EmbeddedSystemClass/2019-Animal-Collars/README.md

# 2019-Animal-Collars
GVSU Animal Tracking Collars - 2019
