EmbeddedSystemClass/2019-Animal-Collars/20190724_212704.jpg

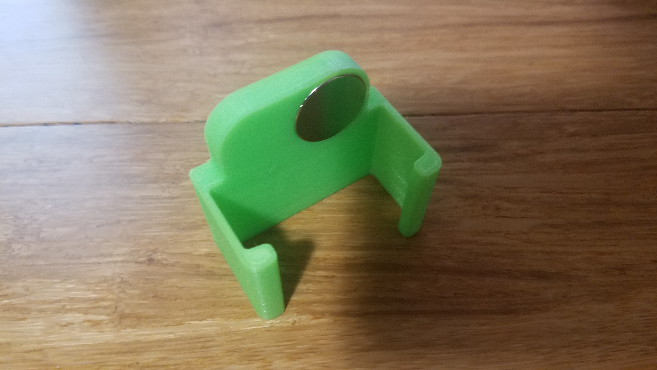
20190724_212704.jpg
