EmbeddedSystemClass/2019-Animal-Collars/Mechanical Source/2019 Animal Collar - 3D Data/2019 Animal Collar Enclosure Assembly/2019_Animal_Collar_Assm.SLDASM

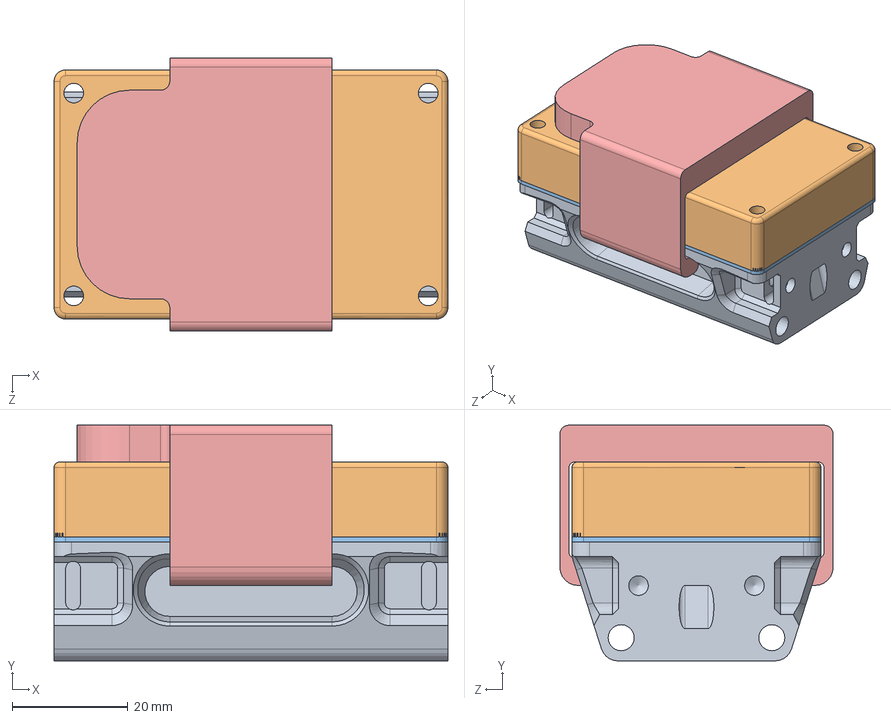
[picture p5: CAD file, 2019-07-27]
Mechanical Source/2019 Animal Collar - 3D Data/2019 Animal Collar Enclosure Assembly/2019_Animal_Collar_Assm.SLDASM
68.0 x 40.7 x 47.2 mm
Enclsoure_Bottom
Enclosure_Lid
EPDM_Gasket
pcbRevAB 6-5-19
Magnet Clip
