EmbeddedSystemClass/2019-Animal-Collars/COLLAR STRAP_CAD/COLLAR STRAP_V3/COLLAR_MEASUREMENT_PLAY.SLDASM

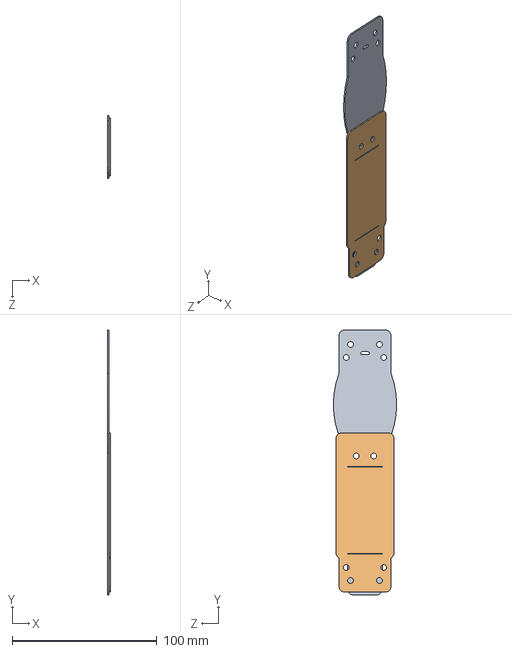
[picture p6: CAD file, 2019-09-28]
COLLAR STRAP_CAD/COLLAR STRAP_V3/COLLAR_MEASUREMENT_PLAY.SLDASM
2.00 x 183.0 x 43.7 mm
ANTENNA_STRAP 001_V3
SHORT_STRAP 001_V3
