EmbeddedSystemClass/2019-Animal-Collars/COLLAR STRAP_CAD/COLLAR STRAP_V3/SHORT_STRAP 002_V3.SLDPRT

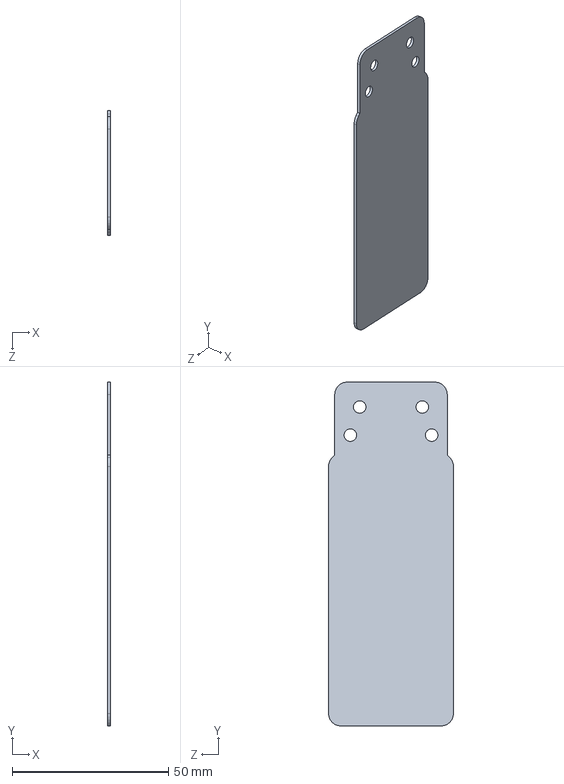
[picture p7: CAD file, 2019-09-28]
COLLAR STRAP_CAD/COLLAR STRAP_V3/SHORT_STRAP 002_V3.SLDPRT
1.00 x 110.0 x 40.0 mm
