EmbeddedSystemClass/2019-Animal-Collars/COLLAR STRAP_CAD/SMALL COLLAR/SMALL_COLLAR_V0.SLDPRT

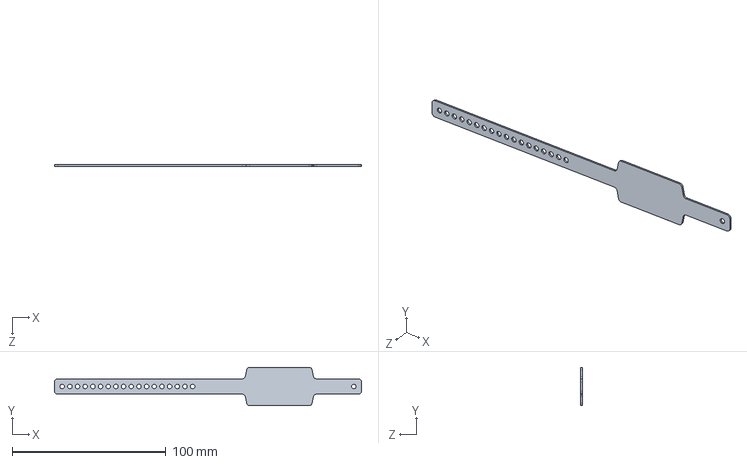
[picture p8: CAD file, 2019-09-28]
COLLAR STRAP_CAD/SMALL COLLAR/SMALL_COLLAR_V0.SLDPRT
200.0 x 25.0 x 1.00 mm
