EmbeddedSystemClass/2019-Animal-Collars/Mechanical Source/2019 Animal Collar - 3D Data/Magnet Clipsmall.STL

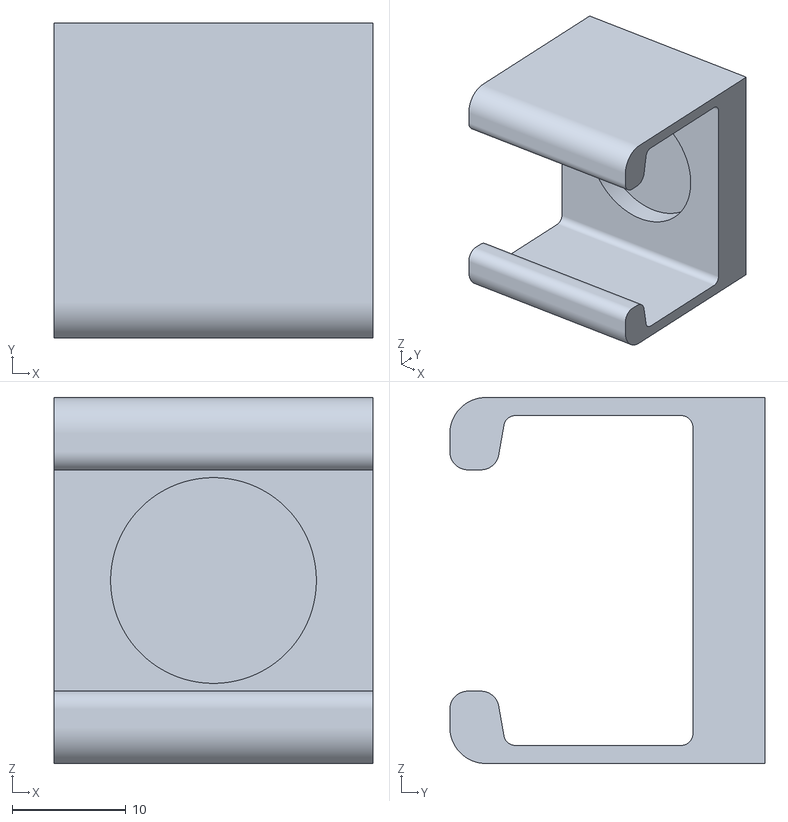
[picture p9: CAD file, 2019-08-06]
Mechanical Source/2019 Animal Collar - 3D Data/Magnet Clipsmall.STL
28.0 x 27.7 x 32.1
