EmbeddedSystemClass/2019-Animal-Collars/Mechanical Source/2019 Animal Collar - 3D Data/OBS/Magnet Clip.STL

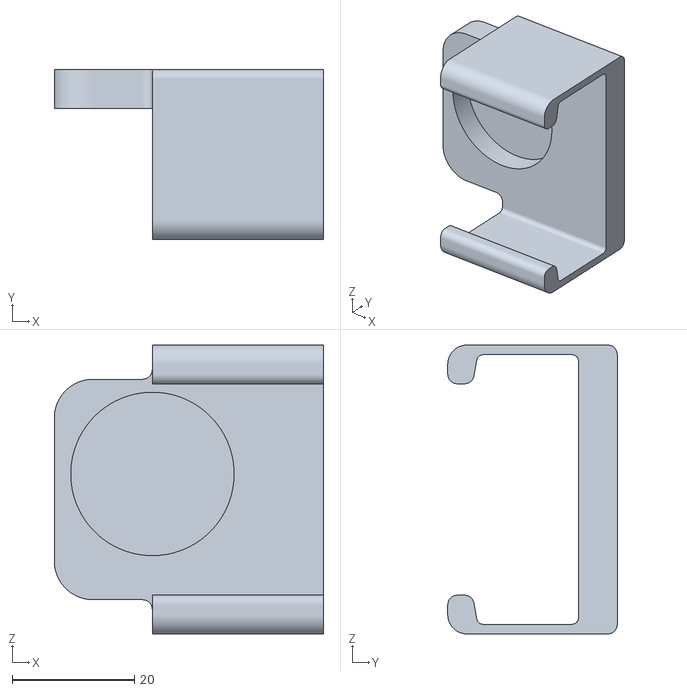
[picture p10: CAD file, 2019-07-27]
Mechanical Source/2019 Animal Collar - 3D Data/OBS/Magnet Clip.STL
44.0 x 27.7 x 47.2
