EmbeddedSystemClass/2019-Animal-Collars/COLLAR STRAP_CAD/COLLAR STRAP_V3/ANTENNA_STRAP 002_V3.SLDPRT

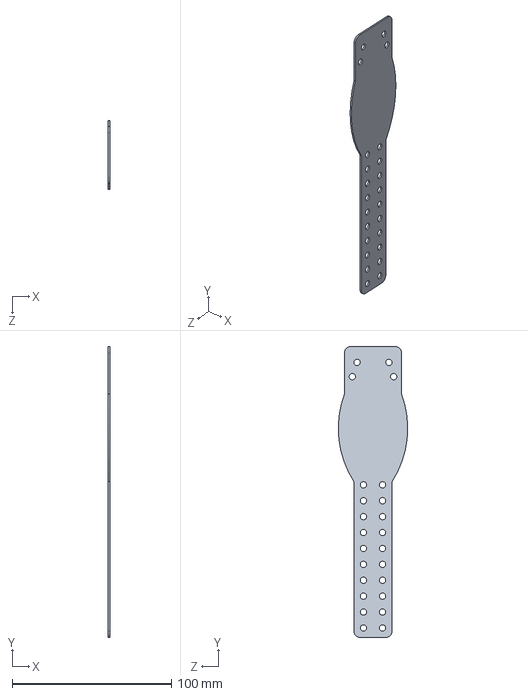
[picture p12: CAD file, 2019-09-28]
COLLAR STRAP_CAD/COLLAR STRAP_V3/ANTENNA_STRAP 002_V3.SLDPRT
1.00 x 183.0 x 43.7 mm
