EmbeddedSystemClass/2019-Animal-Collars/Mechanical Source/2019 Animal Collar - 3D Data/2019 Animal Collar Enclosure Assembly/pcbRevAB 6-5-19.SLDPRT

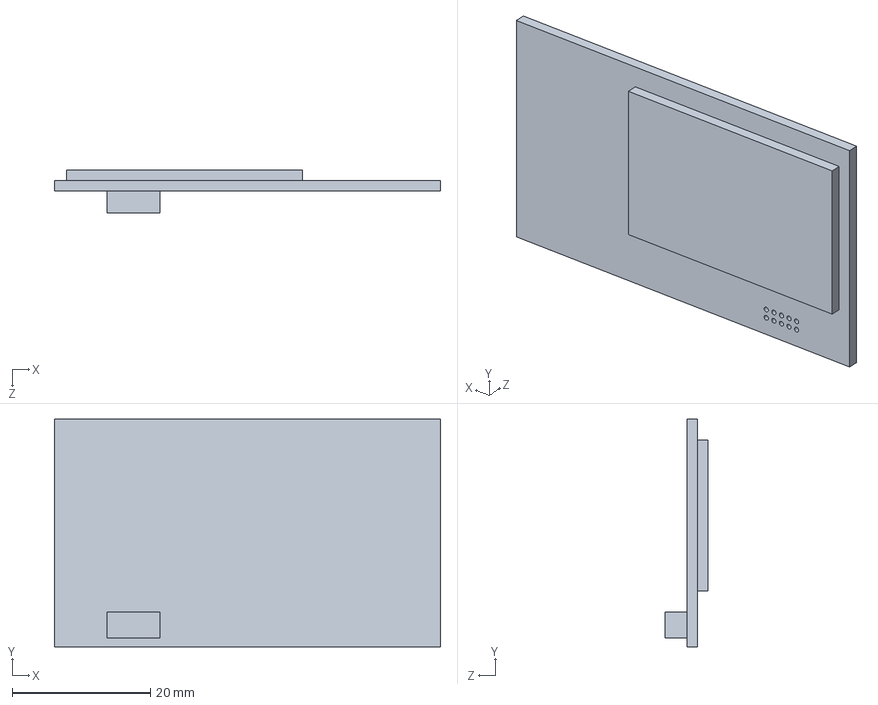
[picture p13: CAD file, 2019-07-27]
Mechanical Source/2019 Animal Collar - 3D Data/2019 Animal Collar Enclosure Assembly/pcbRevAB 6-5-19.SLDPRT
55.9 x 33.0 x 6.21 mm
