EmbeddedSystemClass/2019-Animal-Collars/Mechanical Source/2019 Animal Collar - 3D Data/Magnet Clip For Neodymium Magnet.STL

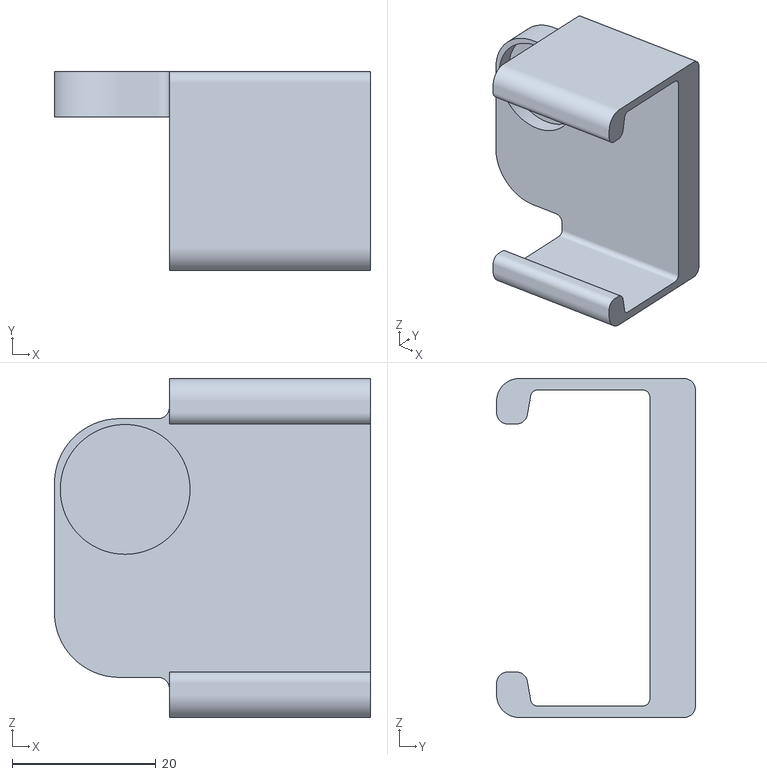
[picture p14: CAD file, 2019-07-27]
Mechanical Source/2019 Animal Collar - 3D Data/Magnet Clip For Neodymium Magnet.STL
44.0 x 27.7 x 47.2
