EmbeddedSystemClass/2019-Animal-Collars/Mechanical Source/DXF/Enclsoure_Bottom.DXF

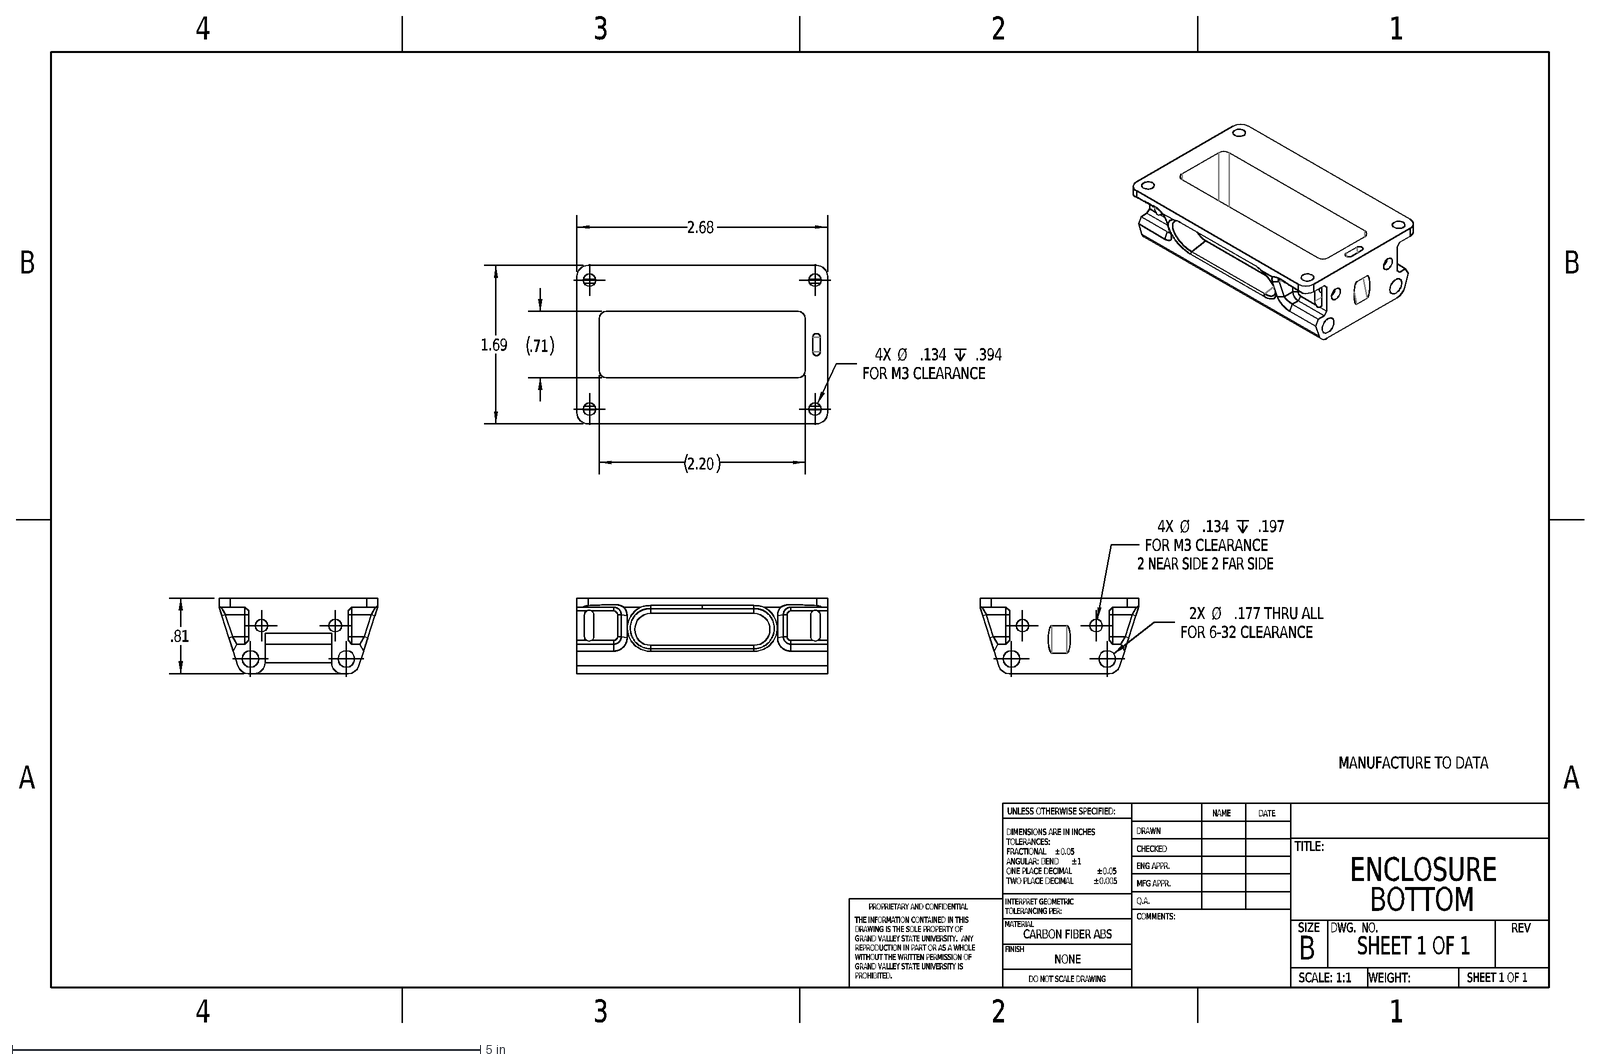
[picture p15: CAD file, 2019-07-27]
Mechanical Source/DXF/Enclsoure_Bottom.DXF
MANUFACTURE TO DATA
CARBON FIBER ABS
ENCLOSURE
BOTTOM
DO NOT SCALE DRAWING
SHEET 1 OF 1
UNLESS OTHERWISE SPECIFIED:
SCALE: 1:1
WEIGHT:
REV
DWG. NO.
B
SIZE
TITLE:
NAME
DATE
COMMENTS:
Q.A.
MFG APPR.
ENG APPR.
CHECKED
DRAWN
NONE
FINISH
MATERIAL
INTERPRET GEOMETRIC
TOLERANCING PER:
DIMENSIONS ARE IN INCHES
TOLERANCES:
FRACTIONAL
±
0.05
ANGULAR: BEND
1
ONE PLACE DECIMAL
TWO PLACE DECIMAL
0.005
PROPRIETARY AND CONFIDENTIAL
THE INFORMATION CONTAINED IN THIS
DRAWING IS THE SOLE PROPERTY OF
GRAND VALLEY STATE UNIVERSITY. ANY
REPRODUCTION IN PART OR AS A WHOLE
WITHOUT THE WRITTEN PERMISSION OF
GRAND VALLEY STATE UNIVERSITY IS
PROHIBITED.
A
4
3
2
2.68
1.69
4X
Ø
.134
.394
FOR M3 CLEARANCE
2.20
.71
.197
2 NEAR SIDE 2 FAR SIDE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
