EmbeddedSystemClass/2019-Animal-Collars/Mechanical Source/2019 Animal Collar - 3D Data/2019 Animal Collar Enclosure Assembly/Enclosure_Lid.SLDPRT

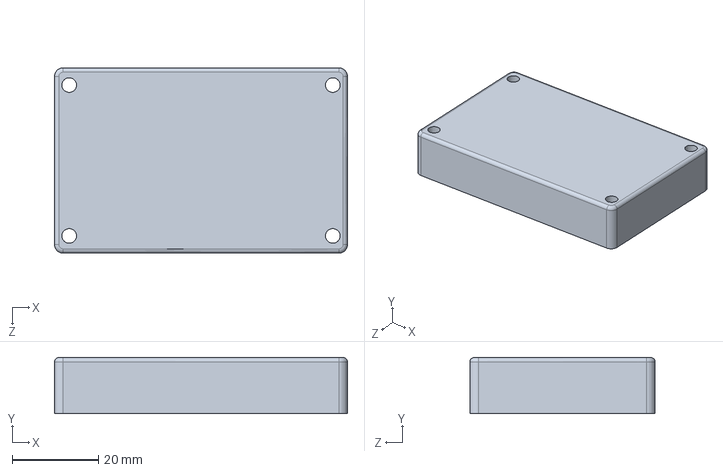
[picture p16: CAD file, 2019-07-27]
Mechanical Source/2019 Animal Collar - 3D Data/2019 Animal Collar Enclosure Assembly/Enclosure_Lid.SLDPRT
68.0 x 13.0 x 43.0 mm
