EmbeddedSystemClass/2019-Animal-Collars/Mechanical Source/2019 Animal Collar - 3D Data/2019 Animal Collar Enclosure Assembly/Enclsoure_Bottom.SLDPRT

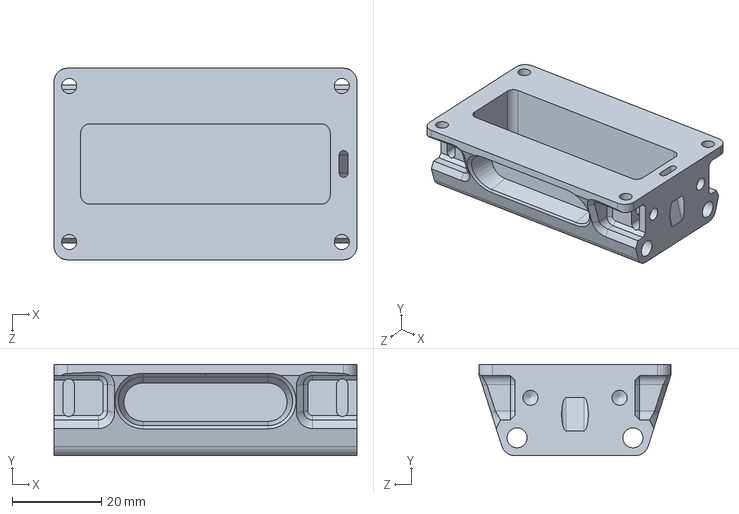
[picture p18: CAD file, 2019-07-27]
Mechanical Source/2019 Animal Collar - 3D Data/2019 Animal Collar Enclosure Assembly/Enclsoure_Bottom.SLDPRT
68.0 x 20.5 x 43.0 mm
