EmbeddedSystemClass/2019-Animal-Collars/Mechanical Source/2019 Animal Collar Enclosure Assembly/EPDM_Gasket.SLDPRT

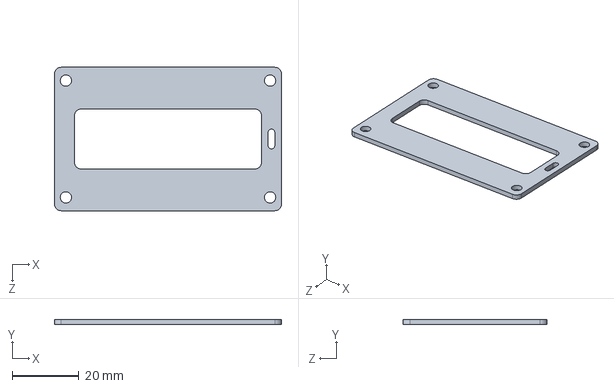
[picture p19: CAD file, 2019-07-27]
Mechanical Source/2019 Animal Collar Enclosure Assembly/EPDM_Gasket.SLDPRT
68.0 x 1.60 x 43.0 mm
