EmbeddedSystemClass/2019-Animal-Collars/Mechanical Source/DXF/2019_Animal_Collar_Assm.DXF

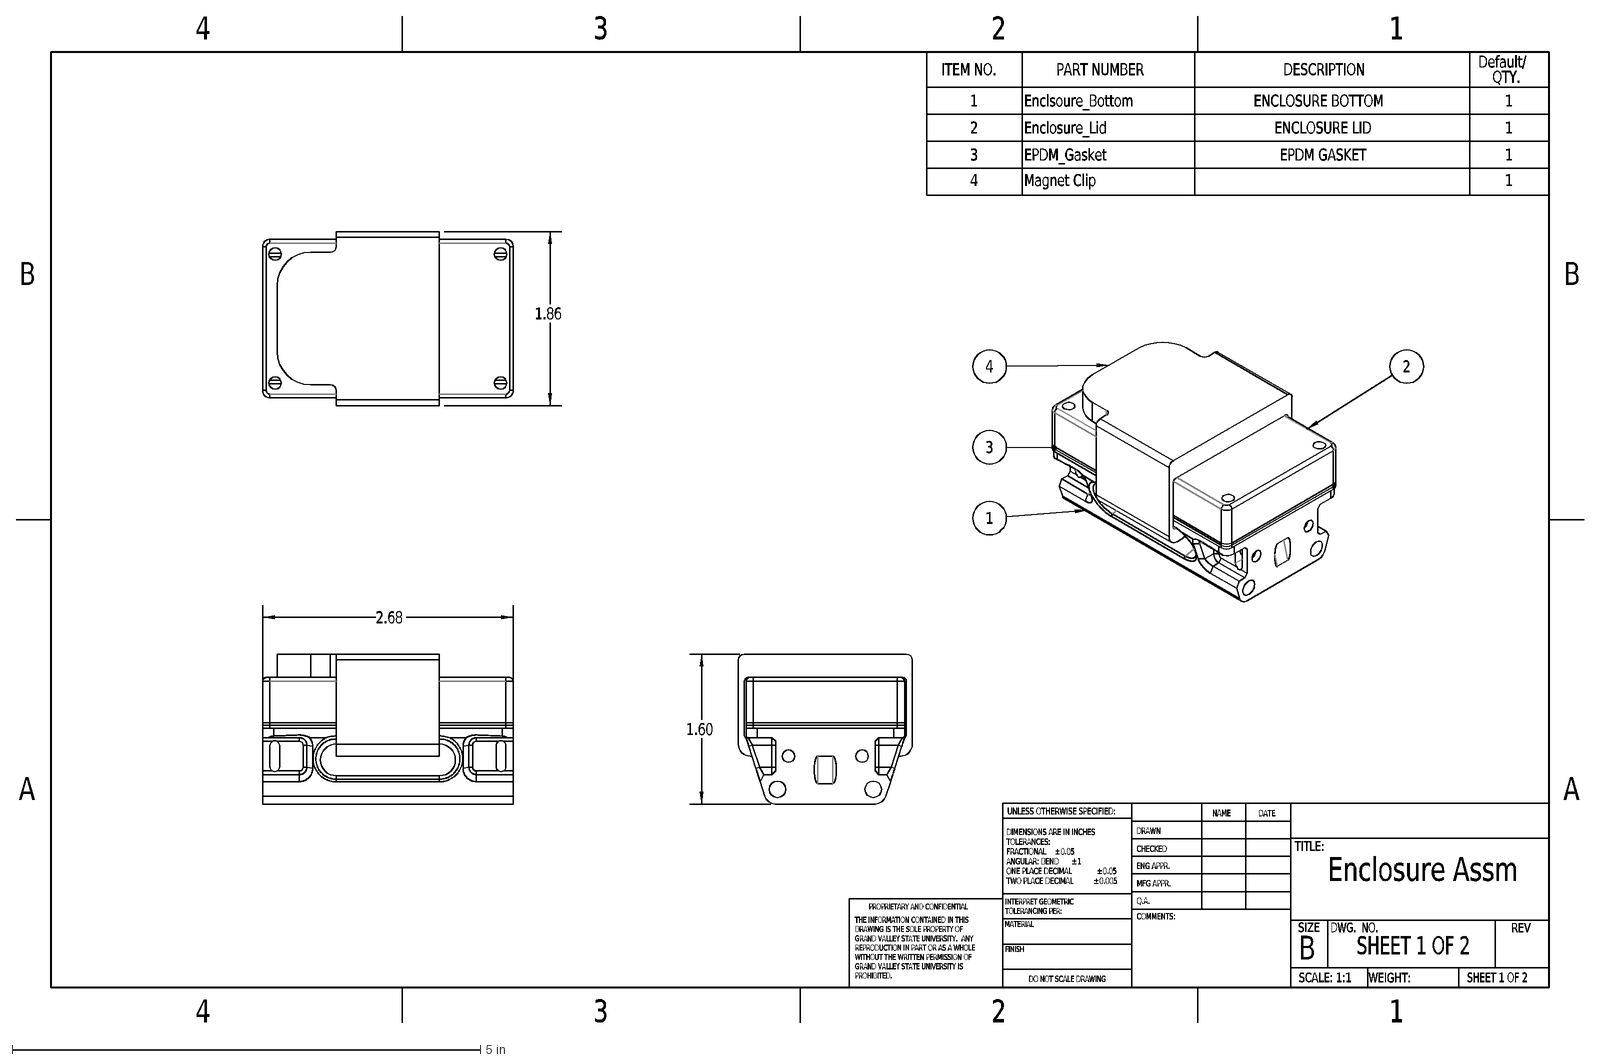
[picture p20: CAD file, 2019-07-27]
Mechanical Source/DXF/2019_Animal_Collar_Assm.DXF
A
B
4
3
2
1
Enclosure Assm
DO NOT SCALE DRAWING
SHEET 1 OF 2
UNLESS OTHERWISE SPECIFIED:
SCALE: 1:1
WEIGHT:
REV
DWG. NO.
SIZE
TITLE:
NAME
DATE
COMMENTS:
Q.A.
MFG APPR.
ENG APPR.
CHECKED
DRAWN
FINISH
MATERIAL
INTERPRET GEOMETRIC
TOLERANCING PER:
DIMENSIONS ARE IN INCHES
TOLERANCES:
FRACTIONAL
±
0.05
ANGULAR: BEND
ONE PLACE DECIMAL
TWO PLACE DECIMAL
0.005
PROPRIETARY AND CONFIDENTIAL
THE INFORMATION CONTAINED IN THIS
DRAWING IS THE SOLE PROPERTY OF
GRAND VALLEY STATE UNIVERSITY. ANY
REPRODUCTION IN PART OR AS A WHOLE
WITHOUT THE WRITTEN PERMISSION OF
GRAND VALLEY STATE UNIVERSITY IS
PROHIBITED.
ITEM NO.
PART NUMBER
DESCRIPTION
Default/
QTY.
Enclsoure_Bottom
ENCLOSURE BOTTOM
Enclosure_Lid
ENCLOSURE LID
EPDM_Gasket
EPDM GASKET
Magnet Clip
2.68
1.86
1.60
