EmbeddedSystemClass/2019-Animal-Collars/Mechanical Source/DXF/Enclosure_Lid.DXF

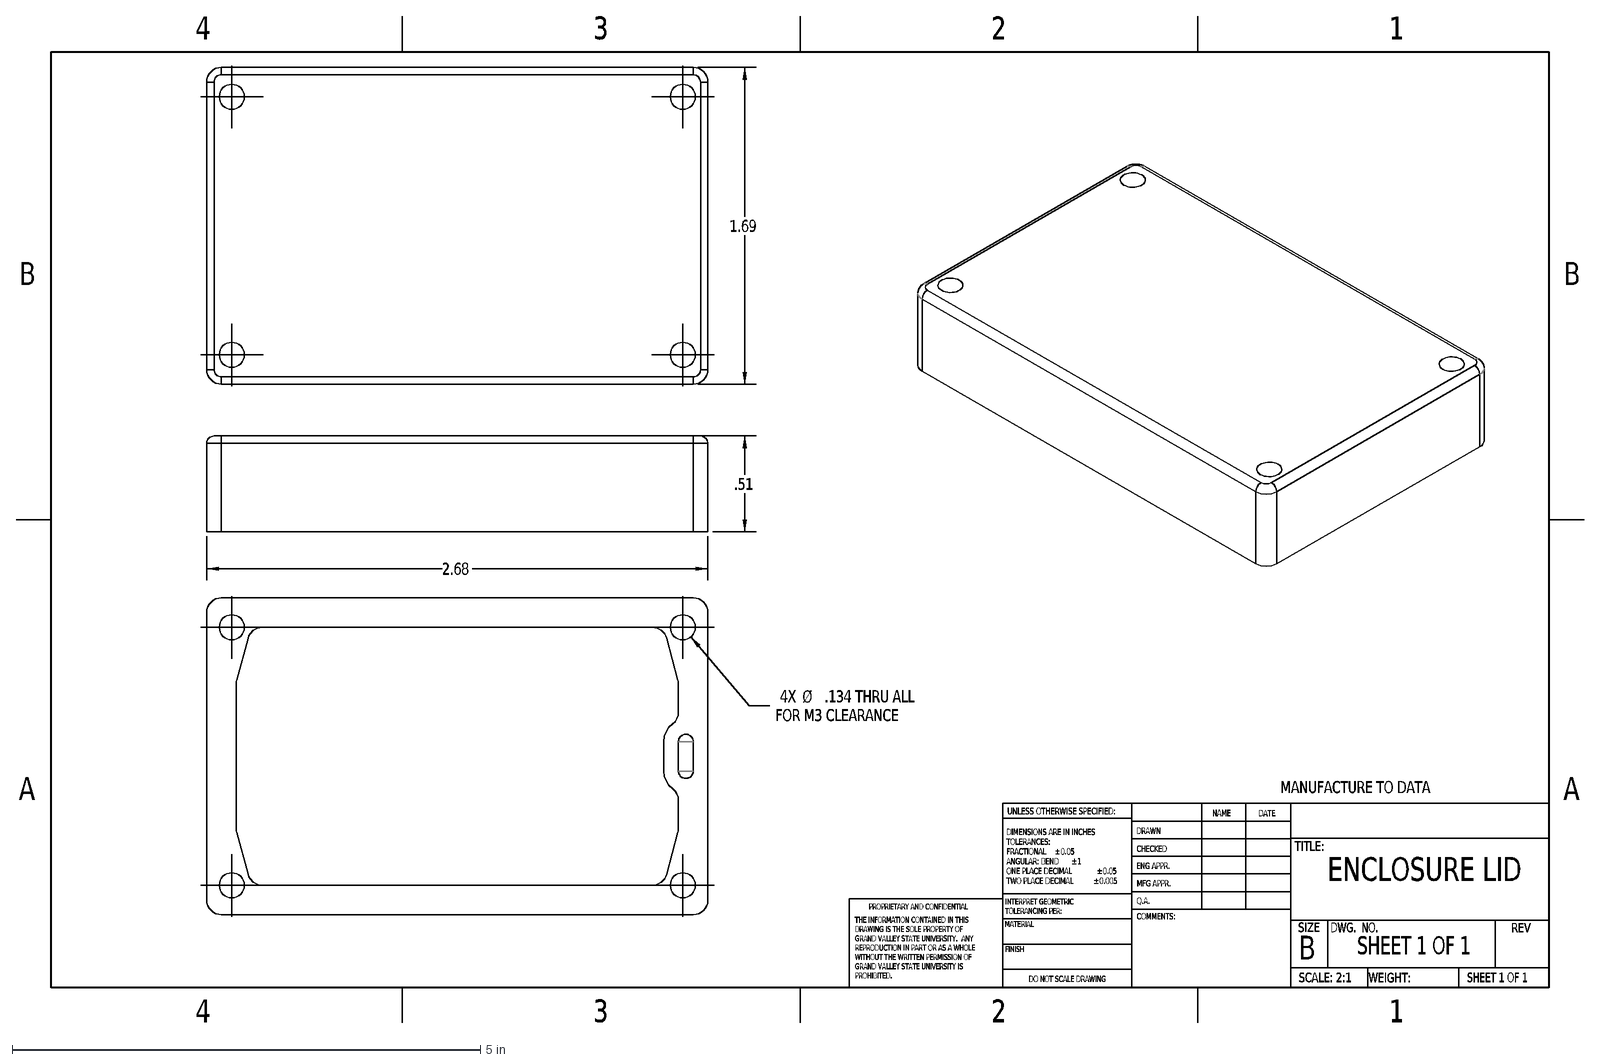
[picture p21: CAD file, 2019-07-27]
Mechanical Source/DXF/Enclosure_Lid.DXF
MANUFACTURE TO DATA
A
B
4
3
2
1
ENCLOSURE LID
DO NOT SCALE DRAWING
SHEET 1 OF 1
UNLESS OTHERWISE SPECIFIED:
SCALE: 2:1
WEIGHT:
REV
DWG. NO.
SIZE
TITLE:
NAME
DATE
COMMENTS:
Q.A.
MFG APPR.
ENG APPR.
CHECKED
DRAWN
FINISH
MATERIAL
INTERPRET GEOMETRIC
TOLERANCING PER:
DIMENSIONS ARE IN INCHES
TOLERANCES:
FRACTIONAL
±
0.05
ANGULAR: BEND
ONE PLACE DECIMAL
TWO PLACE DECIMAL
0.005
PROPRIETARY AND CONFIDENTIAL
THE INFORMATION CONTAINED IN THIS
DRAWING IS THE SOLE PROPERTY OF
GRAND VALLEY STATE UNIVERSITY. ANY
REPRODUCTION IN PART OR AS A WHOLE
WITHOUT THE WRITTEN PERMISSION OF
GRAND VALLEY STATE UNIVERSITY IS
PROHIBITED.
2.68
.51
1.69
4X
Ø
.134 THRU ALL
FOR M3 CLEARANCE
