EmbeddedSystemClass/2019-Animal-Collars/(list of files, cad)

Other CAD files:
Mechanical Source/2019 Animal Collar Enclosure Assembly/Magnet Clipsmall.SLDPRT
Mechanical Source/2019 Animal Collar Enclosure Assembly/Magnet Clip.SLDPRT
COLLAR STRAP_CAD/COLLAR STRAP_V3/SHORT_STRAP 001_V3.SLDPRT
COLLAR STRAP_CAD/COLLAR STRAP_V3/ANTENNA_STRAP 001_V3.SLDPRT
Mechanical Source/2019 Animal Collar - 3D Data/2019 Animal Collar Enclosure Assembly/Magnet Clip.SLDPRT
Mechanical Source/DXF/Magnet Clip.DXF
COLLAR STRAP_CAD/COLLAR STRAP_V2/ANTENNA_STRAP 001_V2.SLDDRW
COLLAR STRAP_CAD/COLLAR STRAP_V2/ANTENNA_STRAP 001_V2.SLDPRT
COLLAR STRAP_CAD/COLLAR STRAP_V2/ANTENNA_STRAP 001_V2_LaserCut.SLDDRW
COLLAR STRAP_CAD/COLLAR STRAP_V2/ANTENNA_STRAP 001_V2_ManualCut.SLDDRW
COLLAR STRAP_CAD/COLLAR STRAP_V2/ANTENNA_STRAP 002_V2.SLDDRW
COLLAR STRAP_CAD/COLLAR STRAP_V2/ANTENNA_STRAP 002_V2.SLDPRT
COLLAR STRAP_CAD/COLLAR STRAP_V2/ANTENNA_STRAP 002_V2_LaserCut.SLDDRW
COLLAR STRAP_CAD/COLLAR STRAP_V2/ANTENNA_STRAP 002_V2_ManualCut.SLDDRW
COLLAR STRAP_CAD/COLLAR STRAP_V2/Collar_Measurement_TESTING.SLDASM
COLLAR STRAP_CAD/COLLAR STRAP_V2/SHORT_STRAP 001_V2.SLDDRW
COLLAR STRAP_CAD/COLLAR STRAP_V2/SHORT_STRAP 001_V2.SLDPRT
COLLAR STRAP_CAD/COLLAR STRAP_V2/SHORT_STRAP 001_V2_LaserCut.SLDDRW
COLLAR STRAP_CAD/COLLAR STRAP_V2/SHORT_STRAP 001_V2_ManualCut.SLDDRW
COLLAR STRAP_CAD/COLLAR STRAP_V2/SHORT_STRAP 002_V2.SLDDRW
COLLAR STRAP_CAD/COLLAR STRAP_V2/SHORT_STRAP 002_V2.SLDPRT
COLLAR STRAP_CAD/COLLAR STRAP_V2/SHORT_STRAP 002_V2_LaserCut.SLDDRW
COLLAR STRAP_CAD/COLLAR STRAP_V2/SHORT_STRAP 002_V2_ManualCut.SLDDRW
COLLAR STRAP_CAD/COLLAR STRAP_V3/ANTENNA_STRAP 001_V3.SLDDRW
COLLAR STRAP_CAD/COLLAR STRAP_V3/ANTENNA_STRAP 001_V3_LaserCut.SLDDRW
COLLAR STRAP_CAD/COLLAR STRAP_V3/ANTENNA_STRAP 001_V3_ManualCut.SLDDRW
COLLAR STRAP_CAD/COLLAR STRAP_V3/ANTENNA_STRAP 002_V3.SLDDRW
COLLAR STRAP_CAD/COLLAR STRAP_V3/ANTENNA_STRAP 002_V3_LaserCut.SLDDRW
COLLAR STRAP_CAD/COLLAR STRAP_V3/ANTENNA_STRAP 002_V3_ManualCut.SLDDRW
COLLAR STRAP_CAD/COLLAR STRAP_V3/SHORT_STRAP 001_V3.SLDDRW
COLLAR STRAP_CAD/COLLAR STRAP_V3/SHORT_STRAP 001_V3_LaserCut.SLDDRW
COLLAR STRAP_CAD/COLLAR STRAP_V3/SHORT_STRAP 001_V3_ManualCut.SLDDRW
COLLAR STRAP_CAD/COLLAR STRAP_V3/SHORT_STRAP 002_V3.SLDDRW
COLLAR STRAP_CAD/COLLAR STRAP_V3/SHORT_STRAP 002_V3_LaserCut.SLDDRW
COLLAR STRAP_CAD/COLLAR STRAP_V3/SHORT_STRAP 002_V3_ManualCut.SLDDRW
COLLAR STRAP_CAD/SMALL COLLAR/SMALL_COLLAR_V0.SLDDRW
COLLAR STRAP_CAD/SMALL COLLAR/SMALL_COLLAR_V0_LaserCut.SLDDRW
COLLAR STRAP_CAD/SMALL COLLAR/SMALL_COLLAR_V0_ManualCut.SLDDRW
COLLAR STRAP_OBSOLETE/110MM STRAP 001.SLDPRT
COLLAR STRAP_OBSOLETE/110MM STRAP 001_LaserCut.SLDDRW
COLLAR STRAP_OBSOLETE/110MM STRAP 001_ManualCut.SLDDRW
COLLAR STRAP_OBSOLETE/110MM STRAP 001_OBSOLETE.SLDPRT
COLLAR STRAP_OBSOLETE/110MM STRAP 001_OBSOLETE_ManualCut.SLDDRW
COLLAR STRAP_OBSOLETE/110MM STRAP.DXF
COLLAR STRAP_OBSOLETE/110MM STRAP_OBSOLETE.SLDDRW
COLLAR STRAP_OBSOLETE/200MM STRAP 001.SLDPRT
COLLAR STRAP_OBSOLETE/200MM STRAP 001_LaserCut.SLDDRW
COLLAR STRAP_OBSOLETE/200MM STRAP 001_ManCut.SLDDRW
COLLAR STRAP_OBSOLETE/200MM STRAP 002.SLDPRT
COLLAR STRAP_OBSOLETE/200MM STRAP 002_ManualCut.SLDDRW
COLLAR STRAP_OBSOLETE/200MM STRAP.DXF
COLLAR STRAP_OBSOLETE/200MM STRAP.SLDDRW
COLLAR STRAP_OBSOLETE/Collar Belting_110_v0.SLDPRT
COLLAR STRAP_OBSOLETE/Collar Belting_200_v0.SLDPRT
Mechanical Source/2019 Animal Collar Enclosure Assembly/2019_Animal_Collar_Assm.SLDDRW
Mechanical Source/2019 Animal Collar Enclosure Assembly/EPDM_Gasket.SLDDRW
Mechanical Source/2019 Animal Collar Enclosure Assembly/Enclosure_Lid.SLDDRW
Mechanical Source/2019 Animal Collar Enclosure Assembly/Enclsoure_Bottom.SLDDRW
Mechanical Source/2019 Animal Collar Enclosure Assembly/Magnet Clip.SLDDRW
