EmbeddedSystemClass/2019-Animal-Collars/Electrical Source/Firmware/MDK-ARM/TEST/AnimalCollar.htm

# Static Call Graph for image TEST\AnimalCollar.axf

#<CALLGRAPH># ARM Linker, 6120001: Last Updated: Tue Aug 6 14:20:58 2019

### Maximum Stack Usage = 768 bytes + Unknown(Cycles, Untraceable Function Pointers)

### Call chain for Maximum Stack Depth:

main ⇒ GPS_subroutine ⇒ GPS_getNMEA ⇒ atoi ⇒ strtol ⇒ _strtoul

### Mutually Recursive functions

- ADC1_COMP_IRQHandler ⇒ ADC1_COMP_IRQHandler

### Function Pointers

- ADC1_COMP_IRQHandler from startup_stm32l071xx.o(.text) referenced from startup_stm32l071xx.o(RESET)
- DMA1_Channel1_IRQHandler from startup_stm32l071xx.o(.text) referenced from startup_stm32l071xx.o(RESET)
- DMA1_Channel2_3_IRQHandler from startup_stm32l071xx.o(.text) referenced from startup_stm32l071xx.o(RESET)
- DMA1_Channel4_5_6_7_IRQHandler from startup_stm32l071xx.o(.text) referenced from startup_stm32l071xx.o(RESET)
- EXTI0_1_IRQHandler from startup_stm32l071xx.o(.text) referenced from startup_stm32l071xx.o(RESET)
- EXTI2_3_IRQHandler from startup_stm32l071xx.o(.text) referenced from startup_stm32l071xx.o(RESET)
- EXTI4_15_IRQHandler from startup_stm32l071xx.o(.text) referenced from startup_stm32l071xx.o(RESET)
- FLASH_IRQHandler from startup_stm32l071xx.o(.text) referenced from startup_stm32l071xx.o(RESET)
- HardFault_Handler from stm32l0xx_it.o(.text.HardFault_Handler) referenced from startup_stm32l071xx.o(RESET)
- I2C1_IRQHandler from startup_stm32l071xx.o(.text) referenced from startup_stm32l071xx.o(RESET)
- I2C2_IRQHandler from startup_stm32l071xx.o(.text) referenced from startup_stm32l071xx.o(RESET)
- I2C3_IRQHandler from startup_stm32l071xx.o(.text) referenced from startup_stm32l071xx.o(RESET)
- LPTIM1_IRQHandler from startup_stm32l071xx.o(.text) referenced from startup_stm32l071xx.o(RESET)
- LPUART1_IRQHandler from startup_stm32l071xx.o(.text) referenced from startup_stm32l071xx.o(RESET)
- NMI_Handler from stm32l0xx_it.o(.text.NMI_Handler) referenced from startup_stm32l071xx.o(RESET)
- PVD_IRQHandler from startup_stm32l071xx.o(.text) referenced from startup_stm32l071xx.o(RESET)
- PendSV_Handler from stm32l0xx_it.o(.text.PendSV_Handler) referenced from startup_stm32l071xx.o(RESET)
- RCC_IRQHandler from startup_stm32l071xx.o(.text) referenced from startup_stm32l071xx.o(RESET)
- RTC_IRQHandler from stm32l0xx_it.o(.text.RTC_IRQHandler) referenced from startup_stm32l071xx.o(RESET)
- Reset_Handler from startup_stm32l071xx.o(.text) referenced from startup_stm32l071xx.o(RESET)
- SPI1_IRQHandler from stm32l0xx_it.o(.text.SPI1_IRQHandler) referenced from startup_stm32l071xx.o(RESET)
- SPI2_IRQHandler from startup_stm32l071xx.o(.text) referenced from startup_stm32l071xx.o(RESET)
- SVC_Handler from stm32l0xx_it.o(.text.SVC_Handler) referenced from startup_stm32l071xx.o(RESET)
- SysTick_Handler from stm32l0xx_it.o(.text.SysTick_Handler) referenced from startup_stm32l071xx.o(RESET)
- SystemInit from system_stm32l0xx.o(.text.SystemInit) referenced from startup_stm32l071xx.o(.text)
- TIM21_IRQHandler from startup_stm32l071xx.o(.text) referenced from startup_stm32l071xx.o(RESET)
- TIM22_IRQHandler from startup_stm32l071xx.o(.text) referenced from startup_stm32l071xx.o(RESET)
- TIM2_IRQHandler from stm32l0xx_it.o(.text.TIM2_IRQHandler) referenced from startup_stm32l071xx.o(RESET)
- TIM3_IRQHandler from startup_stm32l071xx.o(.text) referenced from startup_stm32l071xx.o(RESET)
- TIM6_IRQHandler from startup_stm32l071xx.o(.text) referenced from startup_stm32l071xx.o(RESET)
- TIM7_IRQHandler from startup_stm32l071xx.o(.text) referenced from startup_stm32l071xx.o(RESET)
- USART1_IRQHandler from stm32l0xx_it.o(.text.USART1_IRQHandler) referenced from startup_stm32l071xx.o(RESET)
- USART2_IRQHandler from startup_stm32l071xx.o(.text) referenced from startup_stm32l071xx.o(RESET)
- USART4_5_IRQHandler from stm32l0xx_it.o(.text.USART4_5_IRQHandler) referenced from startup_stm32l071xx.o(RESET)
- WWDG_IRQHandler from startup_stm32l071xx.o(.text) referenced from startup_stm32l071xx.o(RESET)
- __main from entry.o(.ARM.Collect$$$$00000000) referenced from startup_stm32l071xx.o(.text)
- _sputc from printfa.o(i._sputc) referenced from printfa.o(i.__0sprintf)
- main from main.o(.text.main) referenced from entry9a.o(.ARM.Collect$$$$0000000B)

### Global Symbols

__main (Thumb, 0 bytes, Stack size unknown bytes, entry.o(.ARM.Collect$$$$00000000))
[Address Reference Count : 1]

- startup_stm32l071xx.o(.text)

_main_stk (Thumb, 0 bytes, Stack size unknown bytes, entry2.o(.ARM.Collect$$$$00000001))

_main_scatterload (Thumb, 0 bytes, Stack size unknown bytes, entry5.o(.ARM.Collect$$$$00000004))

[Calls]

- >> __scatterload

__main_after_scatterload (Thumb, 0 bytes, Stack size unknown bytes, entry5.o(.ARM.Collect$$$$00000004))

[Called By]

- >> __scatterload

_main_clock (Thumb, 0 bytes, Stack size unknown bytes, entry7b.o(.ARM.Collect$$$$00000008))

_main_cpp_init (Thumb, 0 bytes, Stack size unknown bytes, entry8b.o(.ARM.Collect$$$$0000000A))

_main_init (Thumb, 0 bytes, Stack size unknown bytes, entry9a.o(.ARM.Collect$$$$0000000B))

__rt_final_cpp (Thumb, 0 bytes, Stack size unknown bytes, entry10a.o(.ARM.Collect$$$$0000000D))

__rt_final_exit (Thumb, 0 bytes, Stack size unknown bytes, entry11a.o(.ARM.Collect$$$$0000000F))

Reset_Handler (Thumb, 8 bytes, Stack size 0 bytes, startup_stm32l071xx.o(.text))
[Address Reference Count : 1]

- startup_stm32l071xx.o(RESET)

ADC1_COMP_IRQHandler (Thumb, 0 bytes, Stack size 0 bytes, startup_stm32l071xx.o(.text))

[Calls]

- >> ADC1_COMP_IRQHandler

[Called By]

- >> ADC1_COMP_IRQHandler

[Address Reference Count : 1]

- startup_stm32l071xx.o(RESET)

DMA1_Channel1_IRQHandler (Thumb, 0 bytes, Stack size 0 bytes, startup_stm32l071xx.o(.text))
[Address Reference Count : 1]

- startup_stm32l071xx.o(RESET)

DMA1_Channel2_3_IRQHandler (Thumb, 0 bytes, Stack size 0 bytes, startup_stm32l071xx.o(.text))
[Address Reference Count : 1]

- startup_stm32l071xx.o(RESET)

DMA1_Channel4_5_6_7_IRQHandler (Thumb, 0 bytes, Stack size 0 bytes, startup_stm32l071xx.o(.text))
[Address Reference Count : 1]

- startup_stm32l071xx.o(RESET)

EXTI0_1_IRQHandler (Thumb, 0 bytes, Stack size 0 bytes, startup_stm32l071xx.o(.text))
[Address Reference Count : 1]

- startup_stm32l071xx.o(RESET)

EXTI2_3_IRQHandler (Thumb, 0 bytes, Stack size 0 bytes, startup_stm32l071xx.o(.text))
[Address Reference Count : 1]

- startup_stm32l071xx.o(RESET)

EXTI4_15_IRQHandler (Thumb, 0 bytes, Stack size 0 bytes, startup_stm32l071xx.o(.text))
[Address Reference Count : 1]

- startup_stm32l071xx.o(RESET)

FLASH_IRQHandler (Thumb, 0 bytes, Stack size 0 bytes, startup_stm32l071xx.o(.text))
[Address Reference Count : 1]

- startup_stm32l071xx.o(RESET)

I2C1_IRQHandler (Thumb, 0 bytes, Stack size 0 bytes, startup_stm32l071xx.o(.text))
[Address Reference Count : 1]

- startup_stm32l071xx.o(RESET)

I2C2_IRQHandler (Thumb, 0 bytes, Stack size 0 bytes, startup_stm32l071xx.o(.text))
[Address Reference Count : 1]

- startup_stm32l071xx.o(RESET)

I2C3_IRQHandler (Thumb, 0 bytes, Stack size 0 bytes, startup_stm32l071xx.o(.text))
[Address Reference Count : 1]

- startup_stm32l071xx.o(RESET)

LPTIM1_IRQHandler (Thumb, 0 bytes, Stack size 0 bytes, startup_stm32l071xx.o(.text))
[Address Reference Count : 1]

- startup_stm32l071xx.o(RESET)

LPUART1_IRQHandler (Thumb, 0 bytes, Stack size 0 bytes, startup_stm32l071xx.o(.text))
[Address Reference Count : 1]

- startup_stm32l071xx.o(RESET)

PVD_IRQHandler (Thumb, 0 bytes, Stack size 0 bytes, startup_stm32l071xx.o(.text))
[Address Reference Count : 1]

- startup_stm32l071xx.o(RESET)

RCC_IRQHandler (Thumb, 0 bytes, Stack size 0 bytes, startup_stm32l071xx.o(.text))
[Address Reference Count : 1]

- startup_stm32l071xx.o(RESET)

SPI2_IRQHandler (Thumb, 0 bytes, Stack size 0 bytes, startup_stm32l071xx.o(.text))
[Address Reference Count : 1]

- startup_stm32l071xx.o(RESET)

TIM21_IRQHandler (Thumb, 0 bytes, Stack size 0 bytes, startup_stm32l071xx.o(.text))
[Address Reference Count : 1]

- startup_stm32l071xx.o(RESET)

TIM22_IRQHandler (Thumb, 0 bytes, Stack size 0 bytes, startup_stm32l071xx.o(.text))
[Address Reference Count : 1]

- startup_stm32l071xx.o(RESET)

TIM3_IRQHandler (Thumb, 0 bytes, Stack size 0 bytes, startup_stm32l071xx.o(.text))
[Address Reference Count : 1]

- startup_stm32l071xx.o(RESET)

TIM6_IRQHandler (Thumb, 0 bytes, Stack size 0 bytes, startup_stm32l071xx.o(.text))
[Address Reference Count : 1]

- startup_stm32l071xx.o(RESET)

TIM7_IRQHandler (Thumb, 0 bytes, Stack size 0 bytes, startup_stm32l071xx.o(.text))
[Address Reference Count : 1]

- startup_stm32l071xx.o(RESET)

USART2_IRQHandler (Thumb, 0 bytes, Stack size 0 bytes, startup_stm32l071xx.o(.text))
[Address Reference Count : 1]

- startup_stm32l071xx.o(RESET)

WWDG_IRQHandler (Thumb, 0 bytes, Stack size 0 bytes, startup_stm32l071xx.o(.text))
[Address Reference Count : 1]

- startup_stm32l071xx.o(RESET)

__aeabi_uidiv (Thumb, 0 bytes, Stack size 12 bytes, uidiv.o(.text))

[Stack]

- Max Depth = 12
- Call Chain = __aeabi_uidiv

[Called By]

- >> GPS_subroutine
- >> LL_USART_SetBaudRate
- >> LL_InitTick
- >> RCC_PLL_GetFreqDomain_SYS

__aeabi_uidivmod (Thumb, 44 bytes, Stack size 12 bytes, uidiv.o(.text))

[Stack]

- Max Depth = 12
- Call Chain = __aeabi_uidivmod

[Called By]

- >> LL_RTC_TIME_Init
- >> LL_RTC_DATE_Init
- >> _printf_core
- >> __aeabi_idivmod

__aeabi_idiv (Thumb, 0 bytes, Stack size 16 bytes, idiv.o(.text), UNUSED)

__aeabi_idivmod (Thumb, 40 bytes, Stack size 16 bytes, idiv.o(.text))

[Stack]

- Max Depth = 28
- Call Chain = __aeabi_idivmod ⇒ __aeabi_uidivmod

[Calls]

- >> __aeabi_uidivmod

[Called By]

- >> GPS_subroutine
- >> CC_SetRTC

__aeabi_memcpy (Thumb, 36 bytes, Stack size 0 bytes, memcpya.o(.text))

[Called By]

- >> XB_ConfigureDevice

__aeabi_memcpy4 (Thumb, 0 bytes, Stack size 0 bytes, memcpya.o(.text), UNUSED)

__aeabi_memcpy8 (Thumb, 0 bytes, Stack size 0 bytes, memcpya.o(.text), UNUSED)

__aeabi_memset (Thumb, 14 bytes, Stack size 0 bytes, memseta.o(.text))

[Called By]

- >> GPS_subroutine
- >> _memset$wrapper
- >> __aeabi_memclr

__aeabi_memset4 (Thumb, 0 bytes, Stack size 0 bytes, memseta.o(.text), UNUSED)

__aeabi_memset8 (Thumb, 0 bytes, Stack size 0 bytes, memseta.o(.text), UNUSED)

__aeabi_memclr (Thumb, 4 bytes, Stack size 0 bytes, memseta.o(.text))

[Calls]

- >> __aeabi_memset

[Called By]

- >> GPS_getNMEA
- >> XB_GetSN
- >> XB_GetConfig
- >> CC_ParseCommand
- >> CC_DownloadFixes
- >> XB_TransmitFixes
- >> XB_ParseCommand

__aeabi_memclr4 (Thumb, 0 bytes, Stack size 0 bytes, memseta.o(.text))

[Called By]

- >> GPS_subroutine
- >> MX_SPI1_Init

__aeabi_memclr8 (Thumb, 0 bytes, Stack size 0 bytes, memseta.o(.text), UNUSED)

_memset$wrapper (Thumb, 18 bytes, Stack size 8 bytes, memseta.o(.text), UNUSED)

[Calls]

- >> __aeabi_memset

strncpy (Thumb, 26 bytes, Stack size 8 bytes, strncpy.o(.text))

[Stack]

- Max Depth = 8
- Call Chain = strncpy

[Called By]

- >> GPS_getNMEA

strlen (Thumb, 14 bytes, Stack size 0 bytes, strlen.o(.text))

[Called By]

- >> GPS_getNMEA
- >> XB_ConfigureDevice
- >> CC_SetRTC
- >> CC_SendTimestamp
- >> CC_ReadProgram
- >> CC_ConfigureXbee
- >> XB_GetResponse

strcmp (Thumb, 28 bytes, Stack size 8 bytes, strcmp.o(.text))

[Stack]

- Max Depth = 8
- Call Chain = strcmp

[Called By]

- >> CC_ParseCommand
- >> CC_CheckForHandshake
- >> XB_ParseCommand

strtok (Thumb, 68 bytes, Stack size 16 bytes, strtok.o(.text))

[Stack]

- Max Depth = 16
- Call Chain = strtok

[Called By]

- >> GPS_getNMEA

atoi (Thumb, 26 bytes, Stack size 16 bytes, atoi.o(.text))

[Stack]

- Max Depth = 88
- Call Chain = atoi ⇒ strtol ⇒ _strtoul

[Calls]

- >> strtol
- >> __aeabi_errno_addr

[Called By]

- >> GPS_getNMEA

__aeabi_fcmple (Thumb, 28 bytes, Stack size 0 bytes, fcmple.o(.text))

[Called By]

- >> GPS_subroutine

__aeabi_fcmpgt (Thumb, 28 bytes, Stack size 0 bytes, fcmpgt.o(.text))

[Called By]

- >> GPS_subroutine

__aeabi_i2f (Thumb, 22 bytes, Stack size 8 bytes, fflti.o(.text))

[Stack]

- Max Depth = 20
- Call Chain = __aeabi_i2f ⇒ _float_epilogue

[Calls]

- >> _float_epilogue

[Called By]

- >> GPS_getNMEA

__aeabi_uldivmod (Thumb, 96 bytes, Stack size 48 bytes, uldiv.o(.text), UNUSED)

[Calls]

- >> __aeabi_llsr
- >> __aeabi_llsl

[Called By]

- >> _printf_core
- >> _fp_digits

strtol (Thumb, 108 bytes, Stack size 32 bytes, strtol.o(.text))

[Stack]

- Max Depth = 72
- Call Chain = strtol ⇒ _strtoul

[Calls]

- >> _strtoul
- >> __rt_ctype_table
- >> __aeabi_errno_addr

[Called By]

- >> atoi

__I$use$fp (Thumb, 0 bytes, Stack size 0 bytes, iusefp.o(.text), UNUSED)

_float_round (Thumb, 16 bytes, Stack size 0 bytes, fepilogue.o(.text), UNUSED)

_float_epilogue (Thumb, 114 bytes, Stack size 12 bytes, fepilogue.o(.text))

[Stack]

- Max Depth = 12
- Call Chain = _float_epilogue

[Called By]

- >> __aeabi_i2f

__aeabi_dadd (Thumb, 328 bytes, Stack size 48 bytes, dadd.o(.text), UNUSED)

[Calls]

- >> __aeabi_lasr
- >> __aeabi_llsl
- >> _double_round
- >> _double_epilogue

[Called By]

- >> __aeabi_drsub
- >> __aeabi_dsub
- >> _fp_digits

__aeabi_dsub (Thumb, 12 bytes, Stack size 8 bytes, dadd.o(.text), UNUSED)

[Calls]

- >> __aeabi_dadd

__aeabi_drsub (Thumb, 12 bytes, Stack size 8 bytes, dadd.o(.text), UNUSED)

[Calls]

- >> __aeabi_dadd

__aeabi_dmul (Thumb, 202 bytes, Stack size 72 bytes, dmul.o(.text), UNUSED)

[Calls]

- >> _double_epilogue

[Called By]

- >> _fp_digits

__aeabi_ddiv (Thumb, 234 bytes, Stack size 40 bytes, ddiv.o(.text), UNUSED)

[Calls]

- >> _double_round

[Called By]

- >> _fp_digits

__aeabi_d2ulz (Thumb, 54 bytes, Stack size 8 bytes, dfixul.o(.text), UNUSED)

[Calls]

- >> __aeabi_llsr
- >> __aeabi_llsl

[Called By]

- >> _fp_digits

__aeabi_cdrcmple (Thumb, 38 bytes, Stack size 0 bytes, cdrcmple.o(.text), UNUSED)

[Called By]

- >> _fp_digits

__scatterload (Thumb, 28 bytes, Stack size 0 bytes, init.o(.text))

[Calls]

- >> __main_after_scatterload

[Called By]

- >> _main_scatterload

__scatterload_rt2 (Thumb, 0 bytes, Stack size 0 bytes, init.o(.text), UNUSED)

__aeabi_llsl (Thumb, 32 bytes, Stack size 8 bytes, llshl.o(.text), UNUSED)

[Called By]

- >> _double_epilogue
- >> __aeabi_uldivmod
- >> __aeabi_dadd
- >> __aeabi_d2ulz

_ll_shift_l (Thumb, 0 bytes, Stack size 8 bytes, llshl.o(.text), UNUSED)

__aeabi_llsr (Thumb, 34 bytes, Stack size 8 bytes, llushr.o(.text), UNUSED)

[Called By]

- >> _double_epilogue
- >> __aeabi_uldivmod
- >> __aeabi_d2ulz

_ll_ushift_r (Thumb, 0 bytes, Stack size 8 bytes, llushr.o(.text), UNUSED)

__aeabi_lasr (Thumb, 38 bytes, Stack size 8 bytes, llsshr.o(.text), UNUSED)

[Called By]

- >> __aeabi_dadd

_ll_sshift_r (Thumb, 0 bytes, Stack size 8 bytes, llsshr.o(.text), UNUSED)

__rt_ctype_table (Thumb, 4 bytes, Stack size 0 bytes, ctype_o.o(.text))

[Called By]

- >> strtol

_strtoul (Thumb, 166 bytes, Stack size 40 bytes, _strtoul.o(.text))

[Stack]

- Max Depth = 40
- Call Chain = _strtoul

[Calls]

- >> _chval
- >> __aeabi_errno_addr

[Called By]

- >> strtol

_double_round (Thumb, 26 bytes, Stack size 8 bytes, depilogue.o(.text), UNUSED)

[Called By]

- >> _double_epilogue
- >> __aeabi_ddiv
- >> __aeabi_dadd

_double_epilogue (Thumb, 164 bytes, Stack size 48 bytes, depilogue.o(.text), UNUSED)

[Calls]

- >> __ARM_clz
- >> __aeabi_llsr
- >> __aeabi_llsl
- >> _double_round

[Called By]

- >> __aeabi_dmul
- >> __aeabi_dadd

_chval (Thumb, 30 bytes, Stack size 0 bytes, _chval.o(.text))

[Called By]

- >> _strtoul

CC_CheckForHandshake (Thumb, 184 bytes, Stack size 32 bytes, comport.o(.text.CC_CheckForHandshake))

[Stack]

- Max Depth = 104
- Call Chain = CC_CheckForHandshake ⇒ CC_SendData ⇒ CC_SendByte ⇒ LL_USART_TransmitData8

[Calls]

- >> CC_SendData
- >> strcmp

[Called By]

- >> main

CC_ComPortPresent (Thumb, 36 bytes, Stack size 4 bytes, comport.o(.text.CC_ComPortPresent))

[Stack]

- Max Depth = 4
- Call Chain = CC_ComPortPresent

[Called By]

- >> main

CC_ConfigureXbee (Thumb, 188 bytes, Stack size 40 bytes, comport.o(.text.CC_ConfigureXbee))

[Stack]

- Max Depth = 400
- Call Chain = CC_ConfigureXbee ⇒ XB_ConfigureDevice ⇒ CC_SendData ⇒ CC_SendByte ⇒ LL_USART_TransmitData8

[Calls]

- >> XB_ConfigureDevice
- >> TIM2_initDelay_inline
- >> strlen

[Called By]

- >> CC_ExecuteCommand

CC_DownloadFixes (Thumb, 332 bytes, Stack size 160 bytes, comport.o(.text.CC_DownloadFixes))

[Stack]

- Max Depth = 248
- Call Chain = CC_DownloadFixes ⇒ FLASH_readFixes ⇒ FLASH_ReadData

[Calls]

- >> FLASH_readFixes
- >> CC_SendData
- >> CC_SendByte
- >> __aeabi_memclr

[Called By]

- >> CC_ExecuteCommand

CC_ExecuteCommand (Thumb, 128 bytes, Stack size 24 bytes, comport.o(.text.CC_ExecuteCommand))

[Stack]

- Max Depth = 424
- Call Chain = CC_ExecuteCommand ⇒ CC_ConfigureXbee ⇒ XB_ConfigureDevice ⇒ CC_SendData ⇒ CC_SendByte ⇒ LL_USART_TransmitData8

[Calls]

- >> XB_GetSN
- >> XB_GetConfig
- >> FLASH_initDataStorage
- >> CC_SetRTC
- >> CC_SetProgram
- >> CC_SendTimestamp
- >> CC_ReadProgram
- >> CC_DownloadFixes
- >> CC_ConfigureXbee

[Called By]

- >> main

CC_ParseCommand (Thumb, 404 bytes, Stack size 72 bytes, comport.o(.text.CC_ParseCommand))

[Stack]

- Max Depth = 80
- Call Chain = CC_ParseCommand ⇒ strcmp

[Calls]

- >> strcmp
- >> __aeabi_memclr

[Called By]

- >> main

CC_ReadProgram (Thumb, 52 bytes, Stack size 40 bytes, comport.o(.text.CC_ReadProgram))

[Stack]

- Max Depth = 112
- Call Chain = CC_ReadProgram ⇒ CC_SendData ⇒ CC_SendByte ⇒ LL_USART_TransmitData8

[Calls]

- >> FLASH_ReadData
- >> CC_SendData
- >> strlen

[Called By]

- >> CC_ExecuteCommand

CC_SendByte (Thumb, 60 bytes, Stack size 24 bytes, comport.o(.text.CC_SendByte))

[Stack]

- Max Depth = 40
- Call Chain = CC_SendByte ⇒ LL_USART_TransmitData8

[Calls]

- >> LL_USART_TransmitData8

[Called By]

- >> CC_SendData
- >> CC_DownloadFixes
- >> XB_TransmitFixes

CC_SendData (Thumb, 64 bytes, Stack size 32 bytes, comport.o(.text.CC_SendData))

[Stack]

- Max Depth = 72
- Call Chain = CC_SendData ⇒ CC_SendByte ⇒ LL_USART_TransmitData8

[Calls]

- >> CC_SendByte

[Called By]

- >> XB_GetSN
- >> XB_GetConfig
- >> XB_ConfigureDevice
- >> CC_SetRTC
- >> CC_SendTimestamp
- >> CC_ReadProgram
- >> CC_DownloadFixes
- >> CC_CheckForHandshake
- >> XB_TransmitFixes

CC_SendTimestamp (Thumb, 160 bytes, Stack size 104 bytes, comport.o(.text.CC_SendTimestamp))

[Stack]

- Max Depth = 176
- Call Chain = CC_SendTimestamp ⇒ CC_SendData ⇒ CC_SendByte ⇒ LL_USART_TransmitData8

[Calls]

- >> CC_SendData
- >> LL_RTC_TIME_GetSecond
- >> LL_RTC_TIME_GetMinute
- >> LL_RTC_TIME_GetHour
- >> LL_RTC_DATE_GetYear
- >> LL_RTC_DATE_GetWeekDay
- >> LL_RTC_DATE_GetMonth
- >> LL_RTC_DATE_GetDay
- >> sprintf
- >> strlen

[Called By]

- >> CC_ExecuteCommand

CC_SetProgram (Thumb, 344 bytes, Stack size 88 bytes, comport.o(.text.CC_SetProgram))

[Stack]

- Max Depth = 164
- Call Chain = CC_SetProgram ⇒ EEPROM_WriteData ⇒ EEPROM_WriteByte

[Calls]

- >> TIM2_initDelay_inline
- >> FLASH_Unlock
- >> FLASH_Lock
- >> EEPROM_WriteData

[Called By]

- >> CC_ExecuteCommand

CC_SetRTC (Thumb, 484 bytes, Stack size 128 bytes, comport.o(.text.CC_SetRTC))

[Stack]

- Max Depth = 264
- Call Chain = CC_SetRTC ⇒ LL_RTC_TIME_Init ⇒ LL_RTC_TIME_Config

[Calls]

- >> TIM2_initDelay_inline
- >> LL_RTC_TIME_Init
- >> LL_RTC_DATE_Init
- >> CC_SendData
- >> LL_RTC_TIME_GetSecond
- >> LL_RTC_TIME_GetMinute
- >> LL_RTC_TIME_GetHour
- >> LL_RTC_DATE_GetYear
- >> LL_RTC_DATE_GetWeekDay
- >> LL_RTC_DATE_GetMonth
- >> LL_RTC_DATE_GetDay
- >> sprintf
- >> strlen
- >> __aeabi_idivmod

[Called By]

- >> CC_ExecuteCommand

EEPROM_WriteByte (Thumb, 34 bytes, Stack size 28 bytes, flash.o(.text.EEPROM_WriteByte))

[Stack]

- Max Depth = 28
- Call Chain = EEPROM_WriteByte

[Called By]

- >> scheduler
- >> EEPROM_WriteData

EEPROM_WriteData (Thumb, 96 bytes, Stack size 48 bytes, flash.o(.text.EEPROM_WriteData))

[Stack]

- Max Depth = 76
- Call Chain = EEPROM_WriteData ⇒ EEPROM_WriteByte

[Calls]

- >> EEPROM_WriteByte

[Called By]

- >> FLASH_saveFix
- >> FLASH_initDataStorage
- >> CC_SetProgram

Error_Handler (Thumb, 2 bytes, Stack size 0 bytes, main.o(.text.Error_Handler))

[Called By]

- >> SystemClock_Config

FLASH_Lock (Thumb, 40 bytes, Stack size 0 bytes, flash.o(.text.FLASH_Lock))

[Called By]

- >> scheduler
- >> FLASH_saveFix
- >> FLASH_initDataStorage
- >> CC_SetProgram

FLASH_ReadData (Thumb, 78 bytes, Stack size 48 bytes, flash.o(.text.FLASH_ReadData))

[Stack]

- Max Depth = 48
- Call Chain = FLASH_ReadData

[Called By]

- >> scheduler
- >> FLASH_saveFix
- >> FLASH_readFixes
- >> CC_ReadProgram

FLASH_Unlock (Thumb, 60 bytes, Stack size 4 bytes, flash.o(.text.FLASH_Unlock))

[Stack]

- Max Depth = 4
- Call Chain = FLASH_Unlock

[Called By]

- >> scheduler
- >> FLASH_saveFix
- >> FLASH_initDataStorage
- >> CC_SetProgram

FLASH_erasePage (Thumb, 104 bytes, Stack size 12 bytes, flash.o(.text.FLASH_erasePage))

[Stack]

- Max Depth = 12
- Call Chain = FLASH_erasePage

[Called By]

- >> FLASH_saveFix
- >> FLASH_initDataStorage

FLASH_initDataStorage (Thumb, 84 bytes, Stack size 48 bytes, flash.o(.text.FLASH_initDataStorage))

[Stack]

- Max Depth = 124
- Call Chain = FLASH_initDataStorage ⇒ EEPROM_WriteData ⇒ EEPROM_WriteByte

[Calls]

- >> FLASH_unlockPrgm
- >> FLASH_erasePage
- >> FLASH_Unlock
- >> FLASH_Lock
- >> EEPROM_WriteData

[Called By]

- >> CC_ExecuteCommand

FLASH_readFixes (Thumb, 140 bytes, Stack size 40 bytes, flash.o(.text.FLASH_readFixes))

[Stack]

- Max Depth = 88
- Call Chain = FLASH_readFixes ⇒ FLASH_ReadData

[Calls]

- >> FLASH_ReadData

[Called By]

- >> CC_DownloadFixes
- >> XB_TransmitFixes

FLASH_saveFix (Thumb, 436 bytes, Stack size 168 bytes, flash.o(.text.FLASH_saveFix))

[Stack]

- Max Depth = 244
- Call Chain = FLASH_saveFix ⇒ EEPROM_WriteData ⇒ EEPROM_WriteByte

[Calls]

- >> FLASH_writeWord
- >> FLASH_unlockPrgm
- >> FLASH_erasePage
- >> FLASH_Unlock
- >> FLASH_ReadData
- >> FLASH_Lock
- >> EEPROM_WriteData

[Called By]

- >> GPS_subroutine

FLASH_unlockPrgm (Thumb, 72 bytes, Stack size 4 bytes, flash.o(.text.FLASH_unlockPrgm))

[Stack]

- Max Depth = 4
- Call Chain = FLASH_unlockPrgm

[Called By]

- >> FLASH_saveFix
- >> FLASH_initDataStorage

FLASH_writeWord (Thumb, 100 bytes, Stack size 20 bytes, flash.o(.text.FLASH_writeWord))

[Stack]

- Max Depth = 20
- Call Chain = FLASH_writeWord

[Called By]

- >> FLASH_saveFix

GPS_GPSCSHigh (Thumb, 20 bytes, Stack size 0 bytes, gps.o(.text.GPS_GPSCSHigh))

[Called By]

- >> GPS_subroutine
- >> main

GPS_GPSCSLow (Thumb, 20 bytes, Stack size 0 bytes, gps.o(.text.GPS_GPSCSLow))

[Called By]

- >> GPS_subroutine

GPS_GPSDisable (Thumb, 16 bytes, Stack size 0 bytes, gps.o(.text.GPS_GPSDisable))

[Called By]

- >> GPS_subroutine
- >> main
- >> LPM_stop

GPS_GPSEnable (Thumb, 16 bytes, Stack size 0 bytes, gps.o(.text.GPS_GPSEnable))

[Called By]

- >> GPS_subroutine

GPS_UBX_enablePUBX_Position (Thumb, 104 bytes, Stack size 32 bytes, gps.o(.text.GPS_UBX_enablePUBX_Position))

[Stack]

- Max Depth = 52
- Call Chain = GPS_UBX_enablePUBX_Position ⇒ LL_SPI_TransmitData8

[Calls]

- >> LL_SPI_TransmitData8

[Called By]

- >> GPS_subroutine

GPS_getNMEA (Thumb, 924 bytes, Stack size 304 bytes, gps.o(.text.GPS_getNMEA))

[Stack]

- Max Depth = 392
- Call Chain = GPS_getNMEA ⇒ atoi ⇒ strtol ⇒ _strtoul

[Calls]

- >> __aeabi_i2f
- >> LL_USART_TransmitData8
- >> LL_SPI_TransmitData8
- >> LL_SPI_ReceiveData8
- >> atoi
- >> strtok
- >> strlen
- >> strncpy
- >> __aeabi_memclr

[Called By]

- >> GPS_subroutine

GPS_subroutine (Thumb, 812 bytes, Stack size 296 bytes, gps.o(.text.GPS_subroutine))

[Stack]

- Max Depth = 688
- Call Chain = GPS_subroutine ⇒ GPS_getNMEA ⇒ atoi ⇒ strtol ⇒ _strtoul

[Calls]

- >> __aeabi_fcmple
- >> __aeabi_fcmpgt
- >> TIM2_delay
- >> RTC_setTimeDate
- >> GPS_getNMEA
- >> GPS_UBX_enablePUBX_Position
- >> GPS_GPSEnable
- >> GPS_GPSDisable
- >> GPS_GPSCSLow
- >> GPS_GPSCSHigh
- >> FLASH_saveFix
- >> TIM2_initDelay_inline
- >> __aeabi_memclr4
- >> __aeabi_memset
- >> __aeabi_idivmod
- >> __aeabi_uidiv

[Called By]

- >> main

HardFault_Handler (Thumb, 10 bytes, Stack size 8 bytes, stm32l0xx_it.o(.text.HardFault_Handler))

[Stack]

- Max Depth = 8
- Call Chain = HardFault_Handler

[Calls]

- >> NVIC_SystemReset

[Address Reference Count : 1]

- startup_stm32l071xx.o(RESET)

LL_GPIO_Init (Thumb, 222 bytes, Stack size 40 bytes, stm32l0xx_ll_gpio.o(.text.LL_GPIO_Init))

[Stack]

- Max Depth = 80
- Call Chain = LL_GPIO_Init ⇒ LL_GPIO_SetPinSpeed

[Calls]

- >> LL_GPIO_SetPinSpeed
- >> LL_GPIO_SetPinPull
- >> LL_GPIO_SetPinOutputType
- >> LL_GPIO_SetPinMode
- >> LL_GPIO_SetAFPin_8_15
- >> LL_GPIO_SetAFPin_0_7

[Called By]

- >> LPM_stop
- >> LPM_gpioInit
- >> MX_USART4_UART_Init
- >> MX_USART1_UART_Init
- >> MX_SPI1_Init
- >> MX_GPIO_Init

LL_Init1msTick (Thumb, 26 bytes, Stack size 16 bytes, stm32l0xx_ll_utils.o(.text.LL_Init1msTick))

[Stack]

- Max Depth = 52
- Call Chain = LL_Init1msTick ⇒ LL_InitTick ⇒ __aeabi_uidiv

[Calls]

- >> LL_InitTick

[Called By]

- >> SystemClock_Config

LL_RCC_GetSystemClocksFreq (Thumb, 58 bytes, Stack size 16 bytes, stm32l0xx_ll_rcc.o(.text.LL_RCC_GetSystemClocksFreq))

[Stack]

- Max Depth = 68
- Call Chain = LL_RCC_GetSystemClocksFreq ⇒ RCC_GetSystemClockFreq ⇒ RCC_PLL_GetFreqDomain_SYS ⇒ __aeabi_uidiv

[Calls]

- >> RCC_GetSystemClockFreq
- >> RCC_GetPCLK2ClockFreq
- >> RCC_GetPCLK1ClockFreq
- >> RCC_GetHCLKClockFreq

[Called By]

- >> LL_USART_Init

LL_RCC_GetUSARTClockFreq (Thumb, 292 bytes, Stack size 32 bytes, stm32l0xx_ll_rcc.o(.text.LL_RCC_GetUSARTClockFreq))

[Stack]

- Max Depth = 84
- Call Chain = LL_RCC_GetUSARTClockFreq ⇒ RCC_GetSystemClockFreq ⇒ RCC_PLL_GetFreqDomain_SYS ⇒ __aeabi_uidiv

[Calls]

- >> LL_RCC_LSE_IsReady
- >> LL_RCC_IsActiveFlag_HSIDIV
- >> LL_RCC_HSI_IsReady
- >> LL_RCC_GetUSARTClockSource
- >> RCC_GetSystemClockFreq
- >> RCC_GetPCLK2ClockFreq
- >> RCC_GetPCLK1ClockFreq
- >> RCC_GetHCLKClockFreq

[Called By]

- >> LL_USART_Init

LL_RTC_DATE_Init (Thumb, 272 bytes, Stack size 72 bytes, stm32l0xx_ll_rtc.o(.text.LL_RTC_DATE_Init))

[Stack]

- Max Depth = 136
- Call Chain = LL_RTC_DATE_Init ⇒ LL_RTC_DATE_Config

[Calls]

- >> LL_RTC_WaitForSynchro
- >> LL_RTC_EnterInitMode
- >> LL_RTC_IsShadowRegBypassEnabled
- >> LL_RTC_EnableWriteProtection
- >> LL_RTC_DisableWriteProtection
- >> LL_RTC_DisableInitMode
- >> LL_RTC_DATE_Config
- >> __aeabi_uidivmod

[Called By]

- >> RTC_setTimeDate
- >> CC_SetRTC
- >> MX_RTC_Init

LL_RTC_EnterInitMode (Thumb, 138 bytes, Stack size 32 bytes, stm32l0xx_ll_rtc.o(.text.LL_RTC_EnterInitMode))

[Stack]

- Max Depth = 40
- Call Chain = LL_RTC_EnterInitMode ⇒ LL_RTC_IsActiveFlag_INIT

[Calls]

- >> LL_SYSTICK_IsActiveCounterFlag
- >> LL_RTC_IsActiveFlag_INIT
- >> LL_RTC_EnableInitMode

[Called By]

- >> LL_RTC_TIME_Init
- >> LL_RTC_DATE_Init
- >> LL_RTC_Init

LL_RTC_Init (Thumb, 98 bytes, Stack size 32 bytes, stm32l0xx_ll_rtc.o(.text.LL_RTC_Init))

[Stack]

- Max Depth = 72
- Call Chain = LL_RTC_Init ⇒ LL_RTC_EnterInitMode ⇒ LL_RTC_IsActiveFlag_INIT

[Calls]

- >> LL_RTC_EnterInitMode
- >> LL_RTC_SetSynchPrescaler
- >> LL_RTC_SetHourFormat
- >> LL_RTC_SetAsynchPrescaler
- >> LL_RTC_EnableWriteProtection
- >> LL_RTC_DisableWriteProtection
- >> LL_RTC_DisableInitMode

[Called By]

- >> MX_RTC_Init

LL_RTC_TIME_Init (Thumb, 284 bytes, Stack size 72 bytes, stm32l0xx_ll_rtc.o(.text.LL_RTC_TIME_Init))

[Stack]

- Max Depth = 136
- Call Chain = LL_RTC_TIME_Init ⇒ LL_RTC_TIME_Config

[Calls]

- >> LL_RTC_WaitForSynchro
- >> LL_RTC_EnterInitMode
- >> LL_RTC_TIME_Config
- >> LL_RTC_IsShadowRegBypassEnabled
- >> LL_RTC_GetHourFormat
- >> LL_RTC_EnableWriteProtection
- >> LL_RTC_DisableWriteProtection
- >> LL_RTC_DisableInitMode
- >> __aeabi_uidivmod

[Called By]

- >> RTC_setTimeDate
- >> CC_SetRTC
- >> MX_RTC_Init

LL_RTC_WaitForSynchro (Thumb, 240 bytes, Stack size 48 bytes, stm32l0xx_ll_rtc.o(.text.LL_RTC_WaitForSynchro))

[Stack]

- Max Depth = 56
- Call Chain = LL_RTC_WaitForSynchro ⇒ LL_RTC_IsActiveFlag_RS

[Calls]

- >> LL_SYSTICK_IsActiveCounterFlag
- >> LL_RTC_IsActiveFlag_RS
- >> LL_RTC_ClearFlag_RS

[Called By]

- >> LL_RTC_TIME_Init
- >> LL_RTC_DATE_Init

LL_SPI_Init (Thumb, 160 bytes, Stack size 32 bytes, stm32l0xx_ll_spi.o(.text.LL_SPI_Init))

[Stack]

- Max Depth = 48
- Call Chain = LL_SPI_Init ⇒ LL_SPI_SetCRCPolynomial

[Calls]

- >> LL_SPI_SetCRCPolynomial
- >> LL_SPI_IsEnabled

[Called By]

- >> MX_SPI1_Init

LL_SetSystemCoreClock (Thumb, 24 bytes, Stack size 8 bytes, stm32l0xx_ll_utils.o(.text.LL_SetSystemCoreClock))

[Stack]

- Max Depth = 8
- Call Chain = LL_SetSystemCoreClock

[Called By]

- >> SystemClock_Config

LL_TIM_Init (Thumb, 192 bytes, Stack size 32 bytes, stm32l0xx_ll_tim.o(.text.LL_TIM_Init))

[Stack]

- Max Depth = 48
- Call Chain = LL_TIM_Init ⇒ LL_TIM_SetPrescaler

[Calls]

- >> LL_TIM_SetPrescaler
- >> LL_TIM_SetAutoReload
- >> LL_TIM_GenerateEvent_UPDATE

[Called By]

- >> MX_TIM2_Init

LL_USART_Init (Thumb, 256 bytes, Stack size 56 bytes, stm32l0xx_ll_usart.o(.text.LL_USART_Init))

[Stack]

- Max Depth = 140
- Call Chain = LL_USART_Init ⇒ LL_RCC_GetUSARTClockFreq ⇒ RCC_GetSystemClockFreq ⇒ RCC_PLL_GetFreqDomain_SYS ⇒ __aeabi_uidiv

[Calls]

- >> LL_RCC_GetUSARTClockFreq
- >> LL_USART_SetStopBitsLength
- >> LL_USART_SetHWFlowCtrl
- >> LL_USART_SetBaudRate
- >> LL_USART_IsEnabled
- >> LL_RCC_GetSystemClocksFreq

[Called By]

- >> MX_USART4_UART_Init
- >> MX_USART1_UART_Init

LPM_gpioInit (Thumb, 192 bytes, Stack size 80 bytes, lowpower.o(.text.LPM_gpioInit))

[Stack]

- Max Depth = 160
- Call Chain = LPM_gpioInit ⇒ LL_GPIO_Init ⇒ LL_GPIO_SetPinSpeed

[Calls]

- >> LL_GPIO_Init

[Called By]

- >> main

LPM_stop (Thumb, 320 bytes, Stack size 80 bytes, lowpower.o(.text.LPM_stop))

[Stack]

- Max Depth = 160
- Call Chain = LPM_stop ⇒ LL_GPIO_Init ⇒ LL_GPIO_SetPinSpeed

[Calls]

- >> GPS_GPSDisable
- >> LL_USART_Enable
- >> LL_APB2_GRP1_DisableClock
- >> LL_APB1_GRP1_DisableClock
- >> LL_GPIO_Init
- >> XB_DisableXbee

[Called By]

- >> main

NMI_Handler (Thumb, 2 bytes, Stack size 0 bytes, stm32l0xx_it.o(.text.NMI_Handler))
[Address Reference Count : 1]

- startup_stm32l071xx.o(RESET)

PendSV_Handler (Thumb, 2 bytes, Stack size 0 bytes, stm32l0xx_it.o(.text.PendSV_Handler))
[Address Reference Count : 1]

- startup_stm32l071xx.o(RESET)

RCC_GetHCLKClockFreq (Thumb, 40 bytes, Stack size 24 bytes, stm32l0xx_ll_rcc.o(.text.RCC_GetHCLKClockFreq))

[Stack]

- Max Depth = 24
- Call Chain = RCC_GetHCLKClockFreq

[Calls]

- >> LL_RCC_GetAHBPrescaler

[Called By]

- >> LL_RCC_GetUSARTClockFreq
- >> LL_RCC_GetSystemClocksFreq

RCC_GetPCLK1ClockFreq (Thumb, 40 bytes, Stack size 24 bytes, stm32l0xx_ll_rcc.o(.text.RCC_GetPCLK1ClockFreq))

[Stack]

- Max Depth = 24
- Call Chain = RCC_GetPCLK1ClockFreq

[Calls]

- >> LL_RCC_GetAPB1Prescaler

[Called By]

- >> LL_RCC_GetUSARTClockFreq
- >> LL_RCC_GetSystemClocksFreq

RCC_GetPCLK2ClockFreq (Thumb, 40 bytes, Stack size 24 bytes, stm32l0xx_ll_rcc.o(.text.RCC_GetPCLK2ClockFreq))

[Stack]

- Max Depth = 24
- Call Chain = RCC_GetPCLK2ClockFreq

[Calls]

- >> LL_RCC_GetAPB2Prescaler

[Called By]

- >> LL_RCC_GetUSARTClockFreq
- >> LL_RCC_GetSystemClocksFreq

RCC_GetSystemClockFreq (Thumb, 136 bytes, Stack size 16 bytes, stm32l0xx_ll_rcc.o(.text.RCC_GetSystemClockFreq))

[Stack]

- Max Depth = 52
- Call Chain = RCC_GetSystemClockFreq ⇒ RCC_PLL_GetFreqDomain_SYS ⇒ __aeabi_uidiv

[Calls]

- >> LL_RCC_MSI_GetRange
- >> LL_RCC_IsActiveFlag_HSIDIV
- >> LL_RCC_GetSysClkSource
- >> RCC_PLL_GetFreqDomain_SYS

[Called By]

- >> LL_RCC_GetUSARTClockFreq
- >> LL_RCC_GetSystemClocksFreq

RCC_PLL_GetFreqDomain_SYS (Thumb, 104 bytes, Stack size 24 bytes, stm32l0xx_ll_rcc.o(.text.RCC_PLL_GetFreqDomain_SYS))

[Stack]

- Max Depth = 36
- Call Chain = RCC_PLL_GetFreqDomain_SYS ⇒ __aeabi_uidiv

[Calls]

- >> LL_RCC_PLL_GetMultiplicator
- >> LL_RCC_PLL_GetMainSource
- >> LL_RCC_PLL_GetDivider
- >> LL_RCC_IsActiveFlag_HSIDIV
- >> __aeabi_uidiv

[Called By]

- >> RCC_GetSystemClockFreq

RTC_IRQHandler (Thumb, 64 bytes, Stack size 0 bytes, stm32l0xx_it.o(.text.RTC_IRQHandler))
[Address Reference Count : 1]

- startup_stm32l071xx.o(RESET)

RTC_getTimeDate (Thumb, 108 bytes, Stack size 32 bytes, timers.o(.text.RTC_getTimeDate))

[Stack]

- Max Depth = 44
- Call Chain = RTC_getTimeDate ⇒ LL_RTC_TIME_GetSecond

[Calls]

- >> LL_RTC_TIME_GetSecond
- >> LL_RTC_TIME_GetMinute
- >> LL_RTC_TIME_GetHour
- >> LL_RTC_TIME_GetFormat
- >> LL_RTC_DATE_GetYear
- >> LL_RTC_DATE_GetWeekDay
- >> LL_RTC_DATE_GetMonth
- >> LL_RTC_DATE_GetDay

[Called By]

- >> scheduler

RTC_initAlarm (Thumb, 104 bytes, Stack size 16 bytes, timers.o(.text.RTC_initAlarm))

[Stack]

- Max Depth = 32
- Call Chain = RTC_initAlarm ⇒ LL_RTC_ALMA_SetSecond

[Calls]

- >> LL_RTC_EnableWriteProtection
- >> LL_RTC_DisableWriteProtection
- >> LL_RTC_ALMA_SetSecond
- >> LL_RTC_ALMA_SetMask
- >> LL_RTC_ALMA_Enable
- >> LL_RTC_ALMA_Disable

[Called By]

- >> main

RTC_setTimeDate (Thumb, 80 bytes, Stack size 64 bytes, timers.o(.text.RTC_setTimeDate))

[Stack]

- Max Depth = 200
- Call Chain = RTC_setTimeDate ⇒ LL_RTC_TIME_Init ⇒ LL_RTC_TIME_Config

[Calls]

- >> LL_RTC_TIME_Init
- >> LL_RTC_DATE_Init

[Called By]

- >> GPS_subroutine

SPI1_IRQHandler (Thumb, 2 bytes, Stack size 0 bytes, stm32l0xx_it.o(.text.SPI1_IRQHandler))
[Address Reference Count : 1]

- startup_stm32l071xx.o(RESET)

SVC_Handler (Thumb, 2 bytes, Stack size 0 bytes, stm32l0xx_it.o(.text.SVC_Handler))
[Address Reference Count : 1]

- startup_stm32l071xx.o(RESET)

SysTick_Handler (Thumb, 2 bytes, Stack size 0 bytes, stm32l0xx_it.o(.text.SysTick_Handler))
[Address Reference Count : 1]

- startup_stm32l071xx.o(RESET)

SystemClock_Config (Thumb, 190 bytes, Stack size 24 bytes, main.o(.text.SystemClock_Config))

[Stack]

- Max Depth = 76
- Call Chain = SystemClock_Config ⇒ LL_Init1msTick ⇒ LL_InitTick ⇒ __aeabi_uidiv

[Calls]

- >> LL_SetSystemCoreClock
- >> LL_Init1msTick
- >> Error_Handler
- >> LL_SYSTICK_SetClkSource
- >> LL_RCC_SetUSARTClockSource
- >> LL_RCC_SetSysClkSource
- >> LL_RCC_SetRTCClockSource
- >> LL_RCC_SetAPB2Prescaler
- >> LL_RCC_SetAPB1Prescaler
- >> LL_RCC_SetAHBPrescaler
- >> LL_RCC_ReleaseBackupDomainReset
- >> LL_RCC_MSI_SetRange
- >> LL_RCC_MSI_SetCalibTrimming
- >> LL_RCC_MSI_IsReady
- >> LL_RCC_MSI_Enable
- >> LL_RCC_LSE_SetDriveCapability
- >> LL_RCC_LSE_IsReady
- >> LL_RCC_LSE_Enable
- >> LL_RCC_GetSysClkSource
- >> LL_RCC_ForceBackupDomainReset
- >> LL_RCC_EnableRTC
- >> LL_PWR_SetRegulVoltageScaling
- >> LL_PWR_EnableBkUpAccess
- >> LL_FLASH_SetLatency
- >> LL_FLASH_GetLatency

[Called By]

- >> main

SystemInit (Thumb, 100 bytes, Stack size 8 bytes, system_stm32l0xx.o(.text.SystemInit))

[Stack]

- Max Depth = 8
- Call Chain = SystemInit

[Address Reference Count : 1]

- startup_stm32l071xx.o(.text)

TIM2_IRQHandler (Thumb, 2 bytes, Stack size 0 bytes, stm32l0xx_it.o(.text.TIM2_IRQHandler))
[Address Reference Count : 1]

- startup_stm32l071xx.o(RESET)

TIM2_delay (Thumb, 72 bytes, Stack size 8 bytes, timers.o(.text.TIM2_delay))

[Stack]

- Max Depth = 8
- Call Chain = TIM2_delay

[Called By]

- >> GPS_subroutine
- >> main
- >> XB_EnableXbee

TIM2_init (Thumb, 36 bytes, Stack size 0 bytes, timers.o(.text.TIM2_init))

[Called By]

- >> main

TIM2_initDelay_inline (Thumb, 52 bytes, Stack size 8 bytes, timers.o(.text.TIM2_initDelay_inline))

[Stack]

- Max Depth = 8
- Call Chain = TIM2_initDelay_inline

[Called By]

- >> GPS_subroutine
- >> CC_SetRTC
- >> CC_SetProgram
- >> CC_ConfigureXbee
- >> main
- >> XB_XbeeSubroutine
- >> XB_GetResponse

USART1_IRQHandler (Thumb, 76 bytes, Stack size 0 bytes, stm32l0xx_it.o(.text.USART1_IRQHandler))
[Address Reference Count : 1]

- startup_stm32l071xx.o(RESET)

USART4_5_IRQHandler (Thumb, 56 bytes, Stack size 0 bytes, stm32l0xx_it.o(.text.USART4_5_IRQHandler))
[Address Reference Count : 1]

- startup_stm32l071xx.o(RESET)

VHF_DisableVHF (Thumb, 16 bytes, Stack size 0 bytes, xbee.o(.text.VHF_DisableVHF))

[Called By]

- >> main

VHF_EnableVHF (Thumb, 16 bytes, Stack size 0 bytes, xbee.o(.text.VHF_EnableVHF))

[Called By]

- >> main

XB_CheckForDongle (Thumb, 184 bytes, Stack size 40 bytes, xbee.o(.text.XB_CheckForDongle))

[Stack]

- Max Depth = 80
- Call Chain = XB_CheckForDongle ⇒ XB_SendByte ⇒ LL_USART_TransmitData8

[Calls]

- >> XB_SendByte

[Called By]

- >> XB_XbeeSubroutine

XB_ConfigureDevice (Thumb, 648 bytes, Stack size 288 bytes, xbee.o(.text.XB_ConfigureDevice))

[Stack]

- Max Depth = 360
- Call Chain = XB_ConfigureDevice ⇒ CC_SendData ⇒ CC_SendByte ⇒ LL_USART_TransmitData8

[Calls]

- >> CC_SendData
- >> XB_SendData
- >> XB_SendByte
- >> XB_GetResponse
- >> XB_EnableXbee
- >> XB_DisableXbee
- >> strlen
- >> __aeabi_memcpy

[Called By]

- >> CC_ConfigureXbee

XB_DisableXbee (Thumb, 16 bytes, Stack size 0 bytes, xbee.o(.text.XB_DisableXbee))

[Called By]

- >> XB_GetSN
- >> XB_GetConfig
- >> XB_ConfigureDevice
- >> main
- >> LPM_stop
- >> XB_XbeeSubroutine

XB_EnableXbee (Thumb, 32 bytes, Stack size 16 bytes, xbee.o(.text.XB_EnableXbee))

[Stack]

- Max Depth = 24
- Call Chain = XB_EnableXbee ⇒ TIM2_delay

[Calls]

- >> TIM2_delay

[Called By]

- >> XB_GetSN
- >> XB_GetConfig
- >> XB_ConfigureDevice
- >> XB_XbeeSubroutine

XB_ExecuteCommand (Thumb, 40 bytes, Stack size 24 bytes, xbee.o(.text.XB_ExecuteCommand))

[Stack]

- Max Depth = 272
- Call Chain = XB_ExecuteCommand ⇒ XB_TransmitFixes ⇒ FLASH_readFixes ⇒ FLASH_ReadData

[Calls]

- >> XB_TransmitFixes

[Called By]

- >> XB_XbeeSubroutine

XB_GetConfig (Thumb, 176 bytes, Stack size 128 bytes, xbee.o(.text.XB_GetConfig))

[Stack]

- Max Depth = 200
- Call Chain = XB_GetConfig ⇒ CC_SendData ⇒ CC_SendByte ⇒ LL_USART_TransmitData8

[Calls]

- >> CC_SendData
- >> XB_SendData
- >> XB_SendByte
- >> XB_GetResponse
- >> XB_EnableXbee
- >> XB_DisableXbee
- >> __aeabi_memclr

[Called By]

- >> CC_ExecuteCommand

XB_GetResponse (Thumb, 268 bytes, Stack size 40 bytes, xbee.o(.text.XB_GetResponse))

[Stack]

- Max Depth = 48
- Call Chain = XB_GetResponse ⇒ TIM2_initDelay_inline

[Calls]

- >> TIM2_initDelay_inline
- >> strlen

[Called By]

- >> XB_GetSN
- >> XB_GetConfig
- >> XB_ConfigureDevice

XB_GetSN (Thumb, 176 bytes, Stack size 128 bytes, xbee.o(.text.XB_GetSN))

[Stack]

- Max Depth = 200
- Call Chain = XB_GetSN ⇒ CC_SendData ⇒ CC_SendByte ⇒ LL_USART_TransmitData8

[Calls]

- >> CC_SendData
- >> XB_SendData
- >> XB_SendByte
- >> XB_GetResponse
- >> XB_EnableXbee
- >> XB_DisableXbee
- >> __aeabi_memclr

[Called By]

- >> CC_ExecuteCommand

XB_ParseCommand (Thumb, 212 bytes, Stack size 72 bytes, xbee.o(.text.XB_ParseCommand))

[Stack]

- Max Depth = 80
- Call Chain = XB_ParseCommand ⇒ strcmp

[Calls]

- >> strcmp
- >> __aeabi_memclr

[Called By]

- >> XB_XbeeSubroutine

XB_SendByte (Thumb, 60 bytes, Stack size 24 bytes, xbee.o(.text.XB_SendByte))

[Stack]

- Max Depth = 40
- Call Chain = XB_SendByte ⇒ LL_USART_TransmitData8

[Calls]

- >> LL_USART_TransmitData8

[Called By]

- >> XB_GetSN
- >> XB_GetConfig
- >> XB_ConfigureDevice
- >> XB_TransmitFixes
- >> XB_SendData
- >> XB_CheckForDongle

XB_SendData (Thumb, 64 bytes, Stack size 32 bytes, xbee.o(.text.XB_SendData))

[Stack]

- Max Depth = 72
- Call Chain = XB_SendData ⇒ XB_SendByte ⇒ LL_USART_TransmitData8

[Calls]

- >> XB_SendByte

[Called By]

- >> XB_GetSN
- >> XB_GetConfig
- >> XB_ConfigureDevice
- >> XB_TransmitFixes

XB_TransmitFixes (Thumb, 340 bytes, Stack size 160 bytes, xbee.o(.text.XB_TransmitFixes))

[Stack]

- Max Depth = 248
- Call Chain = XB_TransmitFixes ⇒ FLASH_readFixes ⇒ FLASH_ReadData

[Calls]

- >> FLASH_readFixes
- >> CC_SendData
- >> CC_SendByte
- >> XB_SendData
- >> XB_SendByte
- >> __aeabi_memclr

[Called By]

- >> XB_ExecuteCommand

XB_XbeeSubroutine (Thumb, 188 bytes, Stack size 24 bytes, xbee.o(.text.XB_XbeeSubroutine))

[Stack]

- Max Depth = 296
- Call Chain = XB_XbeeSubroutine ⇒ XB_ExecuteCommand ⇒ XB_TransmitFixes ⇒ FLASH_readFixes ⇒ FLASH_ReadData

[Calls]

- >> TIM2_initDelay_inline
- >> XB_ParseCommand
- >> XB_ExecuteCommand
- >> XB_EnableXbee
- >> XB_DisableXbee
- >> XB_CheckForDongle

[Called By]

- >> main

main (Thumb, 396 bytes, Stack size 80 bytes, main.o(.text.main))

[Stack]

- Max Depth = 768
- Call Chain = main ⇒ GPS_subroutine ⇒ GPS_getNMEA ⇒ atoi ⇒ strtol ⇒ _strtoul

[Calls]

- >> TIM2_init
- >> RTC_initAlarm
- >> scheduler
- >> TIM2_delay
- >> GPS_subroutine
- >> GPS_GPSDisable
- >> GPS_GPSCSHigh
- >> setLED
- >> TIM2_initDelay_inline
- >> CC_ParseCommand
- >> CC_ExecuteCommand
- >> CC_ComPortPresent
- >> CC_CheckForHandshake
- >> SystemClock_Config
- >> LPM_stop
- >> LPM_gpioInit
- >> MX_USART4_UART_Init
- >> MX_USART1_UART_Init
- >> MX_TIM2_Init
- >> MX_SPI1_Init
- >> MX_RTC_Init
- >> MX_GPIO_Init
- >> LL_USART_Enable
- >> LL_USART_Disable
- >> LL_APB2_GRP1_EnableClock
- >> LL_APB1_GRP1_EnableClock
- >> XB_XbeeSubroutine
- >> XB_DisableXbee
- >> VHF_EnableVHF
- >> VHF_DisableVHF

[Address Reference Count : 1]

- entry9a.o(.ARM.Collect$$$$0000000B)

scheduler (Thumb, 420 bytes, Stack size 176 bytes, scheduler.o(.text.scheduler))

[Stack]

- Max Depth = 224
- Call Chain = scheduler ⇒ FLASH_ReadData

[Calls]

- >> RTC_getTimeDate
- >> EEPROM_WriteByte
- >> FLASH_Unlock
- >> FLASH_ReadData
- >> FLASH_Lock

[Called By]

- >> main

setLED (Thumb, 84 bytes, Stack size 12 bytes, comport.o(.text.setLED))

[Stack]

- Max Depth = 12
- Call Chain = setLED

[Called By]

- >> main

__0sprintf (Thumb, 36 bytes, Stack size 24 bytes, printfa.o(i.__0sprintf), UNUSED)

[Calls]

- >> _sputc
- >> _printf_core

__1sprintf (Thumb, 0 bytes, Stack size 24 bytes, printfa.o(i.__0sprintf), UNUSED)

__2sprintf (Thumb, 0 bytes, Stack size 24 bytes, printfa.o(i.__0sprintf), UNUSED)

__c89sprintf (Thumb, 0 bytes, Stack size 24 bytes, printfa.o(i.__0sprintf), UNUSED)

sprintf (Thumb, 0 bytes, Stack size 24 bytes, printfa.o(i.__0sprintf))

[Stack]

- Max Depth = 24
- Call Chain = sprintf

[Called By]

- >> CC_SetRTC
- >> CC_SendTimestamp

__ARM_clz (Thumb, 46 bytes, Stack size 0 bytes, depilogue.o(i.__ARM_clz), UNUSED)

[Called By]

- >> _double_epilogue

__aeabi_errno_addr (Thumb, 4 bytes, Stack size 0 bytes, errno.o(i.__aeabi_errno_addr))

[Called By]

- >> _strtoul
- >> strtol
- >> atoi

__rt_errno_addr (Thumb, 0 bytes, Stack size 0 bytes, errno.o(i.__aeabi_errno_addr), UNUSED)

__scatterload_copy (Thumb, 14 bytes, Stack size unknown bytes, handlers.o(i.__scatterload_copy), UNUSED)

__scatterload_null (Thumb, 2 bytes, Stack size unknown bytes, handlers.o(i.__scatterload_null), UNUSED)

__scatterload_zeroinit (Thumb, 14 bytes, Stack size unknown bytes, handlers.o(i.__scatterload_zeroinit), UNUSED)

### Local Symbols

LL_RTC_DATE_GetDay (Thumb, 26 bytes, Stack size 12 bytes, comport.o(.text.LL_RTC_DATE_GetDay))

[Stack]

- Max Depth = 12
- Call Chain = LL_RTC_DATE_GetDay

[Called By]

- >> CC_SetRTC
- >> CC_SendTimestamp

LL_RTC_DATE_GetMonth (Thumb, 30 bytes, Stack size 12 bytes, comport.o(.text.LL_RTC_DATE_GetMonth))

[Stack]

- Max Depth = 12
- Call Chain = LL_RTC_DATE_GetMonth

[Called By]

- >> CC_SetRTC
- >> CC_SendTimestamp

LL_RTC_DATE_GetWeekDay (Thumb, 20 bytes, Stack size 8 bytes, comport.o(.text.LL_RTC_DATE_GetWeekDay))

[Stack]

- Max Depth = 8
- Call Chain = LL_RTC_DATE_GetWeekDay

[Called By]

- >> CC_SetRTC
- >> CC_SendTimestamp

LL_RTC_DATE_GetYear (Thumb, 28 bytes, Stack size 12 bytes, comport.o(.text.LL_RTC_DATE_GetYear))

[Stack]

- Max Depth = 12
- Call Chain = LL_RTC_DATE_GetYear

[Called By]

- >> CC_SetRTC
- >> CC_SendTimestamp

LL_RTC_TIME_GetHour (Thumb, 30 bytes, Stack size 12 bytes, comport.o(.text.LL_RTC_TIME_GetHour))

[Stack]

- Max Depth = 12
- Call Chain = LL_RTC_TIME_GetHour

[Called By]

- >> CC_SetRTC
- >> CC_SendTimestamp

LL_RTC_TIME_GetMinute (Thumb, 30 bytes, Stack size 12 bytes, comport.o(.text.LL_RTC_TIME_GetMinute))

[Stack]

- Max Depth = 12
- Call Chain = LL_RTC_TIME_GetMinute

[Called By]

- >> CC_SetRTC
- >> CC_SendTimestamp

LL_RTC_TIME_GetSecond (Thumb, 26 bytes, Stack size 12 bytes, comport.o(.text.LL_RTC_TIME_GetSecond))

[Stack]

- Max Depth = 12
- Call Chain = LL_RTC_TIME_GetSecond

[Called By]

- >> CC_SetRTC
- >> CC_SendTimestamp

LL_USART_TransmitData8 (Thumb, 26 bytes, Stack size 16 bytes, comport.o(.text.LL_USART_TransmitData8))

[Stack]

- Max Depth = 16
- Call Chain = LL_USART_TransmitData8

[Called By]

- >> CC_SendByte

LL_SPI_ReceiveData8 (Thumb, 18 bytes, Stack size 8 bytes, gps.o(.text.LL_SPI_ReceiveData8))

[Stack]

- Max Depth = 8
- Call Chain = LL_SPI_ReceiveData8

[Called By]

- >> GPS_getNMEA

LL_SPI_TransmitData8 (Thumb, 32 bytes, Stack size 20 bytes, gps.o(.text.LL_SPI_TransmitData8))

[Stack]

- Max Depth = 20
- Call Chain = LL_SPI_TransmitData8

[Called By]

- >> GPS_getNMEA
- >> GPS_UBX_enablePUBX_Position

LL_USART_TransmitData8 (Thumb, 26 bytes, Stack size 16 bytes, gps.o(.text.LL_USART_TransmitData8))

[Stack]

- Max Depth = 16
- Call Chain = LL_USART_TransmitData8

[Called By]

- >> GPS_getNMEA

LL_RTC_ALMA_Disable (Thumb, 24 bytes, Stack size 8 bytes, timers.o(.text.LL_RTC_ALMA_Disable))

[Stack]

- Max Depth = 8
- Call Chain = LL_RTC_ALMA_Disable

[Called By]

- >> RTC_initAlarm

LL_RTC_ALMA_Enable (Thumb, 24 bytes, Stack size 8 bytes, timers.o(.text.LL_RTC_ALMA_Enable))

[Stack]

- Max Depth = 8
- Call Chain = LL_RTC_ALMA_Enable

[Called By]

- >> RTC_initAlarm

LL_RTC_ALMA_SetMask (Thumb, 40 bytes, Stack size 16 bytes, timers.o(.text.LL_RTC_ALMA_SetMask))

[Stack]

- Max Depth = 16
- Call Chain = LL_RTC_ALMA_SetMask

[Called By]

- >> RTC_initAlarm

LL_RTC_ALMA_SetSecond (Thumb, 36 bytes, Stack size 16 bytes, timers.o(.text.LL_RTC_ALMA_SetSecond))

[Stack]

- Max Depth = 16
- Call Chain = LL_RTC_ALMA_SetSecond

[Called By]

- >> RTC_initAlarm

LL_RTC_DATE_GetDay (Thumb, 26 bytes, Stack size 12 bytes, timers.o(.text.LL_RTC_DATE_GetDay))

[Stack]

- Max Depth = 12
- Call Chain = LL_RTC_DATE_GetDay

[Called By]

- >> RTC_getTimeDate

LL_RTC_DATE_GetMonth (Thumb, 30 bytes, Stack size 12 bytes, timers.o(.text.LL_RTC_DATE_GetMonth))

[Stack]

- Max Depth = 12
- Call Chain = LL_RTC_DATE_GetMonth

[Called By]

- >> RTC_getTimeDate

LL_RTC_DATE_GetWeekDay (Thumb, 20 bytes, Stack size 8 bytes, timers.o(.text.LL_RTC_DATE_GetWeekDay))

[Stack]

- Max Depth = 8
- Call Chain = LL_RTC_DATE_GetWeekDay

[Called By]

- >> RTC_getTimeDate

LL_RTC_DATE_GetYear (Thumb, 28 bytes, Stack size 12 bytes, timers.o(.text.LL_RTC_DATE_GetYear))

[Stack]

- Max Depth = 12
- Call Chain = LL_RTC_DATE_GetYear

[Called By]

- >> RTC_getTimeDate

LL_RTC_DisableWriteProtection (Thumb, 24 bytes, Stack size 8 bytes, timers.o(.text.LL_RTC_DisableWriteProtection))

[Stack]

- Max Depth = 8
- Call Chain = LL_RTC_DisableWriteProtection

[Called By]

- >> RTC_initAlarm

LL_RTC_EnableWriteProtection (Thumb, 18 bytes, Stack size 8 bytes, timers.o(.text.LL_RTC_EnableWriteProtection))

[Stack]

- Max Depth = 8
- Call Chain = LL_RTC_EnableWriteProtection

[Called By]

- >> RTC_initAlarm

LL_RTC_TIME_GetFormat (Thumb, 22 bytes, Stack size 8 bytes, timers.o(.text.LL_RTC_TIME_GetFormat))

[Stack]

- Max Depth = 8
- Call Chain = LL_RTC_TIME_GetFormat

[Called By]

- >> RTC_getTimeDate

LL_RTC_TIME_GetHour (Thumb, 30 bytes, Stack size 12 bytes, timers.o(.text.LL_RTC_TIME_GetHour))

[Stack]

- Max Depth = 12
- Call Chain = LL_RTC_TIME_GetHour

[Called By]

- >> RTC_getTimeDate

LL_RTC_TIME_GetMinute (Thumb, 30 bytes, Stack size 12 bytes, timers.o(.text.LL_RTC_TIME_GetMinute))

[Stack]

- Max Depth = 12
- Call Chain = LL_RTC_TIME_GetMinute

[Called By]

- >> RTC_getTimeDate

LL_RTC_TIME_GetSecond (Thumb, 26 bytes, Stack size 12 bytes, timers.o(.text.LL_RTC_TIME_GetSecond))

[Stack]

- Max Depth = 12
- Call Chain = LL_RTC_TIME_GetSecond

[Called By]

- >> RTC_getTimeDate

LL_USART_TransmitData8 (Thumb, 26 bytes, Stack size 16 bytes, xbee.o(.text.LL_USART_TransmitData8))

[Stack]

- Max Depth = 16
- Call Chain = LL_USART_TransmitData8

[Called By]

- >> XB_SendByte

LL_APB1_GRP1_EnableClock (Thumb, 40 bytes, Stack size 16 bytes, main.o(.text.LL_APB1_GRP1_EnableClock))

[Stack]

- Max Depth = 16
- Call Chain = LL_APB1_GRP1_EnableClock

[Called By]

- >> main
- >> MX_USART4_UART_Init
- >> MX_TIM2_Init

LL_APB2_GRP1_EnableClock (Thumb, 40 bytes, Stack size 16 bytes, main.o(.text.LL_APB2_GRP1_EnableClock))

[Stack]

- Max Depth = 16
- Call Chain = LL_APB2_GRP1_EnableClock

[Called By]

- >> main
- >> MX_USART1_UART_Init
- >> MX_SPI1_Init

LL_FLASH_GetLatency (Thumb, 16 bytes, Stack size 0 bytes, main.o(.text.LL_FLASH_GetLatency))

[Called By]

- >> SystemClock_Config

LL_FLASH_SetLatency (Thumb, 32 bytes, Stack size 8 bytes, main.o(.text.LL_FLASH_SetLatency))

[Stack]

- Max Depth = 8
- Call Chain = LL_FLASH_SetLatency

[Called By]

- >> SystemClock_Config

LL_GPIO_ResetOutputPin (Thumb, 24 bytes, Stack size 16 bytes, main.o(.text.LL_GPIO_ResetOutputPin))

[Stack]

- Max Depth = 16
- Call Chain = LL_GPIO_ResetOutputPin

[Called By]

- >> MX_GPIO_Init

LL_IOP_GRP1_EnableClock (Thumb, 40 bytes, Stack size 16 bytes, main.o(.text.LL_IOP_GRP1_EnableClock))

[Stack]

- Max Depth = 16
- Call Chain = LL_IOP_GRP1_EnableClock

[Called By]

- >> MX_USART4_UART_Init
- >> MX_USART1_UART_Init
- >> MX_SPI1_Init
- >> MX_GPIO_Init

LL_PWR_EnableBkUpAccess (Thumb, 20 bytes, Stack size 0 bytes, main.o(.text.LL_PWR_EnableBkUpAccess))

[Called By]

- >> SystemClock_Config

LL_PWR_SetRegulVoltageScaling (Thumb, 32 bytes, Stack size 8 bytes, main.o(.text.LL_PWR_SetRegulVoltageScaling))

[Stack]

- Max Depth = 8
- Call Chain = LL_PWR_SetRegulVoltageScaling

[Called By]

- >> SystemClock_Config

LL_RCC_EnableRTC (Thumb, 20 bytes, Stack size 0 bytes, main.o(.text.LL_RCC_EnableRTC))

[Called By]

- >> SystemClock_Config
- >> MX_RTC_Init

LL_RCC_ForceBackupDomainReset (Thumb, 20 bytes, Stack size 0 bytes, main.o(.text.LL_RCC_ForceBackupDomainReset))

[Called By]

- >> SystemClock_Config

LL_RCC_GetSysClkSource (Thumb, 16 bytes, Stack size 0 bytes, main.o(.text.LL_RCC_GetSysClkSource))

[Called By]

- >> SystemClock_Config

LL_RCC_LSE_Enable (Thumb, 20 bytes, Stack size 0 bytes, main.o(.text.LL_RCC_LSE_Enable))

[Called By]

- >> SystemClock_Config

LL_RCC_LSE_IsReady (Thumb, 20 bytes, Stack size 0 bytes, main.o(.text.LL_RCC_LSE_IsReady))

[Called By]

- >> SystemClock_Config

LL_RCC_LSE_SetDriveCapability (Thumb, 32 bytes, Stack size 8 bytes, main.o(.text.LL_RCC_LSE_SetDriveCapability))

[Stack]

- Max Depth = 8
- Call Chain = LL_RCC_LSE_SetDriveCapability

[Called By]

- >> SystemClock_Config

LL_RCC_MSI_Enable (Thumb, 20 bytes, Stack size 0 bytes, main.o(.text.LL_RCC_MSI_Enable))

[Called By]

- >> SystemClock_Config

LL_RCC_MSI_IsReady (Thumb, 20 bytes, Stack size 0 bytes, main.o(.text.LL_RCC_MSI_IsReady))

[Called By]

- >> SystemClock_Config

LL_RCC_MSI_SetCalibTrimming (Thumb, 36 bytes, Stack size 8 bytes, main.o(.text.LL_RCC_MSI_SetCalibTrimming))

[Stack]

- Max Depth = 8
- Call Chain = LL_RCC_MSI_SetCalibTrimming

[Called By]

- >> SystemClock_Config

LL_RCC_MSI_SetRange (Thumb, 32 bytes, Stack size 8 bytes, main.o(.text.LL_RCC_MSI_SetRange))

[Stack]

- Max Depth = 8
- Call Chain = LL_RCC_MSI_SetRange

[Called By]

- >> SystemClock_Config

LL_RCC_ReleaseBackupDomainReset (Thumb, 20 bytes, Stack size 0 bytes, main.o(.text.LL_RCC_ReleaseBackupDomainReset))

[Called By]

- >> SystemClock_Config

LL_RCC_SetAHBPrescaler (Thumb, 32 bytes, Stack size 8 bytes, main.o(.text.LL_RCC_SetAHBPrescaler))

[Stack]

- Max Depth = 8
- Call Chain = LL_RCC_SetAHBPrescaler

[Called By]

- >> SystemClock_Config

LL_RCC_SetAPB1Prescaler (Thumb, 32 bytes, Stack size 8 bytes, main.o(.text.LL_RCC_SetAPB1Prescaler))

[Stack]

- Max Depth = 8
- Call Chain = LL_RCC_SetAPB1Prescaler

[Called By]

- >> SystemClock_Config

LL_RCC_SetAPB2Prescaler (Thumb, 32 bytes, Stack size 8 bytes, main.o(.text.LL_RCC_SetAPB2Prescaler))

[Stack]

- Max Depth = 8
- Call Chain = LL_RCC_SetAPB2Prescaler

[Called By]

- >> SystemClock_Config

LL_RCC_SetRTCClockSource (Thumb, 32 bytes, Stack size 8 bytes, main.o(.text.LL_RCC_SetRTCClockSource))

[Stack]

- Max Depth = 8
- Call Chain = LL_RCC_SetRTCClockSource

[Called By]

- >> SystemClock_Config

LL_RCC_SetSysClkSource (Thumb, 32 bytes, Stack size 8 bytes, main.o(.text.LL_RCC_SetSysClkSource))

[Stack]

- Max Depth = 8
- Call Chain = LL_RCC_SetSysClkSource

[Called By]

- >> SystemClock_Config

LL_RCC_SetUSARTClockSource (Thumb, 36 bytes, Stack size 16 bytes, main.o(.text.LL_RCC_SetUSARTClockSource))

[Stack]

- Max Depth = 16
- Call Chain = LL_RCC_SetUSARTClockSource

[Called By]

- >> SystemClock_Config

LL_SPI_SetStandard (Thumb, 34 bytes, Stack size 16 bytes, main.o(.text.LL_SPI_SetStandard))

[Stack]

- Max Depth = 16
- Call Chain = LL_SPI_SetStandard

[Called By]

- >> MX_SPI1_Init

LL_SYSTICK_SetClkSource (Thumb, 48 bytes, Stack size 8 bytes, main.o(.text.LL_SYSTICK_SetClkSource))

[Stack]

- Max Depth = 8
- Call Chain = LL_SYSTICK_SetClkSource

[Called By]

- >> SystemClock_Config

LL_TIM_DisableARRPreload (Thumb, 22 bytes, Stack size 8 bytes, main.o(.text.LL_TIM_DisableARRPreload))

[Stack]

- Max Depth = 8
- Call Chain = LL_TIM_DisableARRPreload

[Called By]

- >> MX_TIM2_Init

LL_TIM_DisableMasterSlaveMode (Thumb, 22 bytes, Stack size 8 bytes, main.o(.text.LL_TIM_DisableMasterSlaveMode))

[Stack]

- Max Depth = 8
- Call Chain = LL_TIM_DisableMasterSlaveMode

[Called By]

- >> MX_TIM2_Init

LL_TIM_SetClockSource (Thumb, 40 bytes, Stack size 16 bytes, main.o(.text.LL_TIM_SetClockSource))

[Stack]

- Max Depth = 16
- Call Chain = LL_TIM_SetClockSource

[Called By]

- >> MX_TIM2_Init

LL_TIM_SetTriggerOutput (Thumb, 34 bytes, Stack size 16 bytes, main.o(.text.LL_TIM_SetTriggerOutput))

[Stack]

- Max Depth = 16
- Call Chain = LL_TIM_SetTriggerOutput

[Called By]

- >> MX_TIM2_Init

LL_USART_ConfigAsyncMode (Thumb, 34 bytes, Stack size 8 bytes, main.o(.text.LL_USART_ConfigAsyncMode))

[Stack]

- Max Depth = 8
- Call Chain = LL_USART_ConfigAsyncMode

[Called By]

- >> MX_USART4_UART_Init
- >> MX_USART1_UART_Init

LL_USART_Disable (Thumb, 22 bytes, Stack size 8 bytes, main.o(.text.LL_USART_Disable))

[Stack]

- Max Depth = 8
- Call Chain = LL_USART_Disable

[Called By]

- >> main

LL_USART_DisableOverrunDetect (Thumb, 24 bytes, Stack size 8 bytes, main.o(.text.LL_USART_DisableOverrunDetect))

[Stack]

- Max Depth = 8
- Call Chain = LL_USART_DisableOverrunDetect

[Called By]

- >> MX_USART1_UART_Init

LL_USART_Enable (Thumb, 22 bytes, Stack size 8 bytes, main.o(.text.LL_USART_Enable))

[Stack]

- Max Depth = 8
- Call Chain = LL_USART_Enable

[Called By]

- >> main
- >> MX_USART4_UART_Init
- >> MX_USART1_UART_Init

LL_USART_SetTXRXSwap (Thumb, 36 bytes, Stack size 16 bytes, main.o(.text.LL_USART_SetTXRXSwap))

[Stack]

- Max Depth = 16
- Call Chain = LL_USART_SetTXRXSwap

[Called By]

- >> MX_USART4_UART_Init

MX_GPIO_Init (Thumb, 324 bytes, Stack size 104 bytes, main.o(.text.MX_GPIO_Init))

[Stack]

- Max Depth = 184
- Call Chain = MX_GPIO_Init ⇒ LL_GPIO_Init ⇒ LL_GPIO_SetPinSpeed

[Calls]

- >> LL_GPIO_Init
- >> LL_IOP_GRP1_EnableClock
- >> LL_GPIO_ResetOutputPin

[Called By]

- >> main

MX_RTC_Init (Thumb, 136 bytes, Stack size 72 bytes, main.o(.text.MX_RTC_Init))

[Stack]

- Max Depth = 208
- Call Chain = MX_RTC_Init ⇒ LL_RTC_TIME_Init ⇒ LL_RTC_TIME_Config

[Calls]

- >> LL_RTC_TIME_Init
- >> LL_RTC_DATE_Init
- >> LL_RTC_Init
- >> NVIC_SetPriority
- >> NVIC_EnableIRQ
- >> LL_RCC_EnableRTC

[Called By]

- >> main

MX_SPI1_Init (Thumb, 272 bytes, Stack size 136 bytes, main.o(.text.MX_SPI1_Init))

[Stack]

- Max Depth = 216
- Call Chain = MX_SPI1_Init ⇒ LL_GPIO_Init ⇒ LL_GPIO_SetPinSpeed

[Calls]

- >> LL_SPI_Init
- >> LL_GPIO_Init
- >> NVIC_SetPriority
- >> NVIC_EnableIRQ
- >> LL_SPI_SetStandard
- >> LL_IOP_GRP1_EnableClock
- >> LL_APB2_GRP1_EnableClock
- >> __aeabi_memclr4

[Called By]

- >> main

MX_TIM2_Init (Thumb, 108 bytes, Stack size 48 bytes, main.o(.text.MX_TIM2_Init))

[Stack]

- Max Depth = 96
- Call Chain = MX_TIM2_Init ⇒ LL_TIM_Init ⇒ LL_TIM_SetPrescaler

[Calls]

- >> LL_TIM_Init
- >> NVIC_SetPriority
- >> NVIC_EnableIRQ
- >> LL_TIM_SetTriggerOutput
- >> LL_TIM_SetClockSource
- >> LL_TIM_DisableMasterSlaveMode
- >> LL_TIM_DisableARRPreload
- >> LL_APB1_GRP1_EnableClock

[Called By]

- >> main

MX_USART1_UART_Init (Thumb, 224 bytes, Stack size 120 bytes, main.o(.text.MX_USART1_UART_Init))

[Stack]

- Max Depth = 260
- Call Chain = MX_USART1_UART_Init ⇒ LL_USART_Init ⇒ LL_RCC_GetUSARTClockFreq ⇒ RCC_GetSystemClockFreq ⇒ RCC_PLL_GetFreqDomain_SYS ⇒ __aeabi_uidiv

[Calls]

- >> LL_USART_Init
- >> LL_GPIO_Init
- >> NVIC_SetPriority
- >> NVIC_EnableIRQ
- >> LL_USART_Enable
- >> LL_USART_DisableOverrunDetect
- >> LL_USART_ConfigAsyncMode
- >> LL_IOP_GRP1_EnableClock
- >> LL_APB2_GRP1_EnableClock

[Called By]

- >> main

MX_USART4_UART_Init (Thumb, 224 bytes, Stack size 120 bytes, main.o(.text.MX_USART4_UART_Init))

[Stack]

- Max Depth = 260
- Call Chain = MX_USART4_UART_Init ⇒ LL_USART_Init ⇒ LL_RCC_GetUSARTClockFreq ⇒ RCC_GetSystemClockFreq ⇒ RCC_PLL_GetFreqDomain_SYS ⇒ __aeabi_uidiv

[Calls]

- >> LL_USART_Init
- >> LL_GPIO_Init
- >> NVIC_SetPriority
- >> NVIC_EnableIRQ
- >> LL_USART_SetTXRXSwap
- >> LL_USART_Enable
- >> LL_USART_ConfigAsyncMode
- >> LL_IOP_GRP1_EnableClock
- >> LL_APB1_GRP1_EnableClock

[Called By]

- >> main

NVIC_EnableIRQ (Thumb, 32 bytes, Stack size 8 bytes, main.o(.text.NVIC_EnableIRQ))

[Stack]

- Max Depth = 8
- Call Chain = NVIC_EnableIRQ

[Called By]

- >> MX_USART4_UART_Init
- >> MX_USART1_UART_Init
- >> MX_TIM2_Init
- >> MX_SPI1_Init
- >> MX_RTC_Init

NVIC_SetPriority (Thumb, 140 bytes, Stack size 32 bytes, main.o(.text.NVIC_SetPriority))

[Stack]

- Max Depth = 32
- Call Chain = NVIC_SetPriority

[Called By]

- >> MX_USART4_UART_Init
- >> MX_USART1_UART_Init
- >> MX_TIM2_Init
- >> MX_SPI1_Init
- >> MX_RTC_Init

NVIC_SystemReset (Thumb, 28 bytes, Stack size 0 bytes, stm32l0xx_it.o(.text.NVIC_SystemReset))

[Called By]

- >> HardFault_Handler

LL_APB1_GRP1_DisableClock (Thumb, 28 bytes, Stack size 8 bytes, lowpower.o(.text.LL_APB1_GRP1_DisableClock))

[Stack]

- Max Depth = 8
- Call Chain = LL_APB1_GRP1_DisableClock

[Called By]

- >> LPM_stop

LL_APB2_GRP1_DisableClock (Thumb, 28 bytes, Stack size 8 bytes, lowpower.o(.text.LL_APB2_GRP1_DisableClock))

[Stack]

- Max Depth = 8
- Call Chain = LL_APB2_GRP1_DisableClock

[Called By]

- >> LPM_stop

LL_USART_Enable (Thumb, 22 bytes, Stack size 8 bytes, lowpower.o(.text.LL_USART_Enable))

[Stack]

- Max Depth = 8
- Call Chain = LL_USART_Enable

[Called By]

- >> LPM_stop

LL_GPIO_SetAFPin_0_7 (Thumb, 58 bytes, Stack size 40 bytes, stm32l0xx_ll_gpio.o(.text.LL_GPIO_SetAFPin_0_7))

[Stack]

- Max Depth = 40
- Call Chain = LL_GPIO_SetAFPin_0_7

[Called By]

- >> LL_GPIO_Init

LL_GPIO_SetAFPin_8_15 (Thumb, 60 bytes, Stack size 40 bytes, stm32l0xx_ll_gpio.o(.text.LL_GPIO_SetAFPin_8_15))

[Stack]

- Max Depth = 40
- Call Chain = LL_GPIO_SetAFPin_8_15

[Called By]

- >> LL_GPIO_Init

LL_GPIO_SetPinMode (Thumb, 50 bytes, Stack size 40 bytes, stm32l0xx_ll_gpio.o(.text.LL_GPIO_SetPinMode))

[Stack]

- Max Depth = 40
- Call Chain = LL_GPIO_SetPinMode

[Called By]

- >> LL_GPIO_Init

LL_GPIO_SetPinOutputType (Thumb, 44 bytes, Stack size 40 bytes, stm32l0xx_ll_gpio.o(.text.LL_GPIO_SetPinOutputType))

[Stack]

- Max Depth = 40
- Call Chain = LL_GPIO_SetPinOutputType

[Called By]

- >> LL_GPIO_Init

LL_GPIO_SetPinPull (Thumb, 50 bytes, Stack size 40 bytes, stm32l0xx_ll_gpio.o(.text.LL_GPIO_SetPinPull))

[Stack]

- Max Depth = 40
- Call Chain = LL_GPIO_SetPinPull

[Called By]

- >> LL_GPIO_Init

LL_GPIO_SetPinSpeed (Thumb, 50 bytes, Stack size 40 bytes, stm32l0xx_ll_gpio.o(.text.LL_GPIO_SetPinSpeed))

[Stack]

- Max Depth = 40
- Call Chain = LL_GPIO_SetPinSpeed

[Called By]

- >> LL_GPIO_Init

LL_RTC_ClearFlag_RS (Thumb, 30 bytes, Stack size 8 bytes, stm32l0xx_ll_rtc.o(.text.LL_RTC_ClearFlag_RS))

[Stack]

- Max Depth = 8
- Call Chain = LL_RTC_ClearFlag_RS

[Called By]

- >> LL_RTC_WaitForSynchro

LL_RTC_DATE_Config (Thumb, 88 bytes, Stack size 64 bytes, stm32l0xx_ll_rtc.o(.text.LL_RTC_DATE_Config))

[Stack]

- Max Depth = 64
- Call Chain = LL_RTC_DATE_Config

[Called By]

- >> LL_RTC_DATE_Init

LL_RTC_DisableInitMode (Thumb, 20 bytes, Stack size 8 bytes, stm32l0xx_ll_rtc.o(.text.LL_RTC_DisableInitMode))

[Stack]

- Max Depth = 8
- Call Chain = LL_RTC_DisableInitMode

[Called By]

- >> LL_RTC_TIME_Init
- >> LL_RTC_DATE_Init
- >> LL_RTC_Init

LL_RTC_DisableWriteProtection (Thumb, 24 bytes, Stack size 8 bytes, stm32l0xx_ll_rtc.o(.text.LL_RTC_DisableWriteProtection))

[Stack]

- Max Depth = 8
- Call Chain = LL_RTC_DisableWriteProtection

[Called By]

- >> LL_RTC_TIME_Init
- >> LL_RTC_DATE_Init
- >> LL_RTC_Init

LL_RTC_EnableInitMode (Thumb, 20 bytes, Stack size 8 bytes, stm32l0xx_ll_rtc.o(.text.LL_RTC_EnableInitMode))

[Stack]

- Max Depth = 8
- Call Chain = LL_RTC_EnableInitMode

[Called By]

- >> LL_RTC_EnterInitMode

LL_RTC_EnableWriteProtection (Thumb, 18 bytes, Stack size 8 bytes, stm32l0xx_ll_rtc.o(.text.LL_RTC_EnableWriteProtection))

[Stack]

- Max Depth = 8
- Call Chain = LL_RTC_EnableWriteProtection

[Called By]

- >> LL_RTC_TIME_Init
- >> LL_RTC_DATE_Init
- >> LL_RTC_Init

LL_RTC_GetHourFormat (Thumb, 20 bytes, Stack size 8 bytes, stm32l0xx_ll_rtc.o(.text.LL_RTC_GetHourFormat))

[Stack]

- Max Depth = 8
- Call Chain = LL_RTC_GetHourFormat

[Called By]

- >> LL_RTC_TIME_Init

LL_RTC_IsActiveFlag_INIT (Thumb, 22 bytes, Stack size 8 bytes, stm32l0xx_ll_rtc.o(.text.LL_RTC_IsActiveFlag_INIT))

[Stack]

- Max Depth = 8
- Call Chain = LL_RTC_IsActiveFlag_INIT

[Called By]

- >> LL_RTC_EnterInitMode

LL_RTC_IsActiveFlag_RS (Thumb, 22 bytes, Stack size 8 bytes, stm32l0xx_ll_rtc.o(.text.LL_RTC_IsActiveFlag_RS))

[Stack]

- Max Depth = 8
- Call Chain = LL_RTC_IsActiveFlag_RS

[Called By]

- >> LL_RTC_WaitForSynchro

LL_RTC_IsShadowRegBypassEnabled (Thumb, 22 bytes, Stack size 8 bytes, stm32l0xx_ll_rtc.o(.text.LL_RTC_IsShadowRegBypassEnabled))

[Stack]

- Max Depth = 8
- Call Chain = LL_RTC_IsShadowRegBypassEnabled

[Called By]

- >> LL_RTC_TIME_Init
- >> LL_RTC_DATE_Init

LL_RTC_SetAsynchPrescaler (Thumb, 38 bytes, Stack size 16 bytes, stm32l0xx_ll_rtc.o(.text.LL_RTC_SetAsynchPrescaler))

[Stack]

- Max Depth = 16
- Call Chain = LL_RTC_SetAsynchPrescaler

[Called By]

- >> LL_RTC_Init

LL_RTC_SetHourFormat (Thumb, 34 bytes, Stack size 16 bytes, stm32l0xx_ll_rtc.o(.text.LL_RTC_SetHourFormat))

[Stack]

- Max Depth = 16
- Call Chain = LL_RTC_SetHourFormat

[Called By]

- >> LL_RTC_Init

LL_RTC_SetSynchPrescaler (Thumb, 40 bytes, Stack size 16 bytes, stm32l0xx_ll_rtc.o(.text.LL_RTC_SetSynchPrescaler))

[Stack]

- Max Depth = 16
- Call Chain = LL_RTC_SetSynchPrescaler

[Called By]

- >> LL_RTC_Init

LL_RTC_TIME_Config (Thumb, 84 bytes, Stack size 64 bytes, stm32l0xx_ll_rtc.o(.text.LL_RTC_TIME_Config))

[Stack]

- Max Depth = 64
- Call Chain = LL_RTC_TIME_Config

[Called By]

- >> LL_RTC_TIME_Init

LL_SYSTICK_IsActiveCounterFlag (Thumb, 20 bytes, Stack size 0 bytes, stm32l0xx_ll_rtc.o(.text.LL_SYSTICK_IsActiveCounterFlag))

[Called By]

- >> LL_RTC_WaitForSynchro
- >> LL_RTC_EnterInitMode

LL_SPI_IsEnabled (Thumb, 22 bytes, Stack size 8 bytes, stm32l0xx_ll_spi.o(.text.LL_SPI_IsEnabled))

[Stack]

- Max Depth = 8
- Call Chain = LL_SPI_IsEnabled

[Called By]

- >> LL_SPI_Init

LL_SPI_SetCRCPolynomial (Thumb, 26 bytes, Stack size 16 bytes, stm32l0xx_ll_spi.o(.text.LL_SPI_SetCRCPolynomial))

[Stack]

- Max Depth = 16
- Call Chain = LL_SPI_SetCRCPolynomial

[Called By]

- >> LL_SPI_Init

LL_TIM_GenerateEvent_UPDATE (Thumb, 22 bytes, Stack size 8 bytes, stm32l0xx_ll_tim.o(.text.LL_TIM_GenerateEvent_UPDATE))

[Stack]

- Max Depth = 8
- Call Chain = LL_TIM_GenerateEvent_UPDATE

[Called By]

- >> LL_TIM_Init

LL_TIM_SetAutoReload (Thumb, 24 bytes, Stack size 16 bytes, stm32l0xx_ll_tim.o(.text.LL_TIM_SetAutoReload))

[Stack]

- Max Depth = 16
- Call Chain = LL_TIM_SetAutoReload

[Called By]

- >> LL_TIM_Init

LL_TIM_SetPrescaler (Thumb, 24 bytes, Stack size 16 bytes, stm32l0xx_ll_tim.o(.text.LL_TIM_SetPrescaler))

[Stack]

- Max Depth = 16
- Call Chain = LL_TIM_SetPrescaler

[Called By]

- >> LL_TIM_Init

LL_USART_IsEnabled (Thumb, 20 bytes, Stack size 8 bytes, stm32l0xx_ll_usart.o(.text.LL_USART_IsEnabled))

[Stack]

- Max Depth = 8
- Call Chain = LL_USART_IsEnabled

[Called By]

- >> LL_USART_Init

LL_USART_SetBaudRate (Thumb, 116 bytes, Stack size 64 bytes, stm32l0xx_ll_usart.o(.text.LL_USART_SetBaudRate))

[Stack]

- Max Depth = 76
- Call Chain = LL_USART_SetBaudRate ⇒ __aeabi_uidiv

[Calls]

- >> __aeabi_uidiv

[Called By]

- >> LL_USART_Init

LL_USART_SetHWFlowCtrl (Thumb, 36 bytes, Stack size 16 bytes, stm32l0xx_ll_usart.o(.text.LL_USART_SetHWFlowCtrl))

[Stack]

- Max Depth = 16
- Call Chain = LL_USART_SetHWFlowCtrl

[Called By]

- >> LL_USART_Init

LL_USART_SetStopBitsLength (Thumb, 36 bytes, Stack size 16 bytes, stm32l0xx_ll_usart.o(.text.LL_USART_SetStopBitsLength))

[Stack]

- Max Depth = 16
- Call Chain = LL_USART_SetStopBitsLength

[Called By]

- >> LL_USART_Init

LL_RCC_GetAHBPrescaler (Thumb, 16 bytes, Stack size 0 bytes, stm32l0xx_ll_rcc.o(.text.LL_RCC_GetAHBPrescaler))

[Called By]

- >> RCC_GetHCLKClockFreq

LL_RCC_GetAPB1Prescaler (Thumb, 16 bytes, Stack size 0 bytes, stm32l0xx_ll_rcc.o(.text.LL_RCC_GetAPB1Prescaler))

[Called By]

- >> RCC_GetPCLK1ClockFreq

LL_RCC_GetAPB2Prescaler (Thumb, 16 bytes, Stack size 0 bytes, stm32l0xx_ll_rcc.o(.text.LL_RCC_GetAPB2Prescaler))

[Called By]

- >> RCC_GetPCLK2ClockFreq

LL_RCC_GetSysClkSource (Thumb, 16 bytes, Stack size 0 bytes, stm32l0xx_ll_rcc.o(.text.LL_RCC_GetSysClkSource))

[Called By]

- >> RCC_GetSystemClockFreq

LL_RCC_GetUSARTClockSource (Thumb, 28 bytes, Stack size 8 bytes, stm32l0xx_ll_rcc.o(.text.LL_RCC_GetUSARTClockSource))

[Stack]

- Max Depth = 8
- Call Chain = LL_RCC_GetUSARTClockSource

[Called By]

- >> LL_RCC_GetUSARTClockFreq

LL_RCC_HSI_IsReady (Thumb, 16 bytes, Stack size 0 bytes, stm32l0xx_ll_rcc.o(.text.LL_RCC_HSI_IsReady))

[Called By]

- >> LL_RCC_GetUSARTClockFreq

LL_RCC_IsActiveFlag_HSIDIV (Thumb, 16 bytes, Stack size 0 bytes, stm32l0xx_ll_rcc.o(.text.LL_RCC_IsActiveFlag_HSIDIV))

[Called By]

- >> LL_RCC_GetUSARTClockFreq
- >> RCC_PLL_GetFreqDomain_SYS
- >> RCC_GetSystemClockFreq

LL_RCC_LSE_IsReady (Thumb, 20 bytes, Stack size 0 bytes, stm32l0xx_ll_rcc.o(.text.LL_RCC_LSE_IsReady))

[Called By]

- >> LL_RCC_GetUSARTClockFreq

LL_RCC_MSI_GetRange (Thumb, 16 bytes, Stack size 0 bytes, stm32l0xx_ll_rcc.o(.text.LL_RCC_MSI_GetRange))

[Called By]

- >> RCC_GetSystemClockFreq

LL_RCC_PLL_GetDivider (Thumb, 16 bytes, Stack size 0 bytes, stm32l0xx_ll_rcc.o(.text.LL_RCC_PLL_GetDivider))

[Called By]

- >> RCC_PLL_GetFreqDomain_SYS

LL_RCC_PLL_GetMainSource (Thumb, 16 bytes, Stack size 0 bytes, stm32l0xx_ll_rcc.o(.text.LL_RCC_PLL_GetMainSource))

[Called By]

- >> RCC_PLL_GetFreqDomain_SYS

LL_RCC_PLL_GetMultiplicator (Thumb, 16 bytes, Stack size 0 bytes, stm32l0xx_ll_rcc.o(.text.LL_RCC_PLL_GetMultiplicator))

[Called By]

- >> RCC_PLL_GetFreqDomain_SYS

LL_InitTick (Thumb, 60 bytes, Stack size 24 bytes, stm32l0xx_ll_utils.o(.text.LL_InitTick))

[Stack]

- Max Depth = 36
- Call Chain = LL_InitTick ⇒ __aeabi_uidiv

[Calls]

- >> __aeabi_uidiv

[Called By]

- >> LL_Init1msTick

_fp_digits (Thumb, 344 bytes, Stack size 64 bytes, printfa.o(i._fp_digits), UNUSED)

[Calls]

- >> __aeabi_uldivmod
- >> __aeabi_dmul
- >> __aeabi_ddiv
- >> __aeabi_dadd
- >> __aeabi_d2ulz
- >> __aeabi_cdrcmple

[Called By]

- >> _printf_core

_printf_core (Thumb, 1754 bytes, Stack size 128 bytes, printfa.o(i._printf_core), UNUSED)

[Calls]

- >> __aeabi_uldivmod
- >> _printf_pre_padding
- >> _printf_post_padding
- >> _fp_digits
- >> __aeabi_uidivmod

[Called By]

- >> __0sprintf

_printf_post_padding (Thumb, 32 bytes, Stack size 24 bytes, printfa.o(i._printf_post_padding), UNUSED)

[Called By]

- >> _printf_core

_printf_pre_padding (Thumb, 44 bytes, Stack size 40 bytes, printfa.o(i._printf_pre_padding), UNUSED)

[Called By]

- >> _printf_core

_sputc (Thumb, 10 bytes, Stack size 0 bytes, printfa.o(i._sputc))

[Called By]

- >> __0sprintf

[Address Reference Count : 1]

- printfa.o(i.__0sprintf)

### Undefined Global Symbols
