EmbeddedSystemClass/2019-Animal-Collars/Electrical Source/Firmware/MDK-ARM/TEST/TEST.htm

# Static Call Graph for image TEST\TEST.axf

#<CALLGRAPH># ARM Linker, 6120001: Last Updated: Mon Jul 29 14:12:27 2019

### Maximum Stack Usage = 600 bytes + Unknown(Cycles, Untraceable Function Pointers)

### Call chain for Maximum Stack Depth:

main ⇒ GPS_subroutine ⇒ GPS_getNMEA ⇒ atoi ⇒ strtol ⇒ _strtoul

### Mutually Recursive functions

- ADC1_COMP_IRQHandler ⇒ ADC1_COMP_IRQHandler

### Function Pointers

- ADC1_COMP_IRQHandler from startup_stm32l071xx.o(.text) referenced from startup_stm32l071xx.o(RESET)
- CC_SendByte from comport.o(.text.CC_SendByte) referenced from comport.o(.text.CC_DownloadFixes)
- CC_SendData from comport.o(.text.CC_SendData) referenced from comport.o(.text.CC_DownloadFixes)
- CC_SendData from comport.o(.text.CC_SendData) referenced from xbee.o(.text.XB_ConfigureDevice)
- CC_SendData from comport.o(.text.CC_SendData) referenced from xbee.o(.text.XB_GetSN)
- DMA1_Channel1_IRQHandler from startup_stm32l071xx.o(.text) referenced from startup_stm32l071xx.o(RESET)
- DMA1_Channel2_3_IRQHandler from startup_stm32l071xx.o(.text) referenced from startup_stm32l071xx.o(RESET)
- DMA1_Channel4_5_6_7_IRQHandler from startup_stm32l071xx.o(.text) referenced from startup_stm32l071xx.o(RESET)
- EXTI0_1_IRQHandler from startup_stm32l071xx.o(.text) referenced from startup_stm32l071xx.o(RESET)
- EXTI2_3_IRQHandler from startup_stm32l071xx.o(.text) referenced from startup_stm32l071xx.o(RESET)
- EXTI4_15_IRQHandler from startup_stm32l071xx.o(.text) referenced from startup_stm32l071xx.o(RESET)
- FLASH_IRQHandler from startup_stm32l071xx.o(.text) referenced from startup_stm32l071xx.o(RESET)
- FLASH_writeWord from flash.o(.text.FLASH_writeWord) referenced from flash.o(.text.FLASH_saveFix)
- HardFault_Handler from stm32l0xx_it.o(.text.HardFault_Handler) referenced from startup_stm32l071xx.o(RESET)
- I2C1_IRQHandler from startup_stm32l071xx.o(.text) referenced from startup_stm32l071xx.o(RESET)
- I2C2_IRQHandler from startup_stm32l071xx.o(.text) referenced from startup_stm32l071xx.o(RESET)
- I2C3_IRQHandler from startup_stm32l071xx.o(.text) referenced from startup_stm32l071xx.o(RESET)
- LL_GPIO_Init from stm32l0xx_ll_gpio.o(.text.LL_GPIO_Init) referenced from lowpower.o(.text.LPM_gpioInit)
- LL_GPIO_Init from stm32l0xx_ll_gpio.o(.text.LL_GPIO_Init) referenced from main.o(.text.main)
- LL_IOP_GRP1_EnableClock from main.o(.text.LL_IOP_GRP1_EnableClock) referenced 2 times from main.o(.text.main)
- LPTIM1_IRQHandler from startup_stm32l071xx.o(.text) referenced from startup_stm32l071xx.o(RESET)
- LPUART1_IRQHandler from startup_stm32l071xx.o(.text) referenced from startup_stm32l071xx.o(RESET)
- NMI_Handler from stm32l0xx_it.o(.text.NMI_Handler) referenced from startup_stm32l071xx.o(RESET)
- PVD_IRQHandler from startup_stm32l071xx.o(.text) referenced from startup_stm32l071xx.o(RESET)
- PendSV_Handler from stm32l0xx_it.o(.text.PendSV_Handler) referenced from startup_stm32l071xx.o(RESET)
- RCC_IRQHandler from startup_stm32l071xx.o(.text) referenced from startup_stm32l071xx.o(RESET)
- RTC_IRQHandler from stm32l0xx_it.o(.text.RTC_IRQHandler) referenced from startup_stm32l071xx.o(RESET)
- Reset_Handler from startup_stm32l071xx.o(.text) referenced from startup_stm32l071xx.o(RESET)
- SPI1_IRQHandler from stm32l0xx_it.o(.text.SPI1_IRQHandler) referenced from startup_stm32l071xx.o(RESET)
- SPI2_IRQHandler from startup_stm32l071xx.o(.text) referenced from startup_stm32l071xx.o(RESET)
- SVC_Handler from stm32l0xx_it.o(.text.SVC_Handler) referenced from startup_stm32l071xx.o(RESET)
- SysTick_Handler from stm32l0xx_it.o(.text.SysTick_Handler) referenced from startup_stm32l071xx.o(RESET)
- SystemInit from system_stm32l0xx.o(.text.SystemInit) referenced from startup_stm32l071xx.o(.text)
- TIM21_IRQHandler from startup_stm32l071xx.o(.text) referenced from startup_stm32l071xx.o(RESET)
- TIM22_IRQHandler from startup_stm32l071xx.o(.text) referenced from startup_stm32l071xx.o(RESET)
- TIM2_IRQHandler from stm32l0xx_it.o(.text.TIM2_IRQHandler) referenced from startup_stm32l071xx.o(RESET)
- TIM3_IRQHandler from startup_stm32l071xx.o(.text) referenced from startup_stm32l071xx.o(RESET)
- TIM6_IRQHandler from startup_stm32l071xx.o(.text) referenced from startup_stm32l071xx.o(RESET)
- TIM7_IRQHandler from startup_stm32l071xx.o(.text) referenced from startup_stm32l071xx.o(RESET)
- USART1_IRQHandler from stm32l0xx_it.o(.text.USART1_IRQHandler) referenced from startup_stm32l071xx.o(RESET)
- USART2_IRQHandler from startup_stm32l071xx.o(.text) referenced from startup_stm32l071xx.o(RESET)
- USART4_5_IRQHandler from stm32l0xx_it.o(.text.USART4_5_IRQHandler) referenced from startup_stm32l071xx.o(RESET)
- WWDG_IRQHandler from startup_stm32l071xx.o(.text) referenced from startup_stm32l071xx.o(RESET)
- XB_GetResponse from xbee.o(.text.XB_GetResponse) referenced from xbee.o(.text.XB_ConfigureDevice)
- XB_GetResponse from xbee.o(.text.XB_GetResponse) referenced from xbee.o(.text.XB_GetSN)
- XB_SendByte from xbee.o(.text.XB_SendByte) referenced from xbee.o(.text.XB_ConfigureDevice)
- XB_SendByte from xbee.o(.text.XB_SendByte) referenced from xbee.o(.text.XB_TransmitFixes)
- XB_SendData from xbee.o(.text.XB_SendData) referenced from xbee.o(.text.XB_ConfigureDevice)
- XB_SendData from xbee.o(.text.XB_SendData) referenced from xbee.o(.text.XB_GetSN)
- XB_SendData from xbee.o(.text.XB_SendData) referenced from xbee.o(.text.XB_TransmitFixes)
- __main from entry.o(.ARM.Collect$$$$00000000) referenced from startup_stm32l071xx.o(.text)
- _sputc from printf5.o(i._sputc) referenced from printf5.o(i.__0sprintf$5)
- main from main.o(.text.main) referenced from entry9a.o(.ARM.Collect$$$$0000000B)

### Global Symbols

__main (Thumb, 0 bytes, Stack size unknown bytes, entry.o(.ARM.Collect$$$$00000000))
[Address Reference Count : 1]

- startup_stm32l071xx.o(.text)

_main_stk (Thumb, 0 bytes, Stack size unknown bytes, entry2.o(.ARM.Collect$$$$00000001))

_main_scatterload (Thumb, 0 bytes, Stack size unknown bytes, entry5.o(.ARM.Collect$$$$00000004))

[Calls]

- >> __scatterload

__main_after_scatterload (Thumb, 0 bytes, Stack size unknown bytes, entry5.o(.ARM.Collect$$$$00000004))

[Called By]

- >> __scatterload

_main_clock (Thumb, 0 bytes, Stack size unknown bytes, entry7b.o(.ARM.Collect$$$$00000008))

_main_cpp_init (Thumb, 0 bytes, Stack size unknown bytes, entry8b.o(.ARM.Collect$$$$0000000A))

_main_init (Thumb, 0 bytes, Stack size unknown bytes, entry9a.o(.ARM.Collect$$$$0000000B))

__rt_final_cpp (Thumb, 0 bytes, Stack size unknown bytes, entry10a.o(.ARM.Collect$$$$0000000D))

__rt_final_exit (Thumb, 0 bytes, Stack size unknown bytes, entry11a.o(.ARM.Collect$$$$0000000F))

Reset_Handler (Thumb, 8 bytes, Stack size 0 bytes, startup_stm32l071xx.o(.text))
[Address Reference Count : 1]

- startup_stm32l071xx.o(RESET)

ADC1_COMP_IRQHandler (Thumb, 0 bytes, Stack size 0 bytes, startup_stm32l071xx.o(.text))

[Calls]

- >> ADC1_COMP_IRQHandler

[Called By]

- >> ADC1_COMP_IRQHandler

[Address Reference Count : 1]

- startup_stm32l071xx.o(RESET)

DMA1_Channel1_IRQHandler (Thumb, 0 bytes, Stack size 0 bytes, startup_stm32l071xx.o(.text))
[Address Reference Count : 1]

- startup_stm32l071xx.o(RESET)

DMA1_Channel2_3_IRQHandler (Thumb, 0 bytes, Stack size 0 bytes, startup_stm32l071xx.o(.text))
[Address Reference Count : 1]

- startup_stm32l071xx.o(RESET)

DMA1_Channel4_5_6_7_IRQHandler (Thumb, 0 bytes, Stack size 0 bytes, startup_stm32l071xx.o(.text))
[Address Reference Count : 1]

- startup_stm32l071xx.o(RESET)

EXTI0_1_IRQHandler (Thumb, 0 bytes, Stack size 0 bytes, startup_stm32l071xx.o(.text))
[Address Reference Count : 1]

- startup_stm32l071xx.o(RESET)

EXTI2_3_IRQHandler (Thumb, 0 bytes, Stack size 0 bytes, startup_stm32l071xx.o(.text))
[Address Reference Count : 1]

- startup_stm32l071xx.o(RESET)

EXTI4_15_IRQHandler (Thumb, 0 bytes, Stack size 0 bytes, startup_stm32l071xx.o(.text))
[Address Reference Count : 1]

- startup_stm32l071xx.o(RESET)

FLASH_IRQHandler (Thumb, 0 bytes, Stack size 0 bytes, startup_stm32l071xx.o(.text))
[Address Reference Count : 1]

- startup_stm32l071xx.o(RESET)

I2C1_IRQHandler (Thumb, 0 bytes, Stack size 0 bytes, startup_stm32l071xx.o(.text))
[Address Reference Count : 1]

- startup_stm32l071xx.o(RESET)

I2C2_IRQHandler (Thumb, 0 bytes, Stack size 0 bytes, startup_stm32l071xx.o(.text))
[Address Reference Count : 1]

- startup_stm32l071xx.o(RESET)

I2C3_IRQHandler (Thumb, 0 bytes, Stack size 0 bytes, startup_stm32l071xx.o(.text))
[Address Reference Count : 1]

- startup_stm32l071xx.o(RESET)

LPTIM1_IRQHandler (Thumb, 0 bytes, Stack size 0 bytes, startup_stm32l071xx.o(.text))
[Address Reference Count : 1]

- startup_stm32l071xx.o(RESET)

LPUART1_IRQHandler (Thumb, 0 bytes, Stack size 0 bytes, startup_stm32l071xx.o(.text))
[Address Reference Count : 1]

- startup_stm32l071xx.o(RESET)

PVD_IRQHandler (Thumb, 0 bytes, Stack size 0 bytes, startup_stm32l071xx.o(.text))
[Address Reference Count : 1]

- startup_stm32l071xx.o(RESET)

RCC_IRQHandler (Thumb, 0 bytes, Stack size 0 bytes, startup_stm32l071xx.o(.text))
[Address Reference Count : 1]

- startup_stm32l071xx.o(RESET)

SPI2_IRQHandler (Thumb, 0 bytes, Stack size 0 bytes, startup_stm32l071xx.o(.text))
[Address Reference Count : 1]

- startup_stm32l071xx.o(RESET)

TIM21_IRQHandler (Thumb, 0 bytes, Stack size 0 bytes, startup_stm32l071xx.o(.text))
[Address Reference Count : 1]

- startup_stm32l071xx.o(RESET)

TIM22_IRQHandler (Thumb, 0 bytes, Stack size 0 bytes, startup_stm32l071xx.o(.text))
[Address Reference Count : 1]

- startup_stm32l071xx.o(RESET)

TIM3_IRQHandler (Thumb, 0 bytes, Stack size 0 bytes, startup_stm32l071xx.o(.text))
[Address Reference Count : 1]

- startup_stm32l071xx.o(RESET)

TIM6_IRQHandler (Thumb, 0 bytes, Stack size 0 bytes, startup_stm32l071xx.o(.text))
[Address Reference Count : 1]

- startup_stm32l071xx.o(RESET)

TIM7_IRQHandler (Thumb, 0 bytes, Stack size 0 bytes, startup_stm32l071xx.o(.text))
[Address Reference Count : 1]

- startup_stm32l071xx.o(RESET)

USART2_IRQHandler (Thumb, 0 bytes, Stack size 0 bytes, startup_stm32l071xx.o(.text))
[Address Reference Count : 1]

- startup_stm32l071xx.o(RESET)

WWDG_IRQHandler (Thumb, 0 bytes, Stack size 0 bytes, startup_stm32l071xx.o(.text))
[Address Reference Count : 1]

- startup_stm32l071xx.o(RESET)

__aeabi_uidiv (Thumb, 0 bytes, Stack size 12 bytes, uidiv.o(.text))

[Stack]

- Max Depth = 12
- Call Chain = __aeabi_uidiv

[Called By]

- >> GPS_subroutine
- >> LL_RTC_TIME_Init
- >> LL_RTC_DATE_Init
- >> LL_USART_Init
- >> LL_Init1msTick
- >> RCC_PLL_GetFreqDomain_SYS

__aeabi_uidivmod (Thumb, 44 bytes, Stack size 12 bytes, uidiv.o(.text))

[Stack]

- Max Depth = 12
- Call Chain = __aeabi_uidivmod

[Called By]

- >> __aeabi_idivmod

__aeabi_idiv (Thumb, 0 bytes, Stack size 16 bytes, idiv.o(.text), UNUSED)

__aeabi_idivmod (Thumb, 40 bytes, Stack size 16 bytes, idiv.o(.text))

[Stack]

- Max Depth = 28
- Call Chain = __aeabi_idivmod ⇒ __aeabi_uidivmod

[Calls]

- >> __aeabi_uidivmod

[Called By]

- >> GPS_subroutine
- >> CC_SetRTC

__aeabi_memcpy (Thumb, 36 bytes, Stack size 0 bytes, memcpya.o(.text))

[Called By]

- >> GPS_getNMEA
- >> XB_ConfigureDevice

__aeabi_memcpy4 (Thumb, 0 bytes, Stack size 0 bytes, memcpya.o(.text), UNUSED)

__aeabi_memcpy8 (Thumb, 0 bytes, Stack size 0 bytes, memcpya.o(.text), UNUSED)

__aeabi_memset (Thumb, 14 bytes, Stack size 0 bytes, memseta.o(.text))

[Called By]

- >> _memset$wrapper
- >> __aeabi_memclr

__aeabi_memset4 (Thumb, 0 bytes, Stack size 0 bytes, memseta.o(.text), UNUSED)

__aeabi_memset8 (Thumb, 0 bytes, Stack size 0 bytes, memseta.o(.text), UNUSED)

__aeabi_memclr (Thumb, 4 bytes, Stack size 0 bytes, memseta.o(.text))

[Calls]

- >> __aeabi_memset

[Called By]

- >> XB_ConfigureDevice

__aeabi_memclr4 (Thumb, 0 bytes, Stack size 0 bytes, memseta.o(.text))

[Called By]

- >> XB_TransmitFixes
- >> XB_ParseCommand
- >> GPS_getNMEA
- >> XB_GetSN
- >> XB_GetConfig
- >> CC_SetProgram
- >> CC_ParseCommand
- >> CC_DownloadFixes
- >> CC_ConfigureXbee

__aeabi_memclr8 (Thumb, 0 bytes, Stack size 0 bytes, memseta.o(.text), UNUSED)

_memset$wrapper (Thumb, 18 bytes, Stack size 8 bytes, memseta.o(.text), UNUSED)

[Calls]

- >> __aeabi_memset

strncpy (Thumb, 26 bytes, Stack size 8 bytes, strncpy.o(.text))

[Stack]

- Max Depth = 8
- Call Chain = strncpy

[Called By]

- >> GPS_getNMEA

strlen (Thumb, 14 bytes, Stack size 0 bytes, strlen.o(.text))

[Called By]

- >> XB_GetResponse
- >> GPS_getNMEA
- >> XB_ConfigureDevice
- >> CC_SetRTC
- >> CC_SendTimestamp
- >> CC_ReadProgram
- >> CC_ConfigureXbee

memcmp (Thumb, 26 bytes, Stack size 12 bytes, memcmp.o(.text))

[Stack]

- Max Depth = 12
- Call Chain = memcmp

[Called By]

- >> XB_ParseCommand
- >> CC_ParseCommand
- >> CC_CheckForHandshake

strtok (Thumb, 68 bytes, Stack size 16 bytes, strtok.o(.text))

[Stack]

- Max Depth = 16
- Call Chain = strtok

[Called By]

- >> GPS_getNMEA

atoi (Thumb, 26 bytes, Stack size 16 bytes, atoi.o(.text))

[Stack]

- Max Depth = 88
- Call Chain = atoi ⇒ strtol ⇒ _strtoul

[Calls]

- >> strtol
- >> __aeabi_errno_addr

[Called By]

- >> GPS_getNMEA

__aeabi_fcmple (Thumb, 28 bytes, Stack size 0 bytes, fcmple.o(.text))

[Called By]

- >> GPS_subroutine

__aeabi_i2f (Thumb, 22 bytes, Stack size 8 bytes, fflti.o(.text))

[Stack]

- Max Depth = 20
- Call Chain = __aeabi_i2f ⇒ _float_epilogue

[Calls]

- >> _float_epilogue

[Called By]

- >> GPS_getNMEA

__aeabi_uldivmod (Thumb, 96 bytes, Stack size 48 bytes, uldiv.o(.text), UNUSED)

[Calls]

- >> __aeabi_llsr
- >> __aeabi_llsl

[Called By]

- >> _printf_core

strtol (Thumb, 108 bytes, Stack size 32 bytes, strtol.o(.text))

[Stack]

- Max Depth = 72
- Call Chain = strtol ⇒ _strtoul

[Calls]

- >> _strtoul
- >> __rt_ctype_table
- >> __aeabi_errno_addr

[Called By]

- >> atoi

__I$use$fp (Thumb, 0 bytes, Stack size 0 bytes, iusefp.o(.text), UNUSED)

_float_round (Thumb, 16 bytes, Stack size 0 bytes, fepilogue.o(.text), UNUSED)

_float_epilogue (Thumb, 114 bytes, Stack size 12 bytes, fepilogue.o(.text))

[Stack]

- Max Depth = 12
- Call Chain = _float_epilogue

[Called By]

- >> __aeabi_i2f

__scatterload (Thumb, 28 bytes, Stack size 0 bytes, init.o(.text))

[Calls]

- >> __main_after_scatterload

[Called By]

- >> _main_scatterload

__scatterload_rt2 (Thumb, 0 bytes, Stack size 0 bytes, init.o(.text), UNUSED)

__aeabi_llsl (Thumb, 32 bytes, Stack size 8 bytes, llshl.o(.text), UNUSED)

[Called By]

- >> __aeabi_uldivmod

_ll_shift_l (Thumb, 0 bytes, Stack size 8 bytes, llshl.o(.text), UNUSED)

__aeabi_llsr (Thumb, 34 bytes, Stack size 8 bytes, llushr.o(.text), UNUSED)

[Called By]

- >> __aeabi_uldivmod

_ll_ushift_r (Thumb, 0 bytes, Stack size 8 bytes, llushr.o(.text), UNUSED)

__rt_ctype_table (Thumb, 4 bytes, Stack size 0 bytes, ctype_o.o(.text))

[Called By]

- >> strtol

_strtoul (Thumb, 166 bytes, Stack size 40 bytes, _strtoul.o(.text))

[Stack]

- Max Depth = 40
- Call Chain = _strtoul

[Calls]

- >> _chval
- >> __aeabi_errno_addr

[Called By]

- >> strtol

_chval (Thumb, 30 bytes, Stack size 0 bytes, _chval.o(.text))

[Called By]

- >> _strtoul

CC_CheckForHandshake (Thumb, 120 bytes, Stack size 32 bytes, comport.o(.text.CC_CheckForHandshake))

[Stack]

- Max Depth = 48
- Call Chain = CC_CheckForHandshake ⇒ CC_SendData

[Calls]

- >> CC_SendData
- >> memcmp

[Called By]

- >> main

CC_ComPortPresent (Thumb, 4 bytes, Stack size 0 bytes, comport.o(.text.CC_ComPortPresent))

[Called By]

- >> main

CC_ConfigureXbee (Thumb, 108 bytes, Stack size 72 bytes, comport.o(.text.CC_ConfigureXbee))

[Stack]

- Max Depth = 168
- Call Chain = CC_ConfigureXbee ⇒ XB_ConfigureDevice ⇒ XB_EnableXbee

[Calls]

- >> XB_ConfigureDevice
- >> TIM2_initDelay_inline
- >> strlen
- >> __aeabi_memclr4

[Called By]

- >> CC_ExecuteCommand

CC_DownloadFixes (Thumb, 208 bytes, Stack size 96 bytes, comport.o(.text.CC_DownloadFixes))

[Stack]

- Max Depth = 128
- Call Chain = CC_DownloadFixes ⇒ FLASH_readFixes ⇒ FLASH_ReadData

[Calls]

- >> FLASH_readFixes
- >> CC_SendByte
- >> __aeabi_memclr4

[Called By]

- >> CC_ExecuteCommand

CC_ExecuteCommand (Thumb, 92 bytes, Stack size 8 bytes, comport.o(.text.CC_ExecuteCommand))

[Stack]

- Max Depth = 176
- Call Chain = CC_ExecuteCommand ⇒ CC_ConfigureXbee ⇒ XB_ConfigureDevice ⇒ XB_EnableXbee

[Calls]

- >> XB_GetSN
- >> XB_GetConfig
- >> FLASH_initDataStorage
- >> CC_SetRTC
- >> CC_SetProgram
- >> CC_SendTimestamp
- >> CC_ReadProgram
- >> CC_DownloadFixes
- >> CC_ConfigureXbee

[Called By]

- >> main

CC_ParseCommand (Thumb, 328 bytes, Stack size 72 bytes, comport.o(.text.CC_ParseCommand))

[Stack]

- Max Depth = 84
- Call Chain = CC_ParseCommand ⇒ memcmp

[Calls]

- >> memcmp
- >> __aeabi_memclr4

[Called By]

- >> main

CC_ReadProgram (Thumb, 40 bytes, Stack size 64 bytes, comport.o(.text.CC_ReadProgram))

[Stack]

- Max Depth = 80
- Call Chain = CC_ReadProgram ⇒ CC_SendData

[Calls]

- >> FLASH_ReadData
- >> CC_SendData
- >> strlen

[Called By]

- >> CC_ExecuteCommand

CC_SendByte (Thumb, 20 bytes, Stack size 0 bytes, comport.o(.text.CC_SendByte))

[Called By]

- >> CC_SendData
- >> CC_DownloadFixes

[Address Reference Count : 1]

- comport.o(.text.CC_DownloadFixes)

CC_SendData (Thumb, 26 bytes, Stack size 16 bytes, comport.o(.text.CC_SendData))

[Stack]

- Max Depth = 16
- Call Chain = CC_SendData

[Calls]

- >> CC_SendByte

[Called By]

- >> CC_SetRTC
- >> CC_SendTimestamp
- >> CC_ReadProgram
- >> CC_CheckForHandshake

[Address Reference Count : 3]

- xbee.o(.text.XB_ConfigureDevice)
- xbee.o(.text.XB_GetSN)
- comport.o(.text.CC_DownloadFixes)

CC_SendTimestamp (Thumb, 100 bytes, Stack size 64 bytes, comport.o(.text.CC_SendTimestamp))

[Stack]

- Max Depth = 88
- Call Chain = CC_SendTimestamp ⇒ __2sprintf

[Calls]

- >> CC_SendData
- >> strlen
- >> __2sprintf

[Called By]

- >> CC_ExecuteCommand

CC_SetProgram (Thumb, 212 bytes, Stack size 88 bytes, comport.o(.text.CC_SetProgram))

[Stack]

- Max Depth = 96
- Call Chain = CC_SetProgram ⇒ EEPROM_WriteData

[Calls]

- >> TIM2_initDelay_inline
- >> FLASH_Unlock
- >> FLASH_Lock
- >> EEPROM_WriteData
- >> __aeabi_memclr4

[Called By]

- >> CC_ExecuteCommand

CC_SetRTC (Thumb, 316 bytes, Stack size 80 bytes, comport.o(.text.CC_SetRTC))

[Stack]

- Max Depth = 144
- Call Chain = CC_SetRTC ⇒ LL_RTC_TIME_Init ⇒ LL_RTC_WaitForSynchro

[Calls]

- >> TIM2_initDelay_inline
- >> LL_RTC_TIME_Init
- >> LL_RTC_DATE_Init
- >> CC_SendData
- >> strlen
- >> __aeabi_idivmod
- >> __2sprintf

[Called By]

- >> CC_ExecuteCommand

EEPROM_WriteByte (Thumb, 6 bytes, Stack size 0 bytes, flash.o(.text.EEPROM_WriteByte))

[Called By]

- >> scheduler

EEPROM_WriteData (Thumb, 20 bytes, Stack size 8 bytes, flash.o(.text.EEPROM_WriteData))

[Stack]

- Max Depth = 8
- Call Chain = EEPROM_WriteData

[Called By]

- >> FLASH_saveFix
- >> FLASH_initDataStorage
- >> CC_SetProgram

FLASH_Lock (Thumb, 24 bytes, Stack size 0 bytes, flash.o(.text.FLASH_Lock))

[Called By]

- >> scheduler
- >> FLASH_saveFix
- >> FLASH_initDataStorage
- >> CC_SetProgram

FLASH_ReadData (Thumb, 20 bytes, Stack size 8 bytes, flash.o(.text.FLASH_ReadData))

[Stack]

- Max Depth = 8
- Call Chain = FLASH_ReadData

[Called By]

- >> scheduler
- >> FLASH_saveFix
- >> FLASH_readFixes
- >> CC_ReadProgram

FLASH_Unlock (Thumb, 36 bytes, Stack size 0 bytes, flash.o(.text.FLASH_Unlock))

[Called By]

- >> scheduler
- >> CC_SetProgram

FLASH_erasePage (Thumb, 52 bytes, Stack size 0 bytes, flash.o(.text.FLASH_erasePage))

[Called By]

- >> FLASH_saveFix
- >> FLASH_initDataStorage

FLASH_initDataStorage (Thumb, 72 bytes, Stack size 16 bytes, flash.o(.text.FLASH_initDataStorage))

[Stack]

- Max Depth = 24
- Call Chain = FLASH_initDataStorage ⇒ EEPROM_WriteData

[Calls]

- >> FLASH_unlockPrgm
- >> FLASH_erasePage
- >> FLASH_Lock
- >> EEPROM_WriteData

[Called By]

- >> CC_ExecuteCommand

FLASH_readFixes (Thumb, 88 bytes, Stack size 24 bytes, flash.o(.text.FLASH_readFixes))

[Stack]

- Max Depth = 32
- Call Chain = FLASH_readFixes ⇒ FLASH_ReadData

[Calls]

- >> FLASH_ReadData

[Called By]

- >> XB_TransmitFixes
- >> CC_DownloadFixes

FLASH_saveFix (Thumb, 196 bytes, Stack size 56 bytes, flash.o(.text.FLASH_saveFix))

[Stack]

- Max Depth = 64
- Call Chain = FLASH_saveFix ⇒ FLASH_ReadData

[Calls]

- >> FLASH_unlockPrgm
- >> FLASH_erasePage
- >> FLASH_ReadData
- >> FLASH_Lock
- >> EEPROM_WriteData

[Called By]

- >> GPS_subroutine

FLASH_unlockPrgm (Thumb, 44 bytes, Stack size 0 bytes, flash.o(.text.FLASH_unlockPrgm))

[Called By]

- >> FLASH_saveFix
- >> FLASH_initDataStorage

FLASH_writeWord (Thumb, 44 bytes, Stack size 0 bytes, flash.o(.text.FLASH_writeWord))
[Address Reference Count : 1]

- flash.o(.text.FLASH_saveFix)

GPS_GPSCSHigh (Thumb, 20 bytes, Stack size 0 bytes, gps.o(.text.GPS_GPSCSHigh))

[Called By]

- >> main

GPS_GPSDisable (Thumb, 16 bytes, Stack size 0 bytes, gps.o(.text.GPS_GPSDisable))

[Called By]

- >> main
- >> LPM_stop

GPS_UBX_enablePUBX_Position (Thumb, 48 bytes, Stack size 0 bytes, gps.o(.text.GPS_UBX_enablePUBX_Position))

[Called By]

- >> GPS_subroutine

GPS_getNMEA (Thumb, 656 bytes, Stack size 232 bytes, gps.o(.text.GPS_getNMEA))

[Stack]

- Max Depth = 320
- Call Chain = GPS_getNMEA ⇒ atoi ⇒ strtol ⇒ _strtoul

[Calls]

- >> __aeabi_i2f
- >> strtok
- >> strlen
- >> strncpy
- >> __aeabi_memclr4
- >> __aeabi_memcpy
- >> atoi

[Called By]

- >> GPS_subroutine

GPS_subroutine (Thumb, 844 bytes, Stack size 160 bytes, gps.o(.text.GPS_subroutine))

[Stack]

- Max Depth = 480
- Call Chain = GPS_subroutine ⇒ GPS_getNMEA ⇒ atoi ⇒ strtol ⇒ _strtoul

[Calls]

- >> __aeabi_fcmple
- >> TIM2_delay
- >> RTC_setTimeDate
- >> RTC_getTimeDate
- >> GPS_getNMEA
- >> GPS_UBX_enablePUBX_Position
- >> FLASH_saveFix
- >> TIM2_initDelay_inline
- >> __aeabi_idivmod
- >> __aeabi_uidiv

[Called By]

- >> main

HardFault_Handler (Thumb, 4 bytes, Stack size 0 bytes, stm32l0xx_it.o(.text.HardFault_Handler))

[Calls]

- >> NVIC_SystemReset

[Address Reference Count : 1]

- startup_stm32l071xx.o(RESET)

LL_GPIO_Init (Thumb, 158 bytes, Stack size 24 bytes, stm32l0xx_ll_gpio.o(.text.LL_GPIO_Init))

[Stack]

- Max Depth = 24
- Call Chain = LL_GPIO_Init

[Address Reference Count : 2]

- lowpower.o(.text.LPM_gpioInit)
- main.o(.text.main)

LL_Init1msTick (Thumb, 32 bytes, Stack size 8 bytes, stm32l0xx_ll_utils.o(.text.LL_Init1msTick))

[Stack]

- Max Depth = 20
- Call Chain = LL_Init1msTick ⇒ __aeabi_uidiv

[Calls]

- >> __aeabi_uidiv

[Called By]

- >> SystemClock_Config

LL_RCC_GetSystemClocksFreq (Thumb, 68 bytes, Stack size 16 bytes, stm32l0xx_ll_rcc.o(.text.LL_RCC_GetSystemClocksFreq))

[Stack]

- Max Depth = 44
- Call Chain = LL_RCC_GetSystemClocksFreq ⇒ RCC_GetSystemClockFreq ⇒ RCC_PLL_GetFreqDomain_SYS ⇒ __aeabi_uidiv

[Calls]

- >> RCC_GetSystemClockFreq

[Called By]

- >> LL_USART_Init

LL_RCC_GetUSARTClockFreq (Thumb, 204 bytes, Stack size 8 bytes, stm32l0xx_ll_rcc.o(.text.LL_RCC_GetUSARTClockFreq))

[Stack]

- Max Depth = 36
- Call Chain = LL_RCC_GetUSARTClockFreq ⇒ RCC_GetSystemClockFreq ⇒ RCC_PLL_GetFreqDomain_SYS ⇒ __aeabi_uidiv

[Calls]

- >> RCC_GetSystemClockFreq

[Called By]

- >> LL_USART_Init

LL_RTC_DATE_Init (Thumb, 200 bytes, Stack size 40 bytes, stm32l0xx_ll_rtc.o(.text.LL_RTC_DATE_Init))

[Stack]

- Max Depth = 64
- Call Chain = LL_RTC_DATE_Init ⇒ LL_RTC_WaitForSynchro

[Calls]

- >> LL_RTC_WaitForSynchro
- >> LL_RTC_EnterInitMode
- >> LL_RTC_DATE_Config
- >> __aeabi_uidiv

[Called By]

- >> RTC_setTimeDate
- >> CC_SetRTC
- >> main

LL_RTC_EnterInitMode (Thumb, 72 bytes, Stack size 12 bytes, stm32l0xx_ll_rtc.o(.text.LL_RTC_EnterInitMode))

[Stack]

- Max Depth = 12
- Call Chain = LL_RTC_EnterInitMode

[Called By]

- >> LL_RTC_TIME_Init
- >> LL_RTC_DATE_Init
- >> LL_RTC_Init

LL_RTC_Init (Thumb, 88 bytes, Stack size 16 bytes, stm32l0xx_ll_rtc.o(.text.LL_RTC_Init))

[Stack]

- Max Depth = 28
- Call Chain = LL_RTC_Init ⇒ LL_RTC_EnterInitMode

[Calls]

- >> LL_RTC_EnterInitMode

[Called By]

- >> main

LL_RTC_TIME_Init (Thumb, 196 bytes, Stack size 40 bytes, stm32l0xx_ll_rtc.o(.text.LL_RTC_TIME_Init))

[Stack]

- Max Depth = 64
- Call Chain = LL_RTC_TIME_Init ⇒ LL_RTC_WaitForSynchro

[Calls]

- >> LL_RTC_WaitForSynchro
- >> LL_RTC_EnterInitMode
- >> LL_RTC_TIME_Config
- >> __aeabi_uidiv

[Called By]

- >> RTC_setTimeDate
- >> CC_SetRTC
- >> main

LL_RTC_WaitForSynchro (Thumb, 124 bytes, Stack size 24 bytes, stm32l0xx_ll_rtc.o(.text.LL_RTC_WaitForSynchro))

[Stack]

- Max Depth = 24
- Call Chain = LL_RTC_WaitForSynchro

[Called By]

- >> LL_RTC_TIME_Init
- >> LL_RTC_DATE_Init

LL_SPI_Init (Thumb, 124 bytes, Stack size 40 bytes, stm32l0xx_ll_spi.o(.text.LL_SPI_Init))

[Stack]

- Max Depth = 40
- Call Chain = LL_SPI_Init

[Called By]

- >> main

LL_SetSystemCoreClock (Thumb, 12 bytes, Stack size 0 bytes, stm32l0xx_ll_utils.o(.text.LL_SetSystemCoreClock))

[Called By]

- >> SystemClock_Config

LL_TIM_Init (Thumb, 84 bytes, Stack size 16 bytes, stm32l0xx_ll_tim.o(.text.LL_TIM_Init))

[Stack]

- Max Depth = 16
- Call Chain = LL_TIM_Init

[Called By]

- >> main

LL_USART_Init (Thumb, 200 bytes, Stack size 32 bytes, stm32l0xx_ll_usart.o(.text.LL_USART_Init))

[Stack]

- Max Depth = 76
- Call Chain = LL_USART_Init ⇒ LL_RCC_GetSystemClocksFreq ⇒ RCC_GetSystemClockFreq ⇒ RCC_PLL_GetFreqDomain_SYS ⇒ __aeabi_uidiv

[Calls]

- >> LL_RCC_GetSystemClocksFreq
- >> __aeabi_uidiv
- >> LL_RCC_GetUSARTClockFreq

[Called By]

- >> main

LPM_gpioInit (Thumb, 128 bytes, Stack size 56 bytes, lowpower.o(.text.LPM_gpioInit))

[Stack]

- Max Depth = 56
- Call Chain = LPM_gpioInit

[Called By]

- >> main

LPM_stop (Thumb, 104 bytes, Stack size 16 bytes, lowpower.o(.text.LPM_stop))

[Stack]

- Max Depth = 16
- Call Chain = LPM_stop

[Calls]

- >> XB_DisableXbee
- >> VHF_DisableVHF
- >> GPS_GPSDisable

[Called By]

- >> main

NMI_Handler (Thumb, 2 bytes, Stack size 0 bytes, stm32l0xx_it.o(.text.NMI_Handler))
[Address Reference Count : 1]

- startup_stm32l071xx.o(RESET)

PendSV_Handler (Thumb, 2 bytes, Stack size 0 bytes, stm32l0xx_it.o(.text.PendSV_Handler))
[Address Reference Count : 1]

- startup_stm32l071xx.o(RESET)

RCC_GetSystemClockFreq (Thumb, 76 bytes, Stack size 8 bytes, stm32l0xx_ll_rcc.o(.text.RCC_GetSystemClockFreq))

[Stack]

- Max Depth = 28
- Call Chain = RCC_GetSystemClockFreq ⇒ RCC_PLL_GetFreqDomain_SYS ⇒ __aeabi_uidiv

[Calls]

- >> RCC_PLL_GetFreqDomain_SYS

[Called By]

- >> LL_RCC_GetSystemClocksFreq
- >> LL_RCC_GetUSARTClockFreq

RCC_PLL_GetFreqDomain_SYS (Thumb, 76 bytes, Stack size 8 bytes, stm32l0xx_ll_rcc.o(.text.RCC_PLL_GetFreqDomain_SYS))

[Stack]

- Max Depth = 20
- Call Chain = RCC_PLL_GetFreqDomain_SYS ⇒ __aeabi_uidiv

[Calls]

- >> __aeabi_uidiv

[Called By]

- >> RCC_GetSystemClockFreq

RTC_IRQHandler (Thumb, 48 bytes, Stack size 0 bytes, stm32l0xx_it.o(.text.RTC_IRQHandler))
[Address Reference Count : 1]

- startup_stm32l071xx.o(RESET)

RTC_getTimeDate (Thumb, 76 bytes, Stack size 8 bytes, timers.o(.text.RTC_getTimeDate))

[Stack]

- Max Depth = 8
- Call Chain = RTC_getTimeDate

[Called By]

- >> scheduler
- >> GPS_subroutine

RTC_initAlarm (Thumb, 96 bytes, Stack size 8 bytes, timers.o(.text.RTC_initAlarm))

[Stack]

- Max Depth = 8
- Call Chain = RTC_initAlarm

[Called By]

- >> main

RTC_setTimeDate (Thumb, 40 bytes, Stack size 32 bytes, timers.o(.text.RTC_setTimeDate))

[Stack]

- Max Depth = 96
- Call Chain = RTC_setTimeDate ⇒ LL_RTC_TIME_Init ⇒ LL_RTC_WaitForSynchro

[Calls]

- >> LL_RTC_TIME_Init
- >> LL_RTC_DATE_Init

[Called By]

- >> GPS_subroutine

SPI1_IRQHandler (Thumb, 2 bytes, Stack size 0 bytes, stm32l0xx_it.o(.text.SPI1_IRQHandler))
[Address Reference Count : 1]

- startup_stm32l071xx.o(RESET)

SVC_Handler (Thumb, 2 bytes, Stack size 0 bytes, stm32l0xx_it.o(.text.SVC_Handler))
[Address Reference Count : 1]

- startup_stm32l071xx.o(RESET)

SysTick_Handler (Thumb, 2 bytes, Stack size 0 bytes, stm32l0xx_it.o(.text.SysTick_Handler))
[Address Reference Count : 1]

- startup_stm32l071xx.o(RESET)

SystemClock_Config (Thumb, 220 bytes, Stack size 24 bytes, main.o(.text.SystemClock_Config))

[Stack]

- Max Depth = 44
- Call Chain = SystemClock_Config ⇒ LL_Init1msTick ⇒ __aeabi_uidiv

[Calls]

- >> LL_SetSystemCoreClock
- >> LL_Init1msTick

[Called By]

- >> main

SystemInit (Thumb, 80 bytes, Stack size 0 bytes, system_stm32l0xx.o(.text.SystemInit))
[Address Reference Count : 1]

- startup_stm32l071xx.o(.text)

TIM2_IRQHandler (Thumb, 2 bytes, Stack size 0 bytes, stm32l0xx_it.o(.text.TIM2_IRQHandler))
[Address Reference Count : 1]

- startup_stm32l071xx.o(RESET)

TIM2_delay (Thumb, 28 bytes, Stack size 0 bytes, timers.o(.text.TIM2_delay))

[Called By]

- >> XB_EnableXbee
- >> GPS_subroutine
- >> main

TIM2_init (Thumb, 32 bytes, Stack size 0 bytes, timers.o(.text.TIM2_init))

[Called By]

- >> main

TIM2_initDelay_inline (Thumb, 20 bytes, Stack size 0 bytes, timers.o(.text.TIM2_initDelay_inline))

[Called By]

- >> GPS_subroutine
- >> CC_SetRTC
- >> CC_SetProgram
- >> CC_ConfigureXbee

USART1_IRQHandler (Thumb, 60 bytes, Stack size 0 bytes, stm32l0xx_it.o(.text.USART1_IRQHandler))
[Address Reference Count : 1]

- startup_stm32l071xx.o(RESET)

USART4_5_IRQHandler (Thumb, 52 bytes, Stack size 0 bytes, stm32l0xx_it.o(.text.USART4_5_IRQHandler))
[Address Reference Count : 1]

- startup_stm32l071xx.o(RESET)

VHF_DisableVHF (Thumb, 16 bytes, Stack size 0 bytes, xbee.o(.text.VHF_DisableVHF))

[Called By]

- >> main
- >> LPM_stop

VHF_EnableVHF (Thumb, 16 bytes, Stack size 0 bytes, xbee.o(.text.VHF_EnableVHF))

[Called By]

- >> main

XB_CheckForDongle (Thumb, 88 bytes, Stack size 16 bytes, xbee.o(.text.XB_CheckForDongle))

[Stack]

- Max Depth = 16
- Call Chain = XB_CheckForDongle

[Called By]

- >> XB_XbeeSubroutine

XB_ConfigureDevice (Thumb, 508 bytes, Stack size 88 bytes, xbee.o(.text.XB_ConfigureDevice))

[Stack]

- Max Depth = 96
- Call Chain = XB_ConfigureDevice ⇒ XB_EnableXbee

[Calls]

- >> XB_EnableXbee
- >> strlen
- >> __aeabi_memclr
- >> __aeabi_memcpy

[Called By]

- >> CC_ConfigureXbee

XB_DisableXbee (Thumb, 16 bytes, Stack size 0 bytes, xbee.o(.text.XB_DisableXbee))

[Called By]

- >> main
- >> LPM_stop

XB_EnableXbee (Thumb, 24 bytes, Stack size 8 bytes, xbee.o(.text.XB_EnableXbee))

[Stack]

- Max Depth = 8
- Call Chain = XB_EnableXbee

[Calls]

- >> TIM2_delay

[Called By]

- >> XB_XbeeSubroutine
- >> XB_GetSN
- >> XB_GetConfig
- >> XB_ConfigureDevice

XB_ExecuteCommand (Thumb, 20 bytes, Stack size 8 bytes, xbee.o(.text.XB_ExecuteCommand))

[Stack]

- Max Depth = 136
- Call Chain = XB_ExecuteCommand ⇒ XB_TransmitFixes ⇒ FLASH_readFixes ⇒ FLASH_ReadData

[Calls]

- >> XB_TransmitFixes

[Called By]

- >> XB_XbeeSubroutine

XB_GetConfig (Thumb, 152 bytes, Stack size 80 bytes, xbee.o(.text.XB_GetConfig))

[Stack]

- Max Depth = 88
- Call Chain = XB_GetConfig ⇒ XB_EnableXbee

[Calls]

- >> XB_SendByte
- >> XB_EnableXbee
- >> __aeabi_memclr4

[Called By]

- >> CC_ExecuteCommand

XB_GetResponse (Thumb, 144 bytes, Stack size 24 bytes, xbee.o(.text.XB_GetResponse))

[Stack]

- Max Depth = 24
- Call Chain = XB_GetResponse

[Calls]

- >> strlen

[Address Reference Count : 2]

- xbee.o(.text.XB_ConfigureDevice)
- xbee.o(.text.XB_GetSN)

XB_GetSN (Thumb, 160 bytes, Stack size 80 bytes, xbee.o(.text.XB_GetSN))

[Stack]

- Max Depth = 88
- Call Chain = XB_GetSN ⇒ XB_EnableXbee

[Calls]

- >> XB_SendByte
- >> XB_EnableXbee
- >> __aeabi_memclr4

[Called By]

- >> CC_ExecuteCommand

XB_ParseCommand (Thumb, 120 bytes, Stack size 72 bytes, xbee.o(.text.XB_ParseCommand))

[Stack]

- Max Depth = 84
- Call Chain = XB_ParseCommand ⇒ memcmp

[Calls]

- >> memcmp
- >> __aeabi_memclr4

[Called By]

- >> XB_XbeeSubroutine

XB_SendByte (Thumb, 20 bytes, Stack size 0 bytes, xbee.o(.text.XB_SendByte))

[Called By]

- >> XB_TransmitFixes
- >> XB_SendData
- >> XB_GetSN
- >> XB_GetConfig

[Address Reference Count : 2]

- xbee.o(.text.XB_ConfigureDevice)
- xbee.o(.text.XB_TransmitFixes)

XB_SendData (Thumb, 26 bytes, Stack size 16 bytes, xbee.o(.text.XB_SendData))

[Stack]

- Max Depth = 16
- Call Chain = XB_SendData

[Calls]

- >> XB_SendByte

[Address Reference Count : 3]

- xbee.o(.text.XB_ConfigureDevice)
- xbee.o(.text.XB_GetSN)
- xbee.o(.text.XB_TransmitFixes)

XB_TransmitFixes (Thumb, 216 bytes, Stack size 96 bytes, xbee.o(.text.XB_TransmitFixes))

[Stack]

- Max Depth = 128
- Call Chain = XB_TransmitFixes ⇒ FLASH_readFixes ⇒ FLASH_ReadData

[Calls]

- >> XB_SendByte
- >> FLASH_readFixes
- >> __aeabi_memclr4

[Called By]

- >> XB_ExecuteCommand

XB_XbeeSubroutine (Thumb, 136 bytes, Stack size 24 bytes, xbee.o(.text.XB_XbeeSubroutine))

[Stack]

- Max Depth = 160
- Call Chain = XB_XbeeSubroutine ⇒ XB_ExecuteCommand ⇒ XB_TransmitFixes ⇒ FLASH_readFixes ⇒ FLASH_ReadData

[Calls]

- >> XB_ParseCommand
- >> XB_ExecuteCommand
- >> XB_EnableXbee
- >> XB_CheckForDongle

[Called By]

- >> main

main (Thumb, 1144 bytes, Stack size 120 bytes, main.o(.text.main))

[Stack]

- Max Depth = 600
- Call Chain = main ⇒ GPS_subroutine ⇒ GPS_getNMEA ⇒ atoi ⇒ strtol ⇒ _strtoul

[Calls]

- >> XB_XbeeSubroutine
- >> XB_DisableXbee
- >> VHF_EnableVHF
- >> VHF_DisableVHF
- >> TIM2_init
- >> RTC_initAlarm
- >> scheduler
- >> TIM2_delay
- >> GPS_subroutine
- >> GPS_GPSDisable
- >> GPS_GPSCSHigh
- >> LL_RTC_TIME_Init
- >> LL_RTC_DATE_Init
- >> CC_ParseCommand
- >> CC_ExecuteCommand
- >> CC_ComPortPresent
- >> CC_CheckForHandshake
- >> SystemClock_Config
- >> LPM_stop
- >> LPM_gpioInit
- >> LL_USART_Init
- >> LL_TIM_Init
- >> LL_SPI_Init
- >> LL_RTC_Init
- >> LL_IOP_GRP1_EnableClock
- >> LL_APB2_GRP1_EnableClock
- >> LL_APB1_GRP1_EnableClock

[Address Reference Count : 1]

- entry9a.o(.ARM.Collect$$$$0000000B)

scheduler (Thumb, 244 bytes, Stack size 72 bytes, scheduler.o(.text.scheduler))

[Stack]

- Max Depth = 80
- Call Chain = scheduler ⇒ RTC_getTimeDate

[Calls]

- >> RTC_getTimeDate
- >> EEPROM_WriteByte
- >> FLASH_Unlock
- >> FLASH_ReadData
- >> FLASH_Lock

[Called By]

- >> main

__0sprintf$5 (Thumb, 36 bytes, Stack size 24 bytes, printf5.o(i.__0sprintf$5), UNUSED)

[Calls]

- >> _sputc
- >> _printf_core

__1sprintf$5 (Thumb, 0 bytes, Stack size 24 bytes, printf5.o(i.__0sprintf$5), UNUSED)

__2sprintf (Thumb, 0 bytes, Stack size 24 bytes, printf5.o(i.__0sprintf$5))

[Stack]

- Max Depth = 24
- Call Chain = __2sprintf

[Called By]

- >> CC_SetRTC
- >> CC_SendTimestamp

__aeabi_errno_addr (Thumb, 4 bytes, Stack size 0 bytes, errno.o(i.__aeabi_errno_addr))

[Called By]

- >> _strtoul
- >> strtol
- >> atoi

__rt_errno_addr (Thumb, 0 bytes, Stack size 0 bytes, errno.o(i.__aeabi_errno_addr), UNUSED)

__scatterload_copy (Thumb, 14 bytes, Stack size unknown bytes, handlers.o(i.__scatterload_copy), UNUSED)

__scatterload_null (Thumb, 2 bytes, Stack size unknown bytes, handlers.o(i.__scatterload_null), UNUSED)

__scatterload_zeroinit (Thumb, 14 bytes, Stack size unknown bytes, handlers.o(i.__scatterload_zeroinit), UNUSED)

### Local Symbols

LL_APB1_GRP1_EnableClock (Thumb, 28 bytes, Stack size 4 bytes, main.o(.text.LL_APB1_GRP1_EnableClock))

[Stack]

- Max Depth = 4
- Call Chain = LL_APB1_GRP1_EnableClock

[Called By]

- >> main

LL_APB2_GRP1_EnableClock (Thumb, 28 bytes, Stack size 4 bytes, main.o(.text.LL_APB2_GRP1_EnableClock))

[Stack]

- Max Depth = 4
- Call Chain = LL_APB2_GRP1_EnableClock

[Called By]

- >> main

LL_IOP_GRP1_EnableClock (Thumb, 28 bytes, Stack size 4 bytes, main.o(.text.LL_IOP_GRP1_EnableClock))

[Stack]

- Max Depth = 4
- Call Chain = LL_IOP_GRP1_EnableClock

[Called By]

- >> main

[Address Reference Count : 1]

- main.o(.text.main)

NVIC_SystemReset (Thumb, 28 bytes, Stack size 0 bytes, stm32l0xx_it.o(.text.NVIC_SystemReset))

[Called By]

- >> HardFault_Handler

LL_RTC_DATE_Config (Thumb, 40 bytes, Stack size 16 bytes, stm32l0xx_ll_rtc.o(.text.LL_RTC_DATE_Config))

[Stack]

- Max Depth = 16
- Call Chain = LL_RTC_DATE_Config

[Called By]

- >> LL_RTC_DATE_Init

LL_RTC_TIME_Config (Thumb, 36 bytes, Stack size 16 bytes, stm32l0xx_ll_rtc.o(.text.LL_RTC_TIME_Config))

[Stack]

- Max Depth = 16
- Call Chain = LL_RTC_TIME_Config

[Called By]

- >> LL_RTC_TIME_Init

_printf_core (Thumb, 688 bytes, Stack size 96 bytes, printf5.o(i._printf_core), UNUSED)

[Calls]

- >> __aeabi_uldivmod

[Called By]

- >> __0sprintf$5

_sputc (Thumb, 10 bytes, Stack size 0 bytes, printf5.o(i._sputc))

[Called By]

- >> __0sprintf$5

[Address Reference Count : 1]

- printf5.o(i.__0sprintf$5)

### Undefined Global Symbols
