EmbeddedSystemClass/2019-Animal-Collars/COLLAR STRAP_PDF/COLLAR STRAP_V3/ANTENNA_STRAP 001_V3_ManualCut.PDF

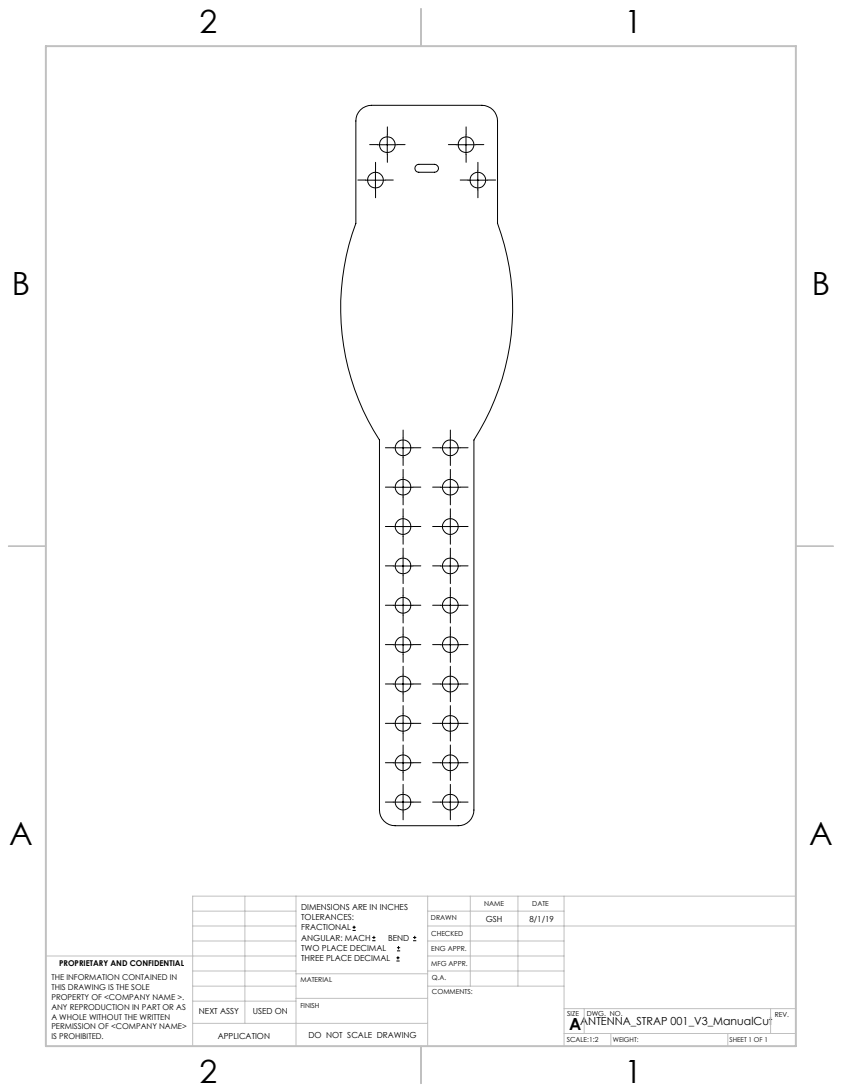
[picture p49: page 1]

TOLERANCES: FRACTIONAL ANGULAR: MACH BEND TWO PLACE DECIMAL THREE PLACE DECIMAL | | NAME | DATE DIMENSIONS ARE IN INCHES

DRAWN | GSH | 8/1/19
CHECKED
ENG APPR.

PROPRIETARY AND CONFIDENTIAL THE INFORMATION CONTAINED IN THIS DRAWING IS THE SOLE PROPERTY OF <COMPANY NAME >. ANY REPRODUCTION IN PART OR AS A WHOLE WITHOUT THE WRITTEN PERMISSION OF <COMPANY NAME> IS PROHIBITED. | | | MFG APPR.

MATERIAL | Q.A.

NEXT ASSY | USED ON | FINISH

SIZE A ANTENNA_STRAP 001_V3_ManualCut | DWG. NO. | REV.

APPLICATION | | DO NOT SCALE DRAWING

SCALE:1:2 | WEIGHT: | SHEET 1 OF 1
