EmbeddedSystemClass/2019-Animal-Collars/Electrical Source/Hardware/Fabrication Files/Large Collar/largeCollar_AA_schematics.pdf

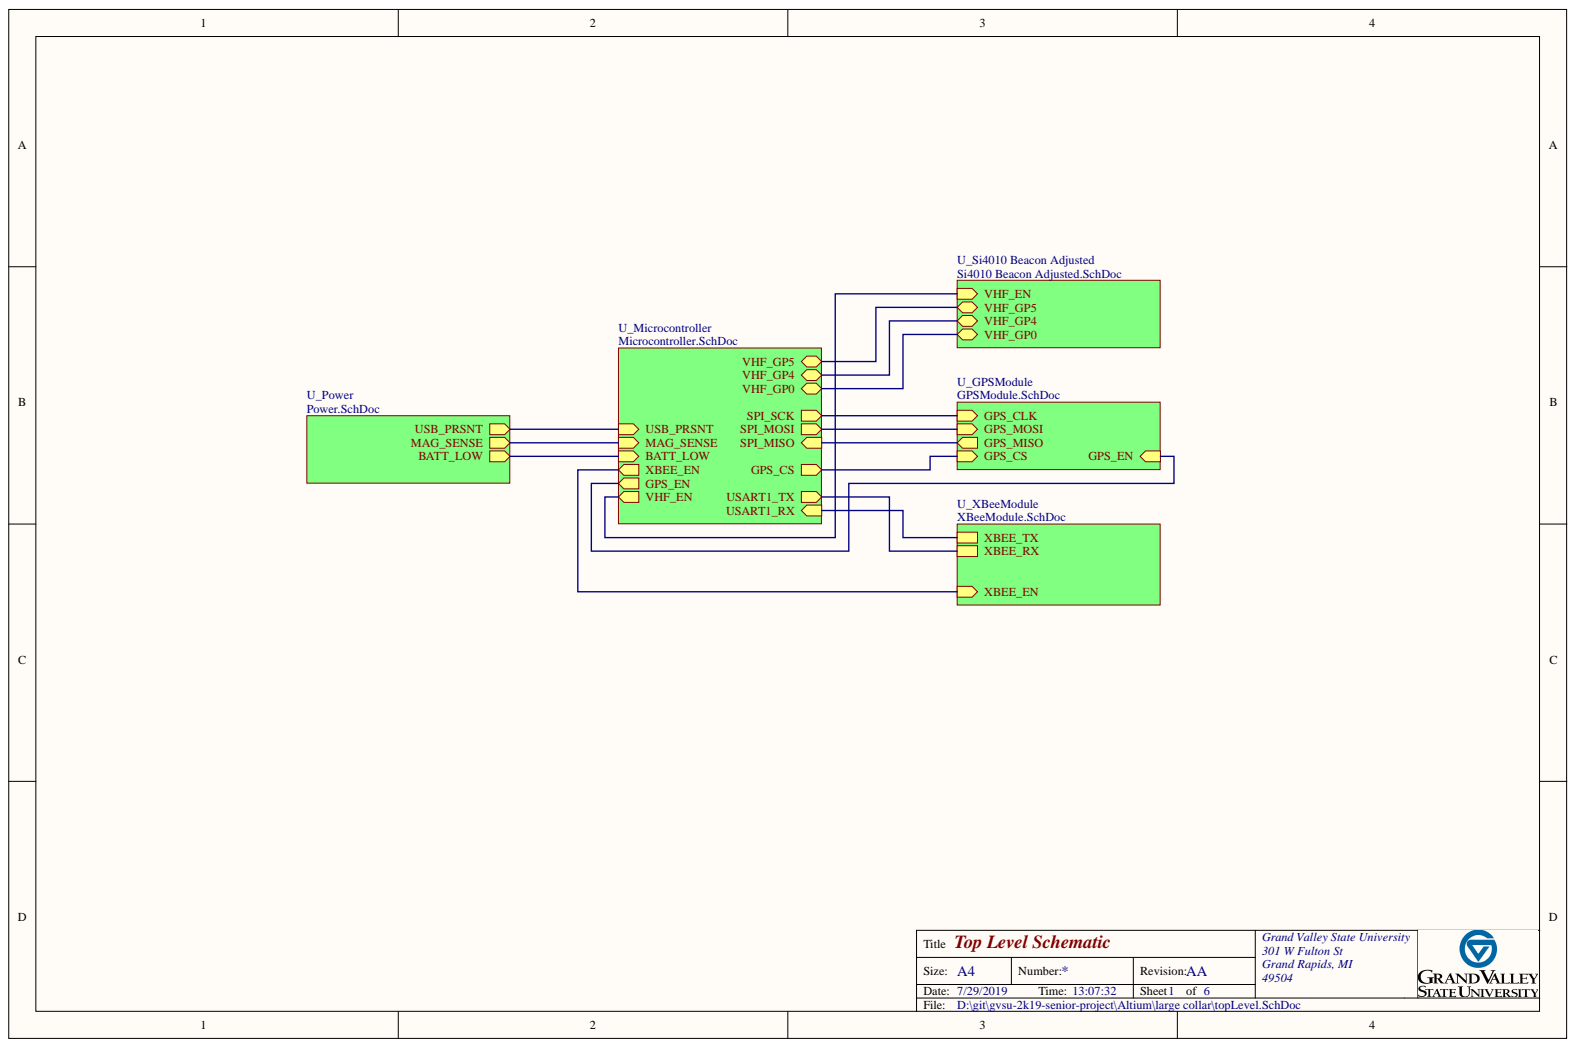
[picture p51: page 1]

Top Level Schematic Title | Grand Valley State University 301 W Fulton St Grand Rapids, MI 49504

A4 Size: | * Number: | AA Revision:

Date: 7/29/2019 Time: 13:07:32 | | Sheet 1 of 6
File: D:\git\gvsu-2k19-senior-project\Altium\large collar\topLevel.SchDoc

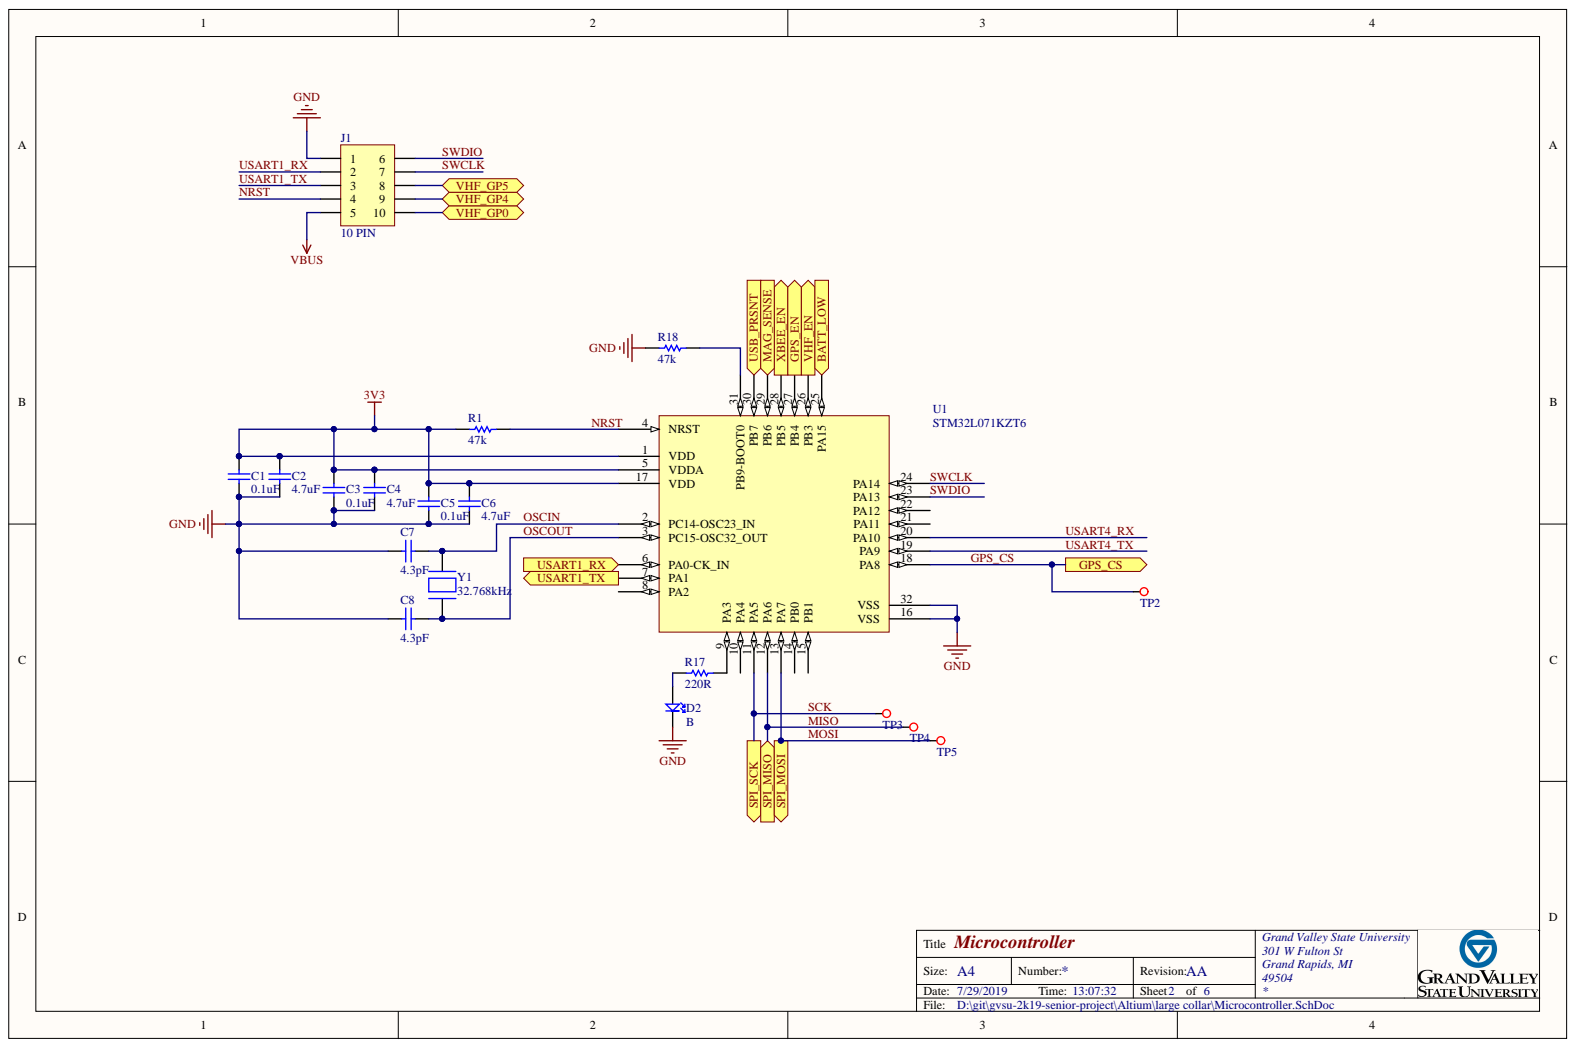
[picture p52: page 2]

47k | VDD 1

VDDA 5
VDD 17

OSCOUT | PC15-OSC32_OUT 3

Microcontroller Title | Grand Valley State University 301 W Fulton St Grand Rapids, MI 49504 *

A4 Size: | * Number: | AA Revision:

Date: 7/29/2019 Time: 13:07:32 | | Sheet 2 of 6
File: D:\git\gvsu-2k19-senior-project\Altium\large collar\Microcontroller.SchDoc

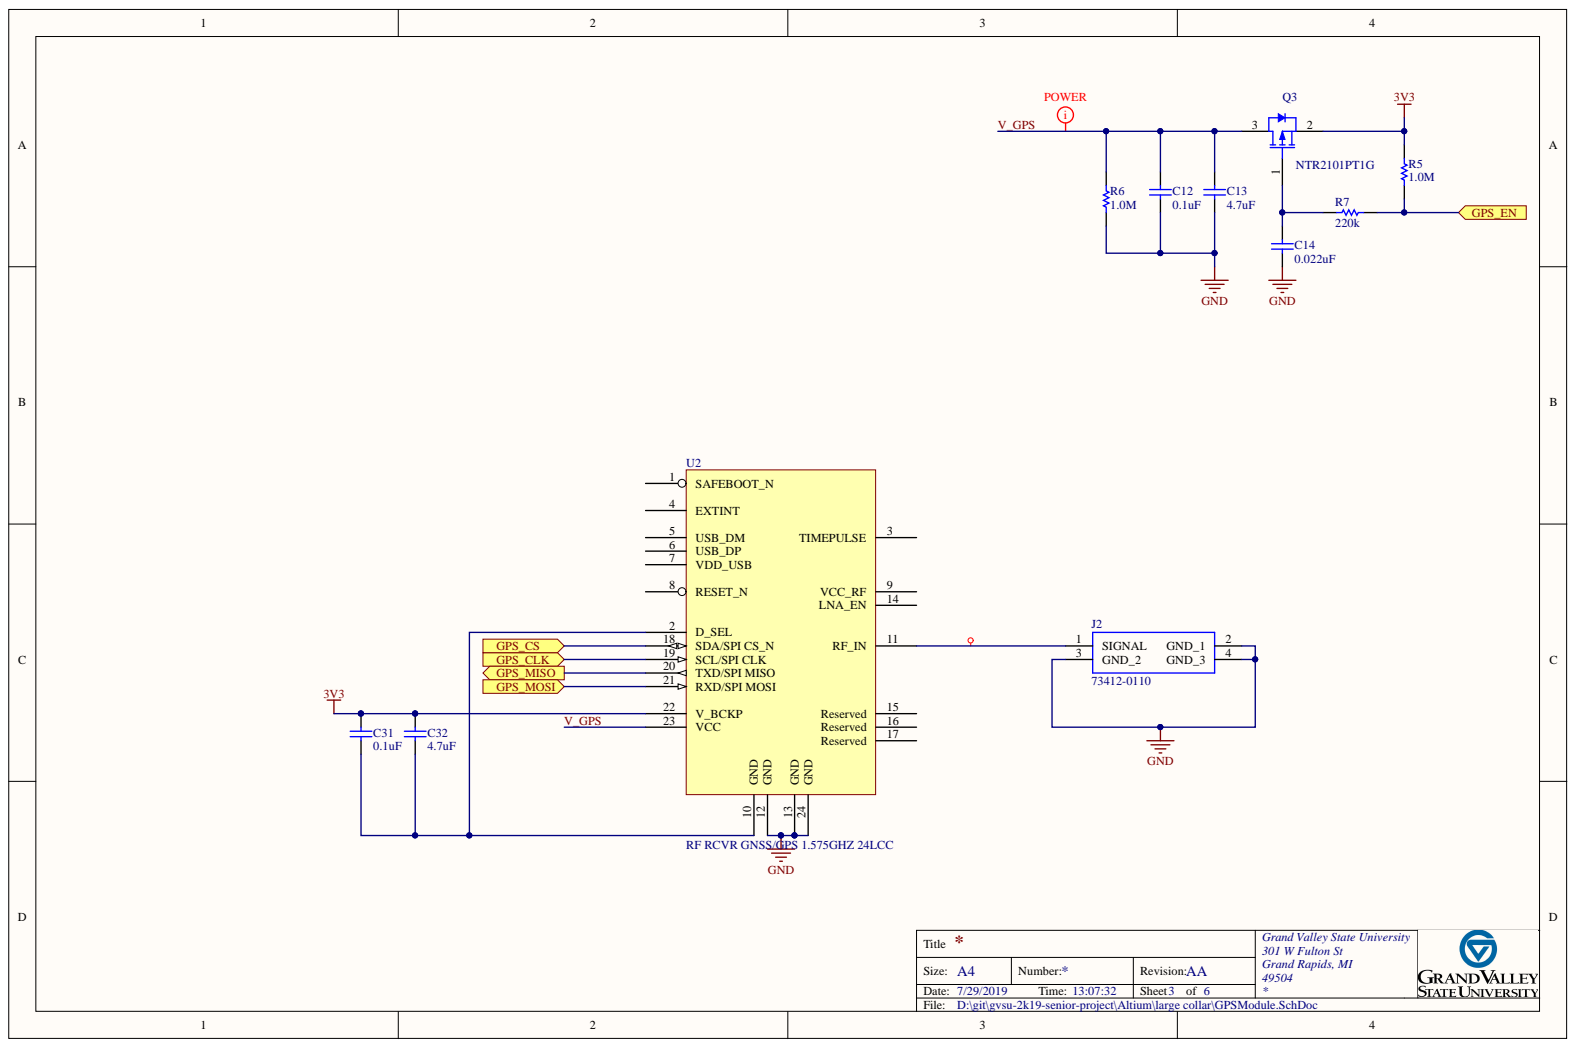
[picture p53: page 3]

RF RCVR GNSS/GPS 1.575GHZ 24LCC

* Title | Grand Valley State University 301 W Fulton St Grand Rapids, MI 49504 *

A4 Size: | * Number: | AA Revision:

Date: 7/29/2019 Time: 13:07:32 | | Sheet 3 of 6
File: D:\git\gvsu-2k19-senior-project\Altium\large collar\GPSModule.SchDoc

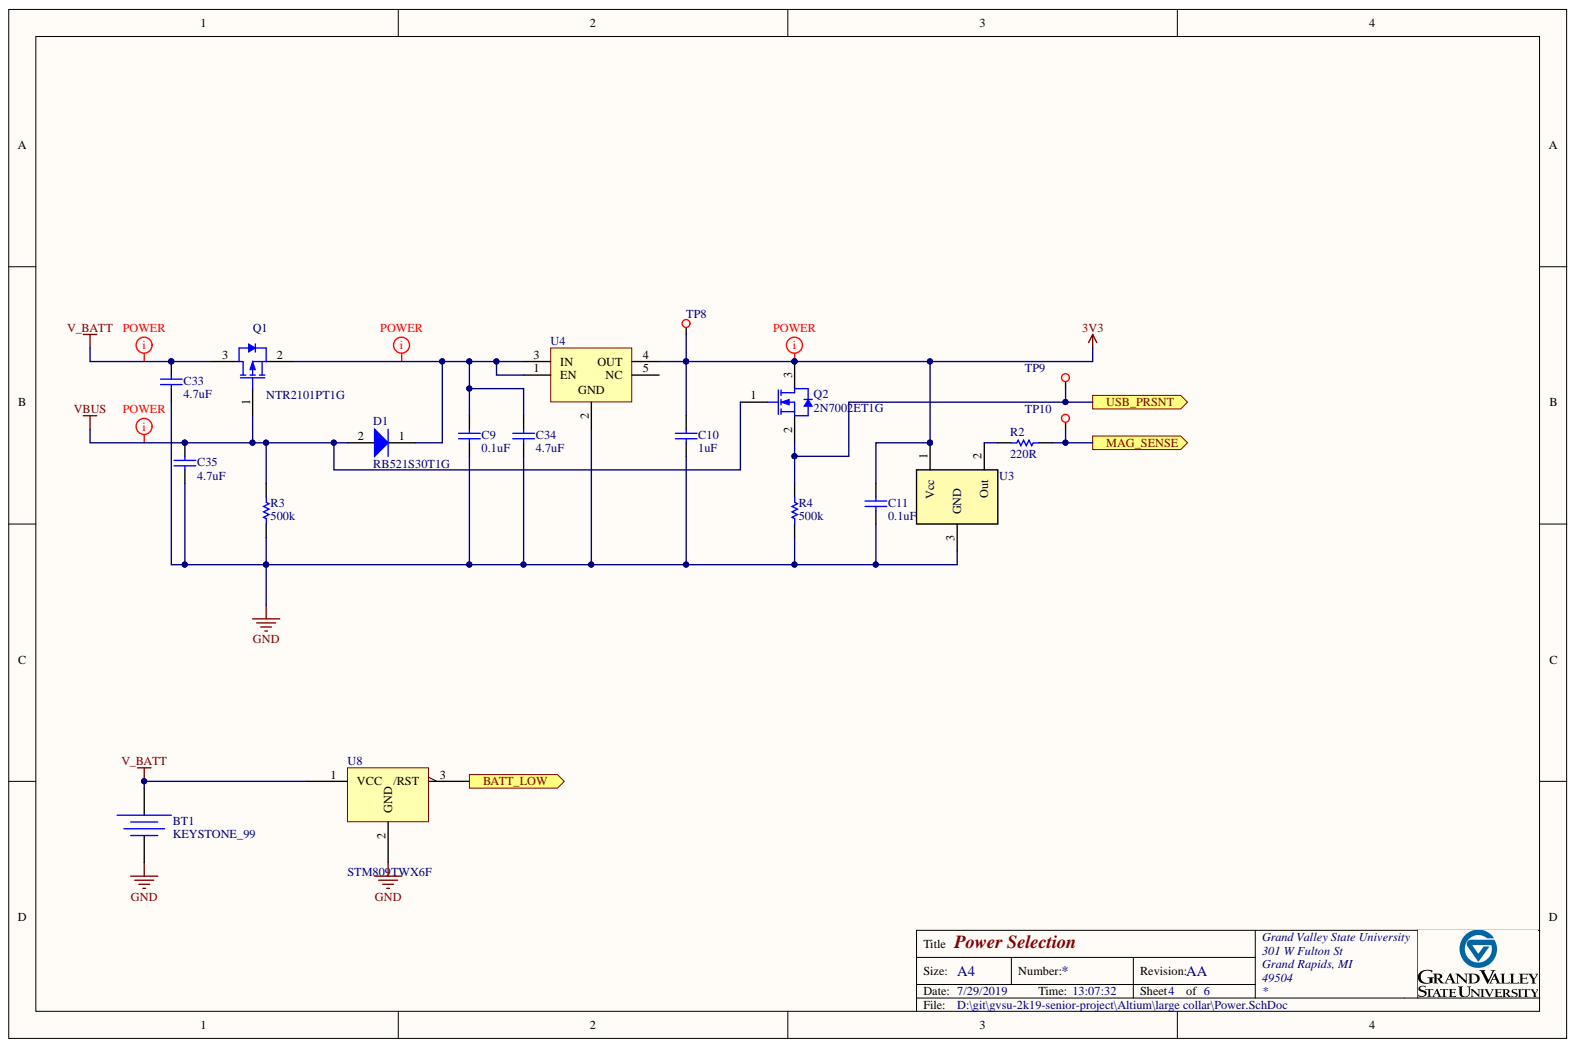
[picture p54: page 4]

Power Selection Title | Grand Valley State University 301 W Fulton St Grand Rapids, MI 49504 *

A4 Size: | * Number: | AA Revision:

Date: 7/29/2019 Time: 13:07:32 | | Sheet 4 of 6
File: D:\git\gvsu-2k19-senior-project\Altium\large collar\Power.SchDoc

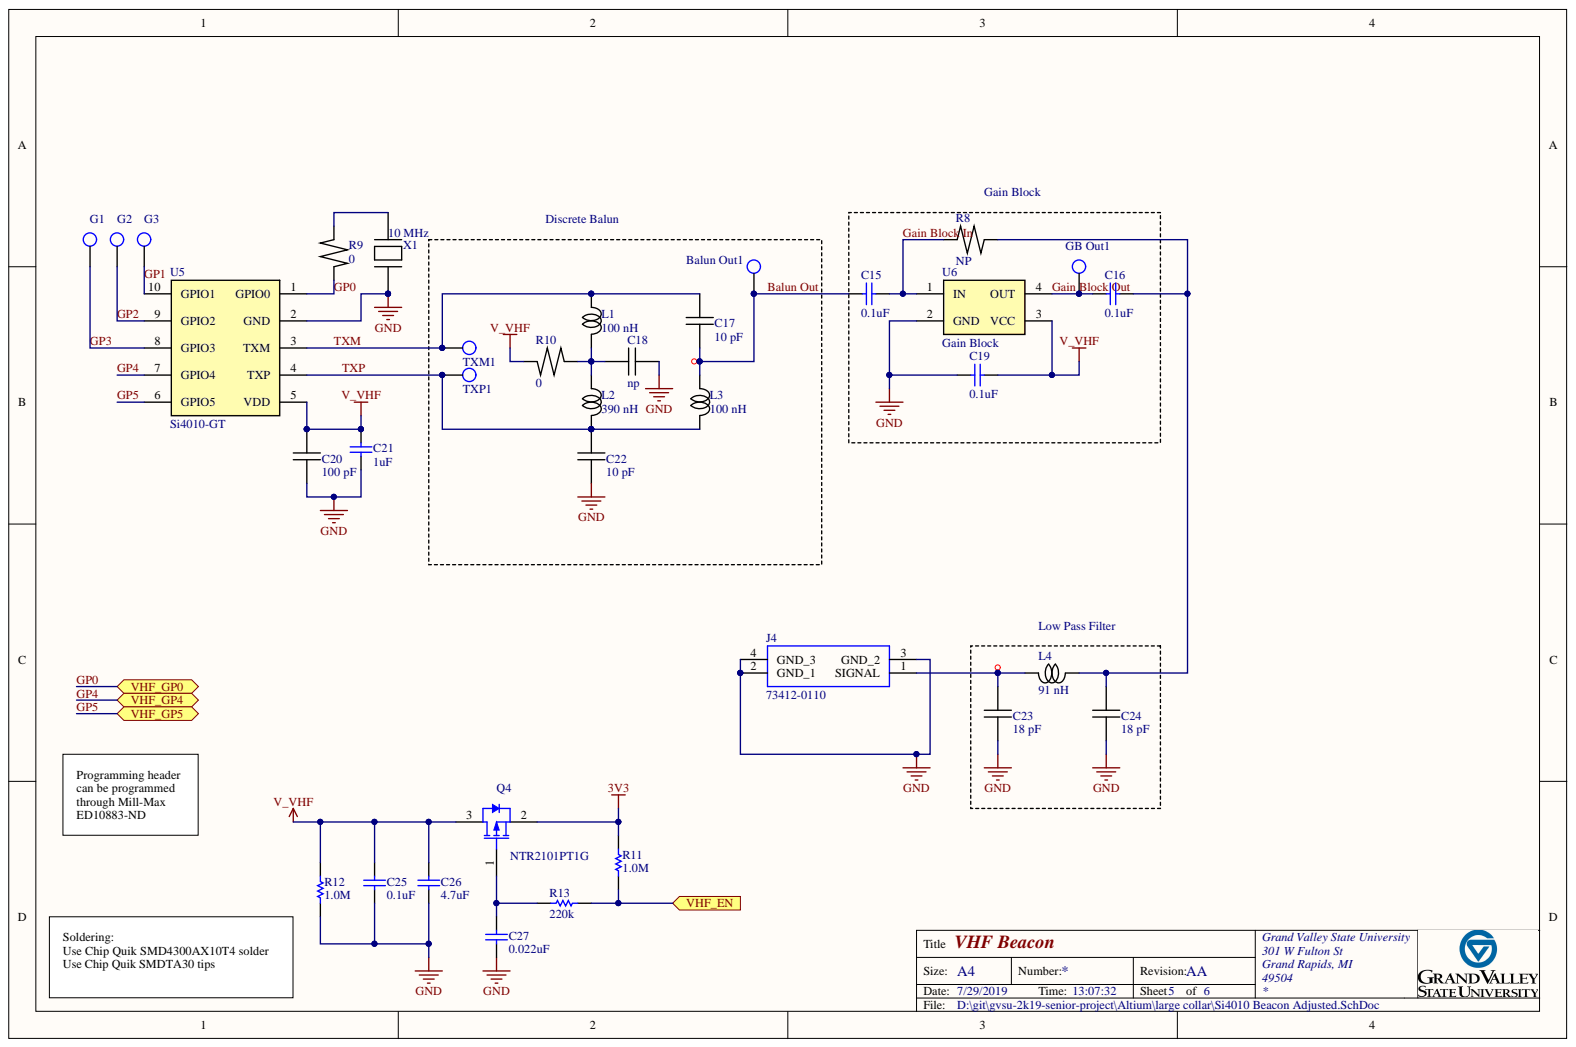
[picture p55: page 5]

Soldering:
Use Chip Quik SMD4300AX10T4 solder
Use Chip Quik SMDTA30 tips

VHF Beacon Title | Grand Valley State University 301 W Fulton St Grand Rapids, MI 49504 *

A4 Size: | * Number: | AA Revision:

Date: 7/29/2019 Time: 13:07:32 | | Sheet 5 of 6
File: D:\git\gvsu-2k19-senior-project\Altium\large collar\Si4010 Beacon Adjusted.SchDoc

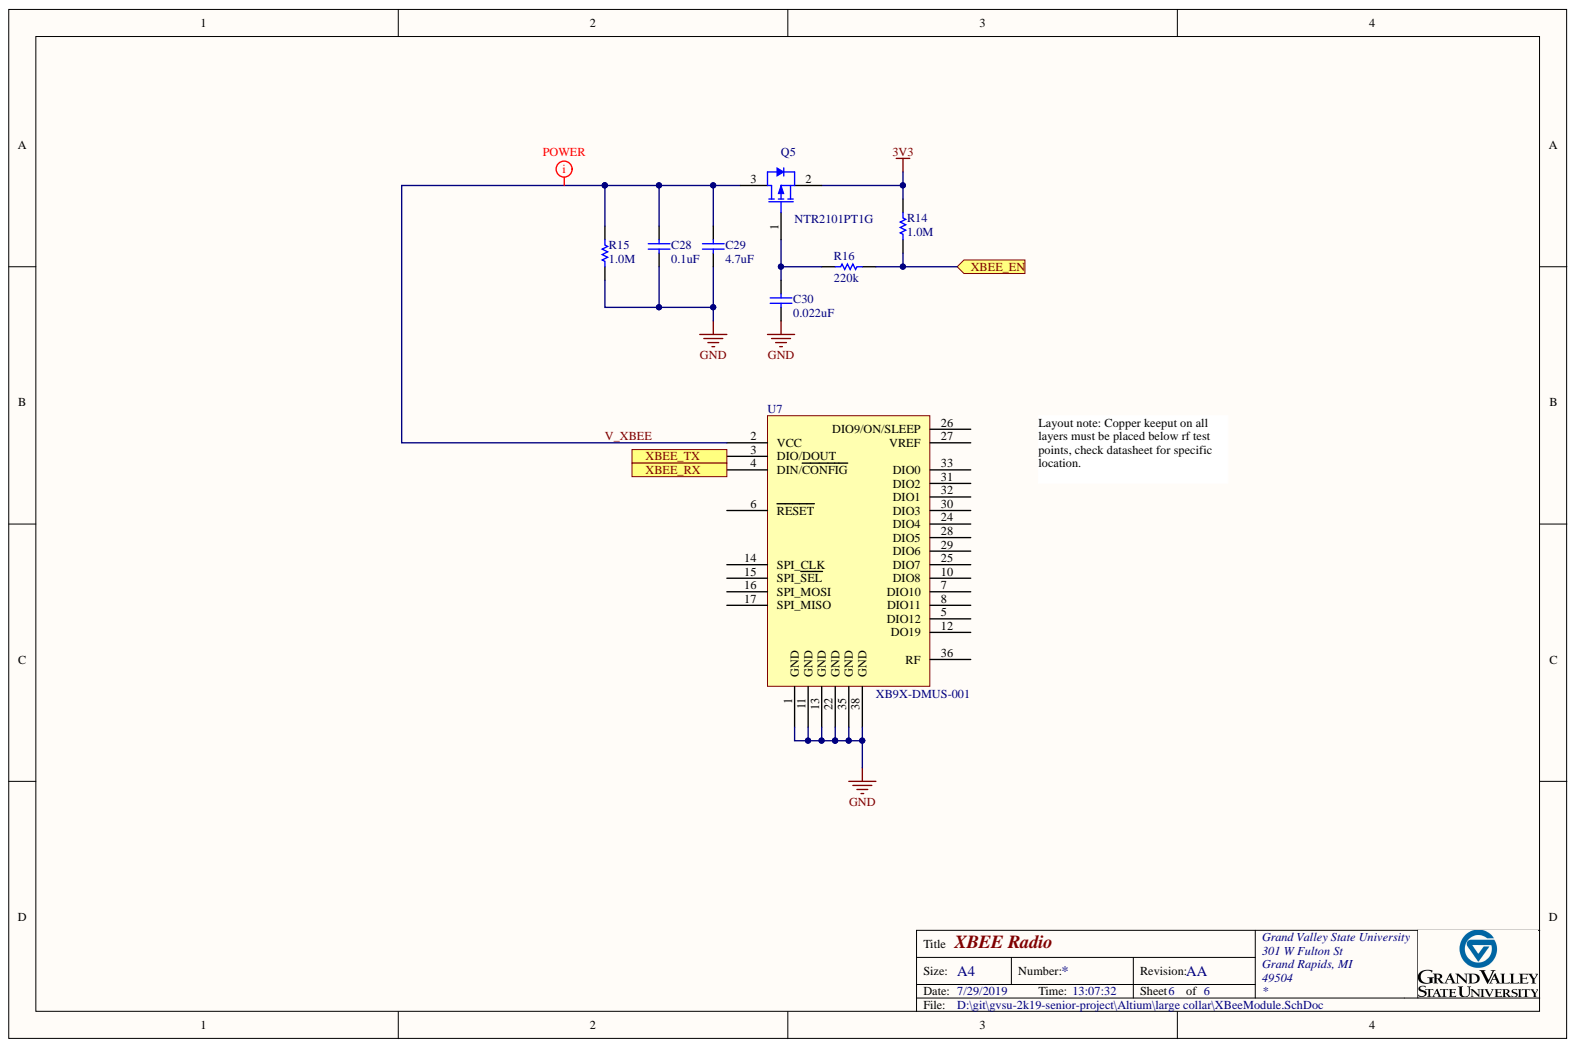
[picture p56: page 6]

Layout note: Copper keeput on all
layers must be placed below rf test
points, check datasheet for specific
location.

XBEE Radio Title | Grand Valley State University 301 W Fulton St Grand Rapids, MI 49504 *

A4 Size: | * Number: | AA Revision:

Date: 7/29/2019 Time: 13:07:32 | | Sheet 6 of 6
File: D:\git\gvsu-2k19-senior-project\Altium\large collar\XBeeModule.SchDoc
