EmbeddedSystemClass/2019-Animal-Collars/Documentation/PDF/2019_Animal_Collar_Assm.PDF

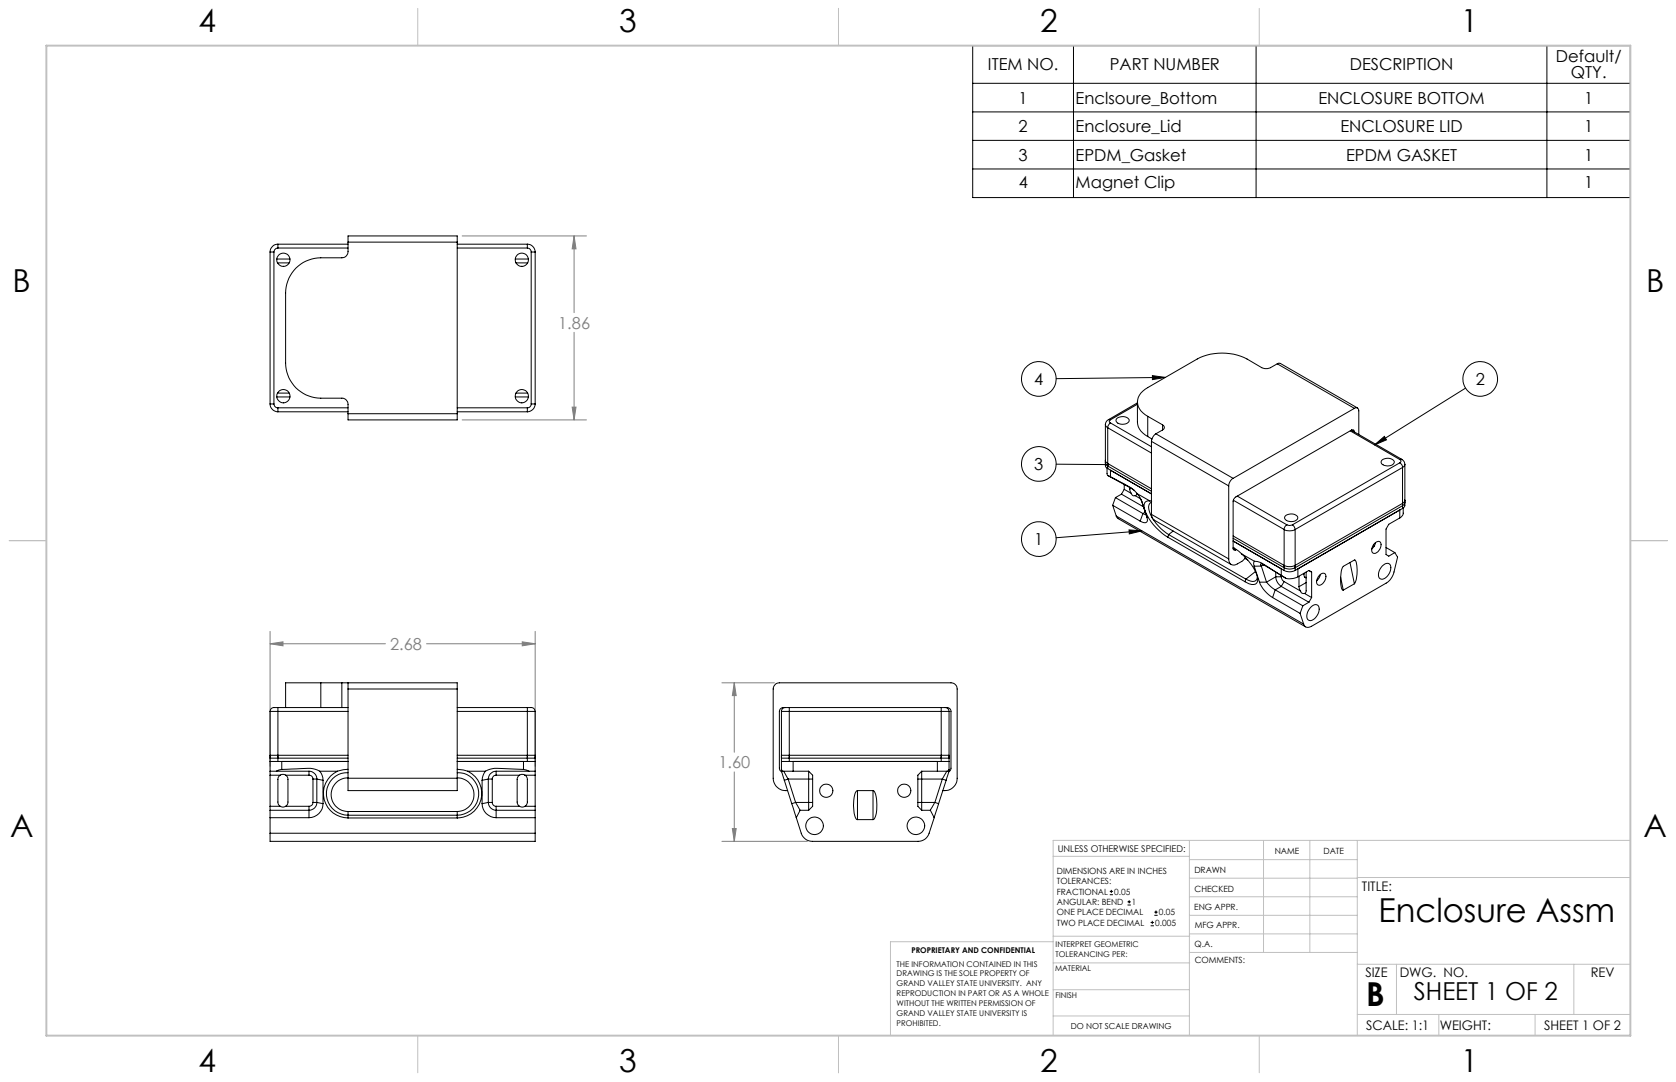
[picture p57: page 1]
SHEET 1 OF 2; SCALE: 1:1; WEIGHT:; DWG. NO.; REV

ITEM NO. | PART NUMBER | DESCRIPTION | Default/ QTY.
1 | Enclsoure_Bottom | ENCLOSURE BOTTOM | 1
2 | Enclosure_Lid | ENCLOSURE LID | 1
3 | EPDM_Gasket | EPDM GASKET | 1
4 | Magnet Clip | | 1

UNLESS OTHERWISE SPECIFIED: | | NAME | DATE
DIMENSIONS ARE IN INCHES TOLERANCES: FRACTIONAL 0.05 ANGULAR: BEND 1 ONE PLACE DECIMAL 0.05 TWO PLACE DECIMAL 0.005 | DRAWN

CHECKED | | | TITLE: Enclosure Assm

ENG APPR.
MFG APPR.

PROPRIETARY AND CONFIDENTIAL
THE INFORMATION CONTAINED IN THIS
DRAWING IS THE SOLE PROPERTY OF
GRAND VALLEY STATE UNIVERSITY. ANY
REPRODUCTION IN PART OR AS A WHOLE
WITHOUT THE WRITTEN PERMISSION OF
GRAND VALLEY STATE UNIVERSITY IS
PROHIBITED.

INTERPRET GEOMETRIC TOLERANCING PER: | Q.A.

DO NOT SCALE DRAWING

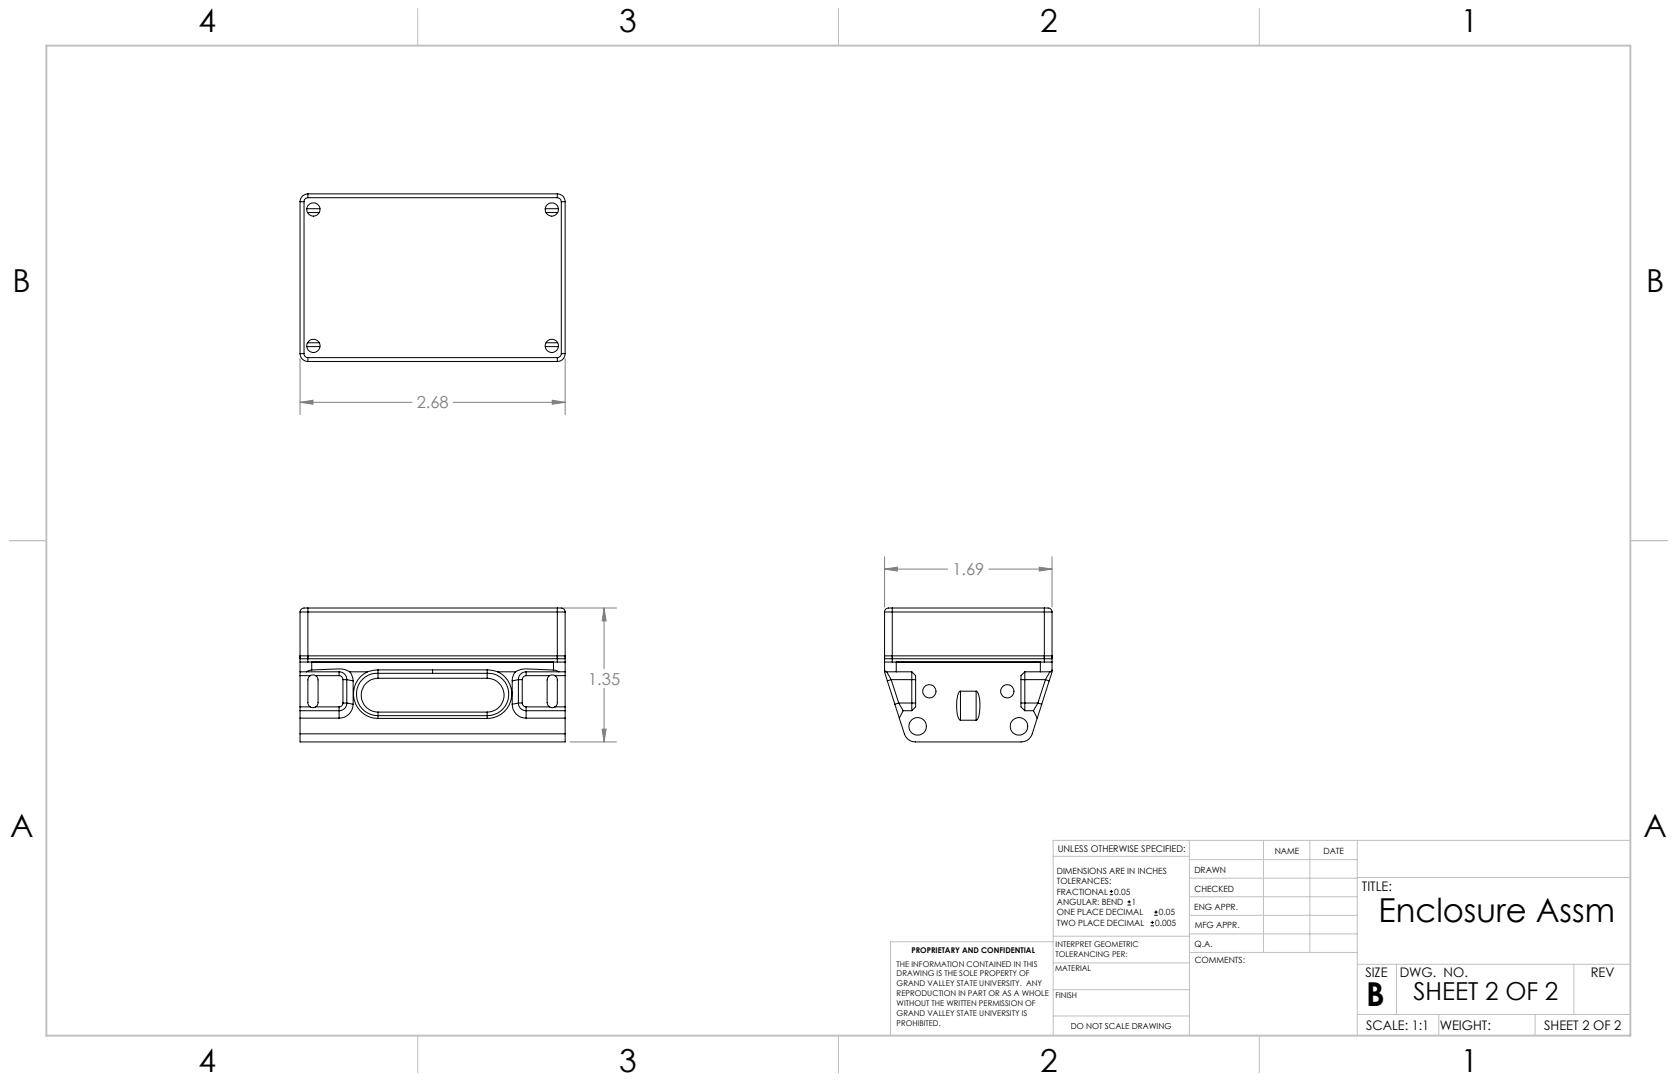
[picture p58: page 2]
SHEET 2 OF 2; SCALE: 1:1; WEIGHT:; DWG. NO.; REV

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

CHECKED | | | TITLE: Enclosure Assm

ENG APPR.
MFG APPR.

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

INTERPRET GEOMETRIC TOLERANCING PER: | Q.A.

DO NOT SCALE DRAWING
