EmbeddedSystemClass/2019-Animal-Collars/Documentation/PDF/Enclsoure_Bottom.PDF

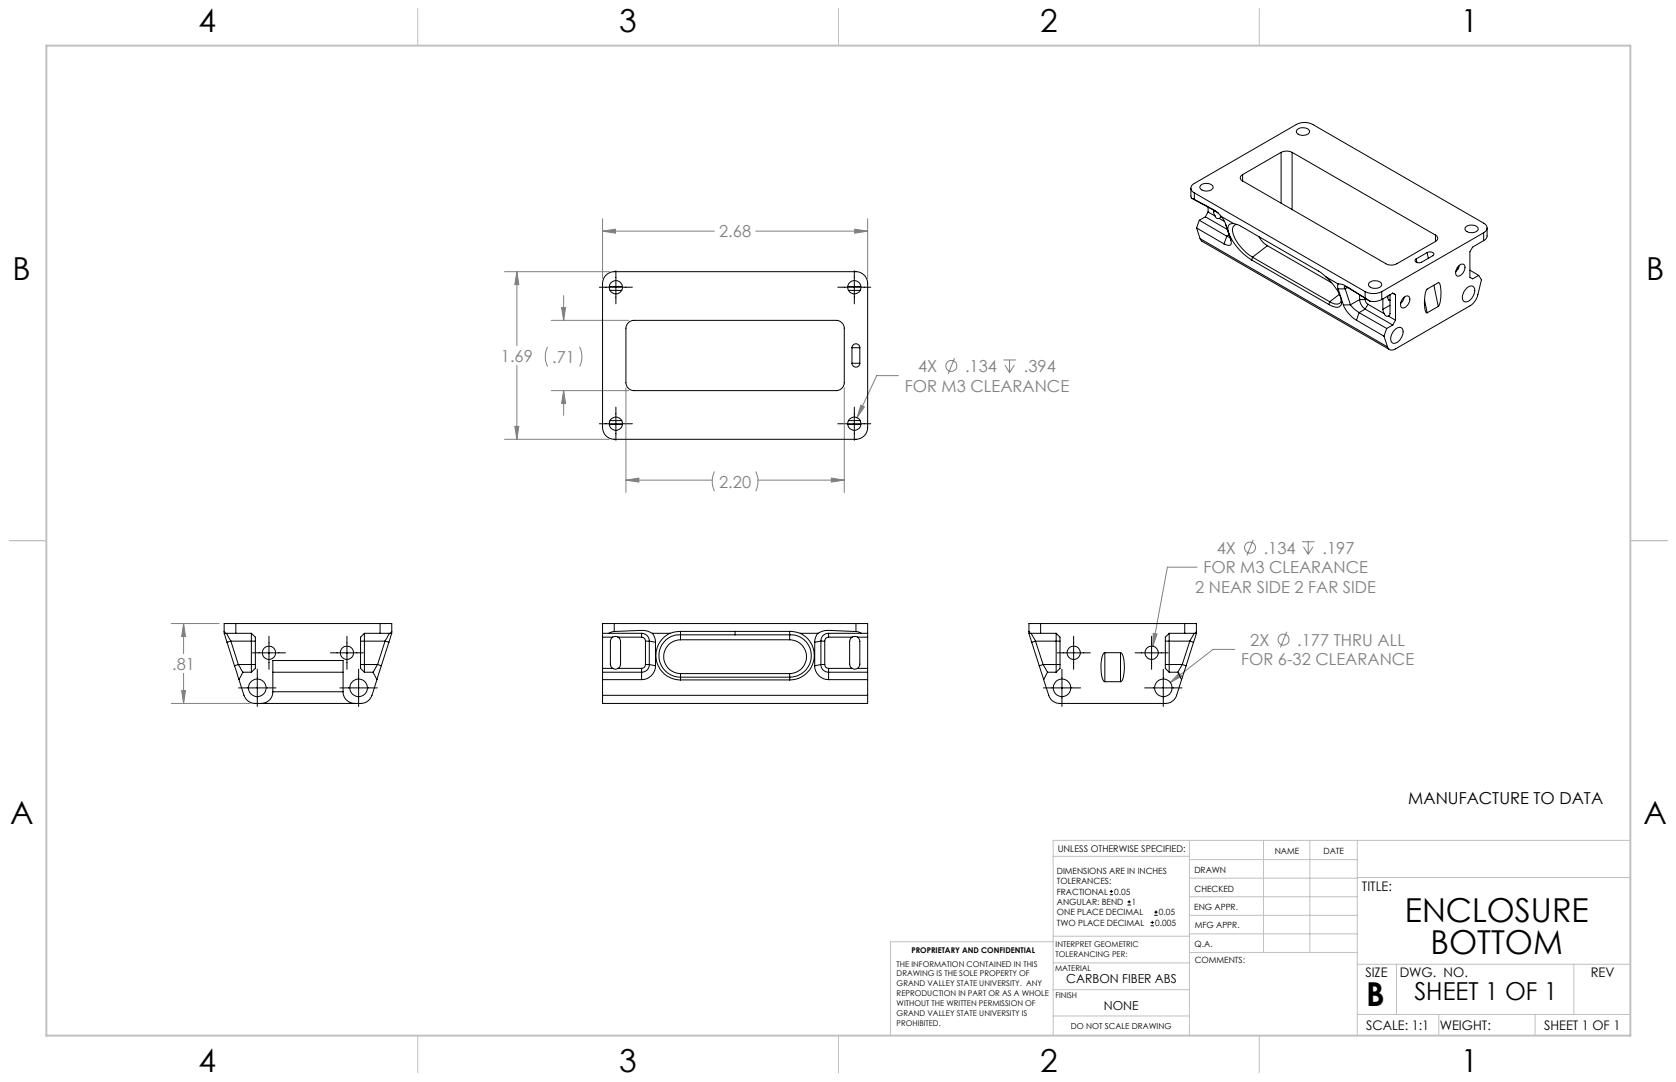
[picture p59: page 1]
FOR M3 CLEARANCE; .177 THRU ALL; FOR 6-32 CLEARANCE; SHEET 1 OF 1; SCALE: 1:1; WEIGHT:; DWG. NO.; REV

FOR M3 CLEARANCE
2 NEAR SIDE 2 FAR SIDE

MANUFACTURE TO DATA

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

CHECKED | | | TITLE: ENCLOSURE BOTTOM

ENG APPR.
MFG APPR.

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

INTERPRET GEOMETRIC TOLERANCING PER: | Q.A.

MATERIAL
CARBON FIBER ABS
NONE FINISH

DO NOT SCALE DRAWING
