EmbeddedSystemClass/2019-Animal-Collars/Electrical Source/Hardware/Fabrication Files/Small Collar/smallCollar_AA_assembly.pdf

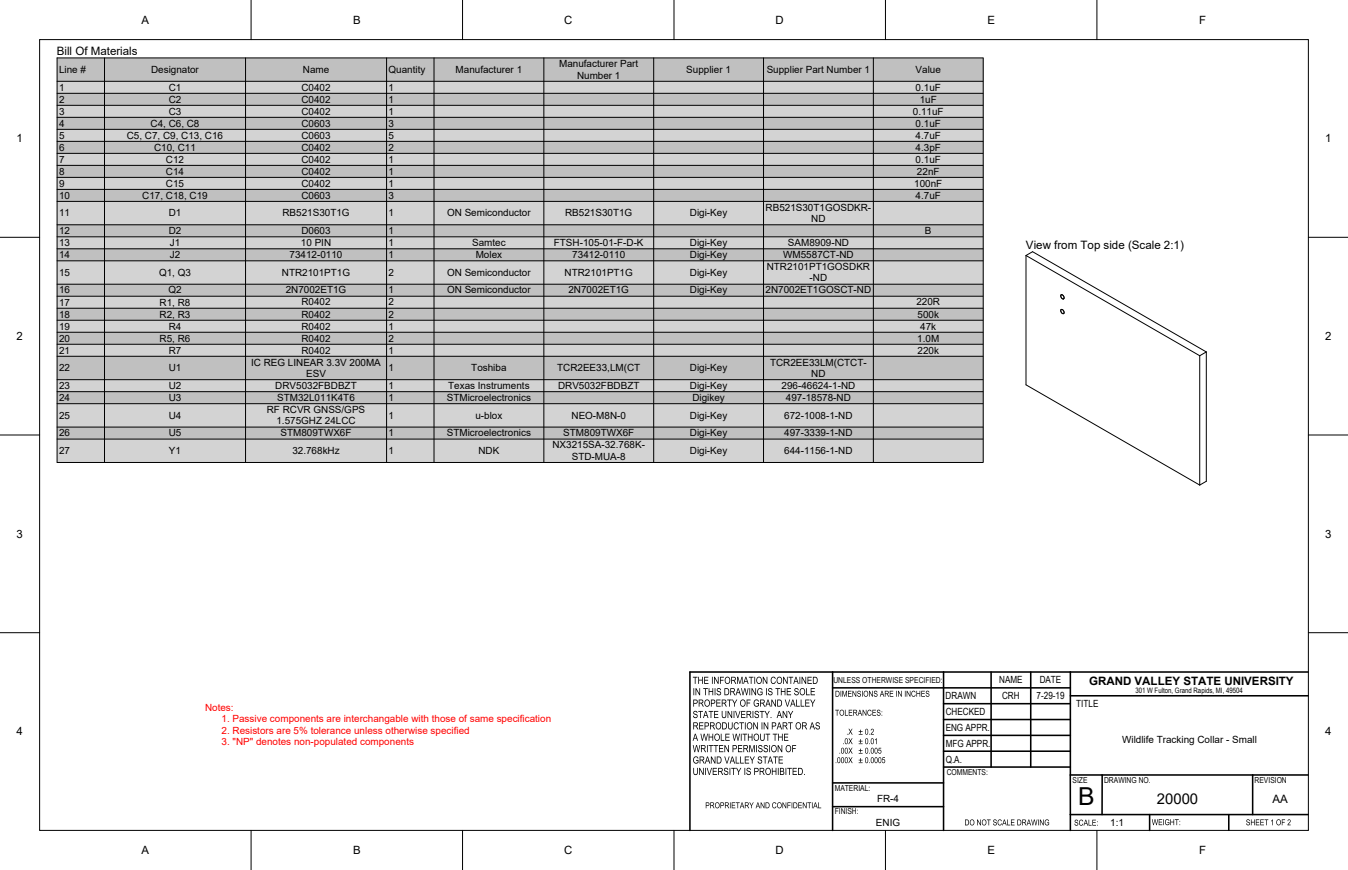
[picture p60: page 1]

Line # | Designator | Name | Quantity | Manufacturer 1 | Manufacturer Part Number 1 | Supplier 1 | Supplier Part Number 1 | Value

1 | C1 | C0402 | 1 | | | | | 0.1uF
2 | C2 | C0402 | 1 | | | | | 1uF
3 | C3 | C0402 | 1 | | | | | 0.11uF
4 | C4, C6, C8 | C0603 | 3 | | | | | 0.1uF
5 | C5, C7, C9, C13, C16 | C0603 | 5 | | | | | 4.7uF
6 | C10, C11 | C0402 | 2 | | | | | 4.3pF
7 | C12 | C0402 | 1 | | | | | 0.1uF
8 | C14 | C0402 | 1 | | | | | 22nF
9 | C15 | C0402 | 1 | | | | | 100nF
10 | C17, C18, C19 | C0603 | 3 | | | | | 4.7uF
11 | D1 | RB521S30T1G | 1 | ON Semiconductor | RB521S30T1G | Digi-Key | RB521S30T1GOSDKR-ND

12 | D2 | D0603 | 1 | | | | | B
13 | J1 | 10 PIN | 1 | Samtec | FTSH-105-01-F-D-K | Digi-Key | SAM8909-ND
14 | J2 | 73412-0110 | 1 | Molex | 73412-0110 | Digi-Key | WM5587CT-ND
15 | Q1, Q3 | NTR2101PT1G | 2 | ON Semiconductor | NTR2101PT1G | Digi-Key | NTR2101PT1GOSDKR -ND

View from Top side (Scale 2:1)

16 | Q2 | 2N7002ET1G | 1 | ON Semiconductor | 2N7002ET1G | Digi-Key | 2N7002ET1GOSCT-ND
17 | R1, R8 | R0402 | 2 | | | | | 220R
18 | R2, R3 | R0402 | 2 | | | | | 500k
19 | R4 | R0402 | 1 | | | | | 47k
20 | R5, R6 | R0402 | 2 | | | | | 1.0M
21 | R7 | R0402 | 1 | | | | | 220k
22 | U1 | IC REG LINEAR 3.3V 200MA ESV | 1 | Toshiba | TCR2EE33,LM(CT | Digi-Key | TCR2EE33LM(CTCT-ND

23 | U2 | DRV5032FBDBZT | 1 | Texas Instruments | DRV5032FBDBZT | Digi-Key | 296-46624-1-ND
24 | U3 | STM32L011K4T6 | 1 | STMicroelectronics | | Digikey | 497-18578-ND
25 | U4 | RF RCVR GNSS/GPS 1.575GHZ 24LCC | 1 | u-blox | NEO-M8N-0 | Digi-Key | 672-1008-1-ND

26 | U5 | STM809TWX6F | 1 | STMicroelectronics | STM809TWX6F | Digi-Key | 497-3339-1-ND
27 | Y1 | 32.768kHz | 1 | NDK | NX3215SA-32.768K-STD-MUA-8 | Digi-Key | 644-1156-1-ND

GRAND VALLEY STATE UNIVERSITY

DRAWN | CRH | 7-29-19
CHECKED
ENG APPR.
MFG APPR.
Q.A.

301 W Fulton, Grand Rapids, MI, 49504

Notes:
1. Passive components are interchangable with those of same specification
2. Resistors are 5% tolerance unless otherwise specified
3. "NP" denotes non-populated components

Wildlife Tracking Collar - Small

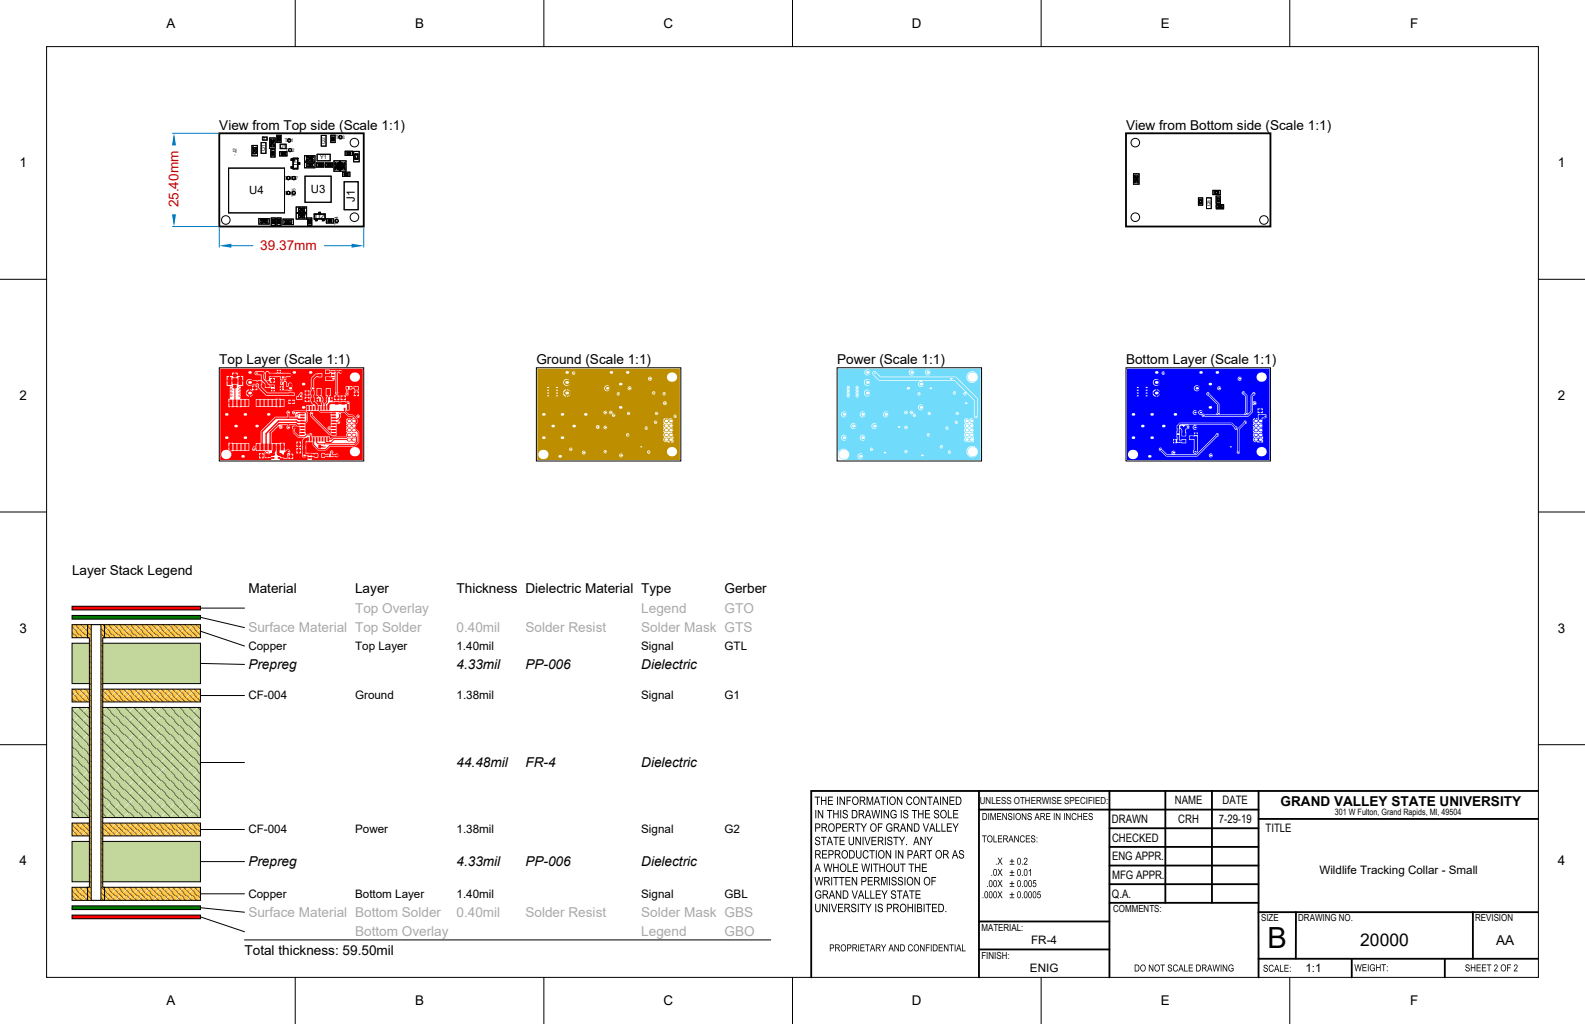
[picture p61: page 2]

View from Top side (Scale 1:1)

View from Bottom side (Scale 1:1)

GRAND VALLEY STATE UNIVERSITY

301 W Fulton, Grand Rapids, MI, 49504

Wildlife Tracking Collar - Small
