EmbeddedSystemClass/2019-Animal-Collars/Electrical Source/Hardware/Fabrication Files/Small Collar/smallCollar_AA_schematics.pdf

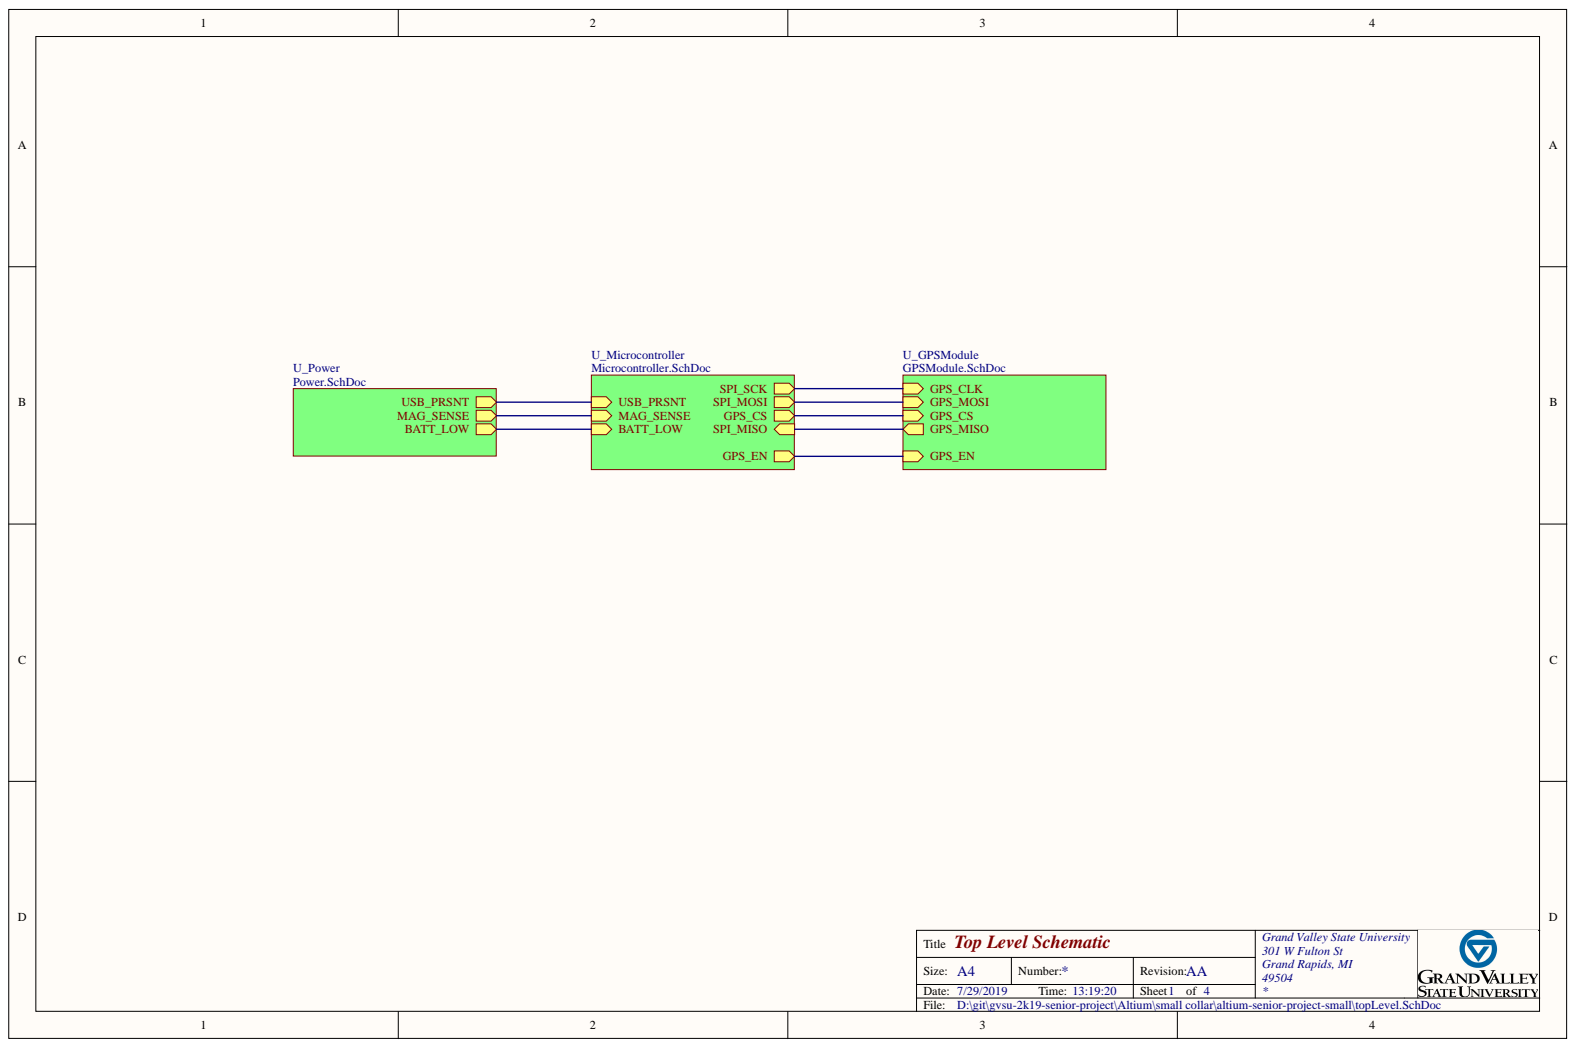
[picture p62: page 1]

Top Level Schematic Title | Grand Valley State University 301 W Fulton St Grand Rapids, MI 49504 *

A4 Size: | * Number: | AA Revision:

Date: 7/29/2019 Time: 13:19:20 | | Sheet 1 of 4
File: D:\git\gvsu-2k19-senior-project\Altium\small collar\altium-senior-project-small\topLevel.SchDoc

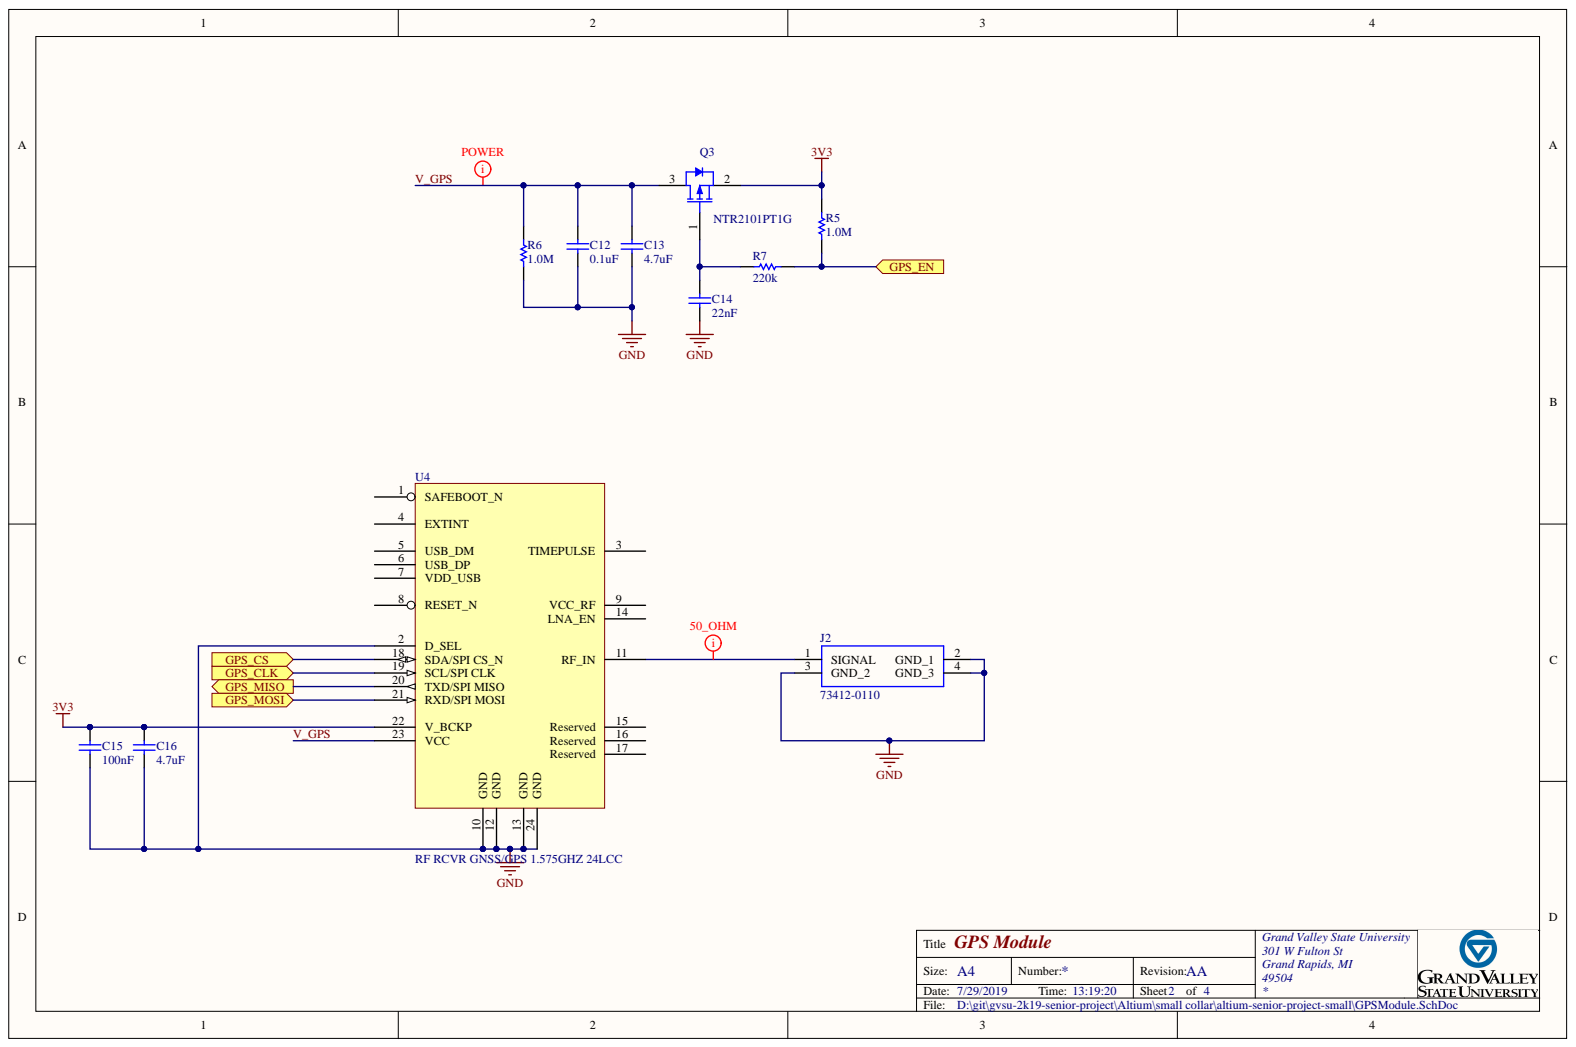
[picture p63: page 2]

RF RCVR GNSS/GPS 1.575GHZ 24LCC

GPS Module Title | Grand Valley State University 301 W Fulton St Grand Rapids, MI 49504 *

A4 Size: | * Number: | AA Revision:

Date: 7/29/2019 Time: 13:19:20 | | Sheet 2 of 4
File: D:\git\gvsu-2k19-senior-project\Altium\small collar\altium-senior-project-small\GPSModule.SchDoc

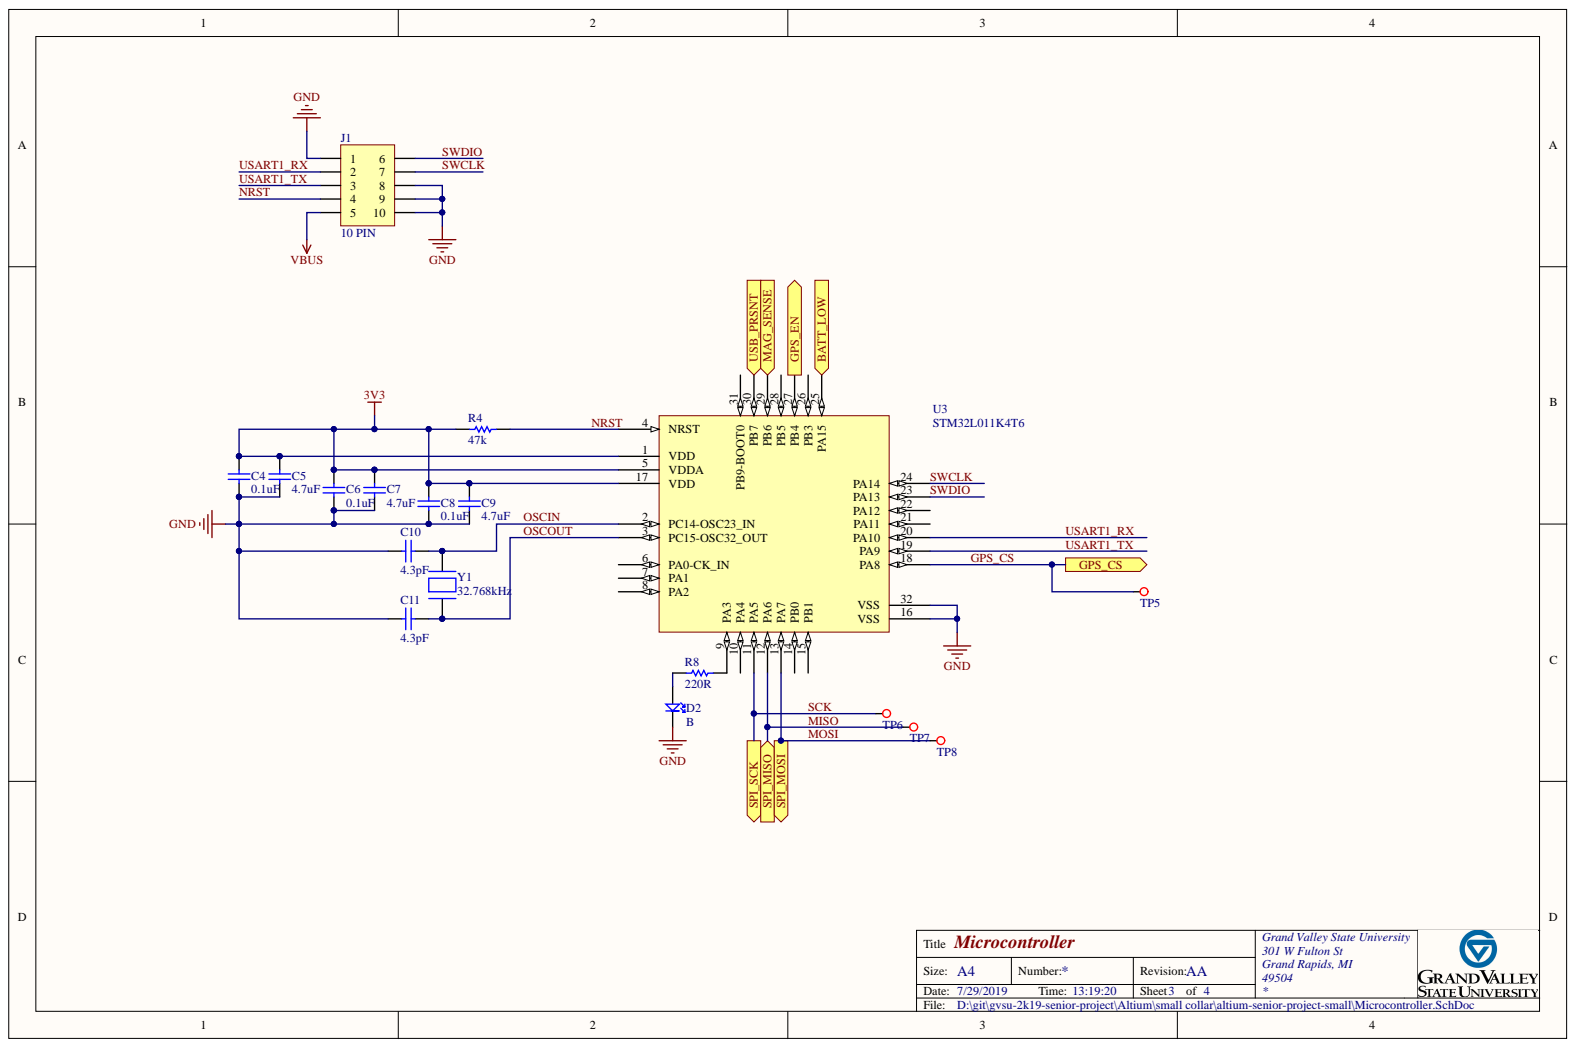
[picture p64: page 3]

47k | VDD 1

VDDA 5
VDD 17

OSCOUT | PC15-OSC32_OUT 3

Microcontroller Title | Grand Valley State University 301 W Fulton St Grand Rapids, MI 49504 *

A4 Size: | * Number: | AA Revision:

Date: 7/29/2019 Time: 13:19:20 | | Sheet 3 of 4
File: D:\git\gvsu-2k19-senior-project\Altium\small collar\altium-senior-project-small\Microcontroller.SchDoc

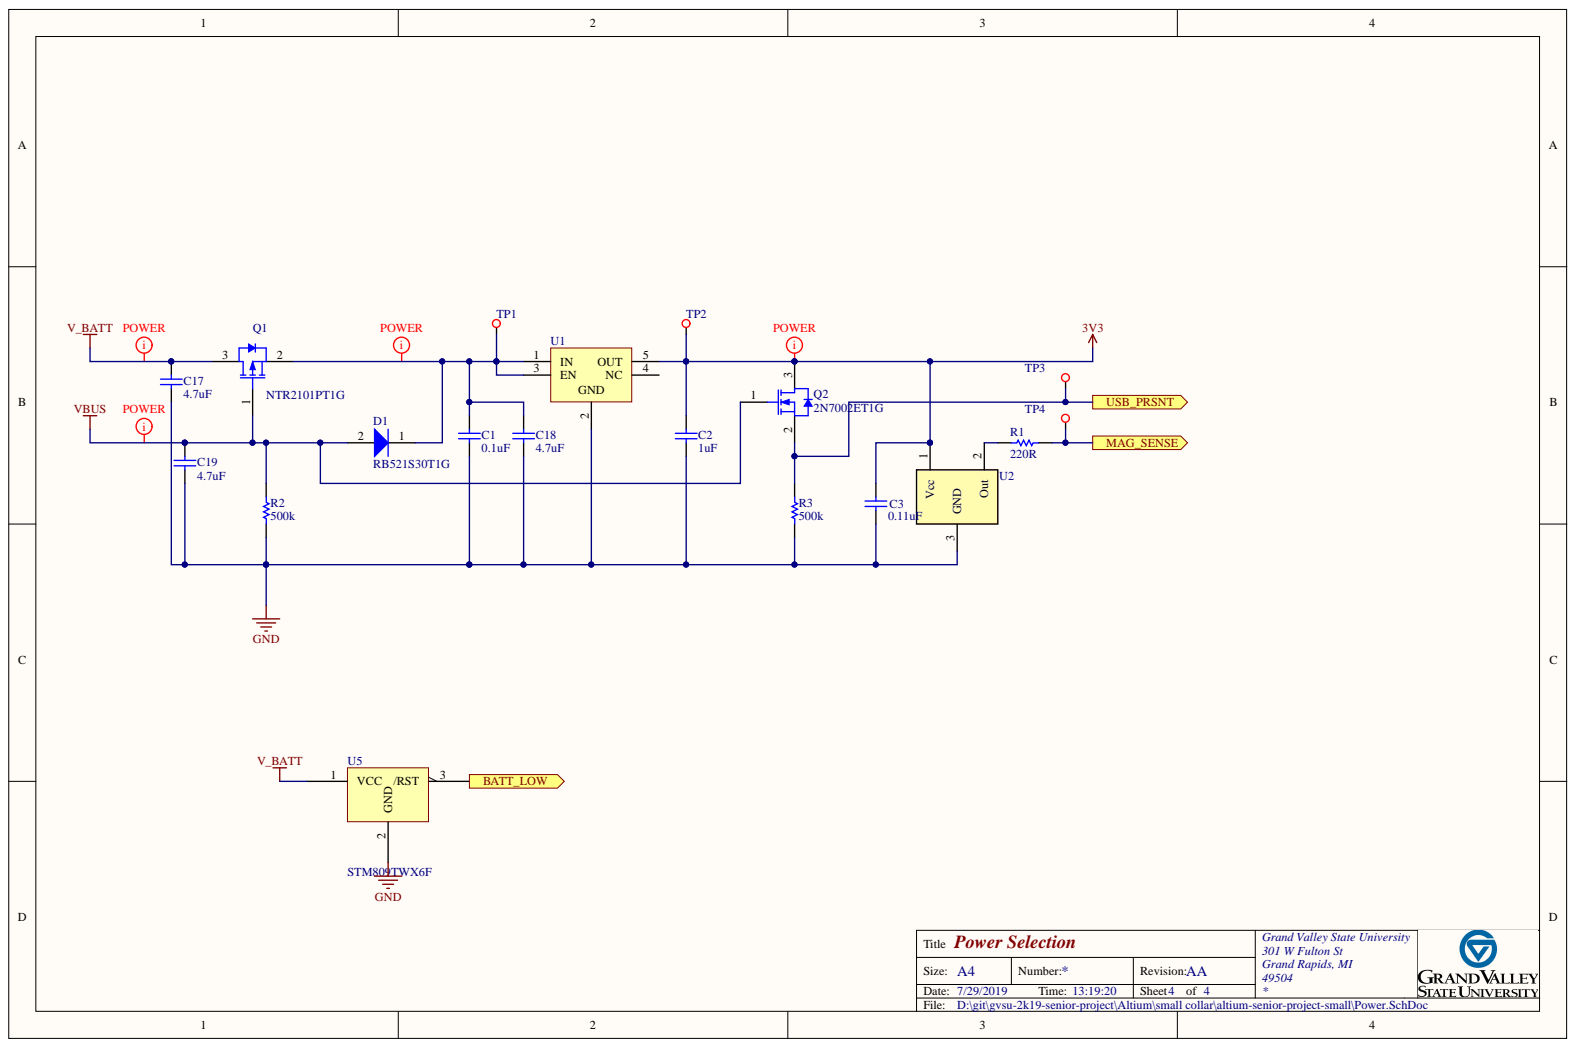
[picture p65: page 4]

Power Selection Title | Grand Valley State University 301 W Fulton St Grand Rapids, MI 49504 *

A4 Size: | * Number: | AA Revision:

Date: 7/29/2019 Time: 13:19:20 | | Sheet 4 of 4
File: D:\git\gvsu-2k19-senior-project\Altium\small collar\altium-senior-project-small\Power.SchDoc
