EmbeddedSystemClass/2019-Animal-Collars/COLLAR STRAP_PDF/COLLAR STRAP_V3/SHORT_STRAP 002_V3.PDF

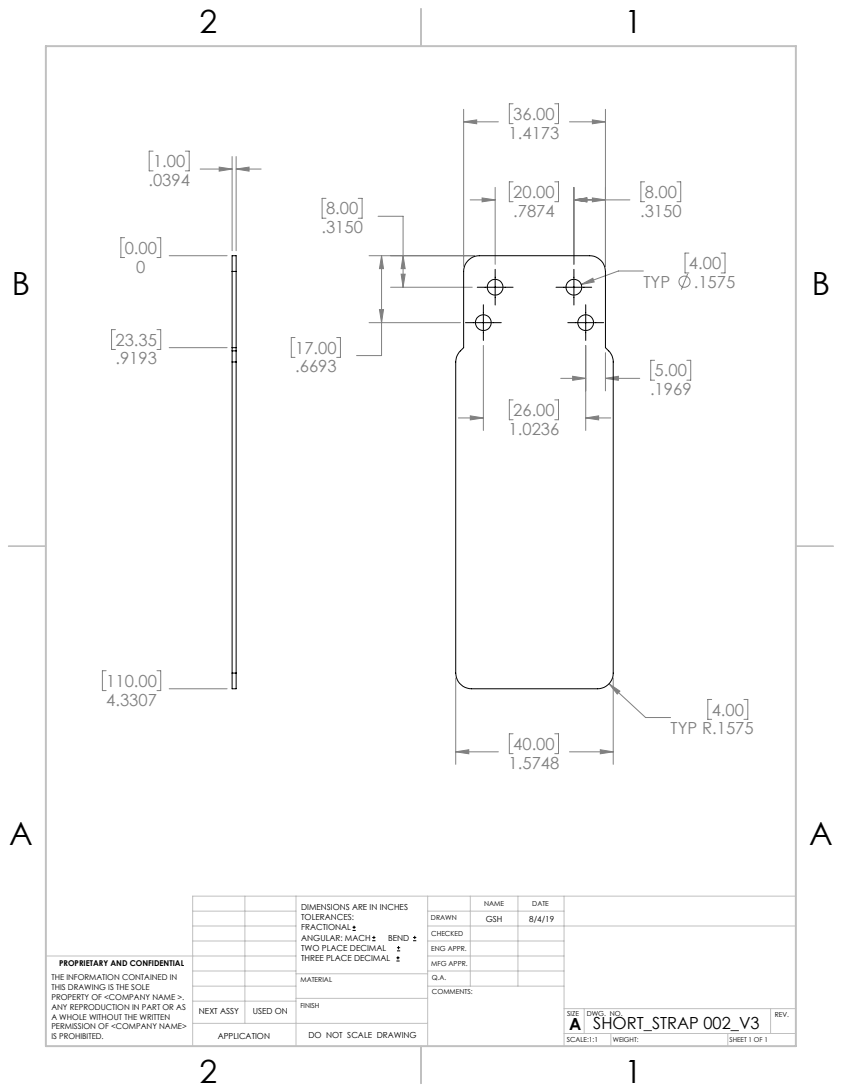
[picture p66: page 1]
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

DRAWN | GSH | 8/4/19
CHECKED
ENG APPR.

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

MATERIAL | Q.A.

NEXT ASSY | USED ON | FINISH

SIZE A | DWG. NO. SHORT_STRAP 002_V3 | REV.

APPLICATION | | DO NOT SCALE DRAWING

SCALE:1:1 | WEIGHT: | SHEET 1 OF 1
