EmbeddedSystemClass/2019-Animal-Collars/COLLAR STRAP_OBSOLETE/110MM STRAP_OBSOLETE.pdf

ITEM NO. | PART NUMBER | DESCRIPTION | QTY.
1 | 110MM STRAP 001 | | 2

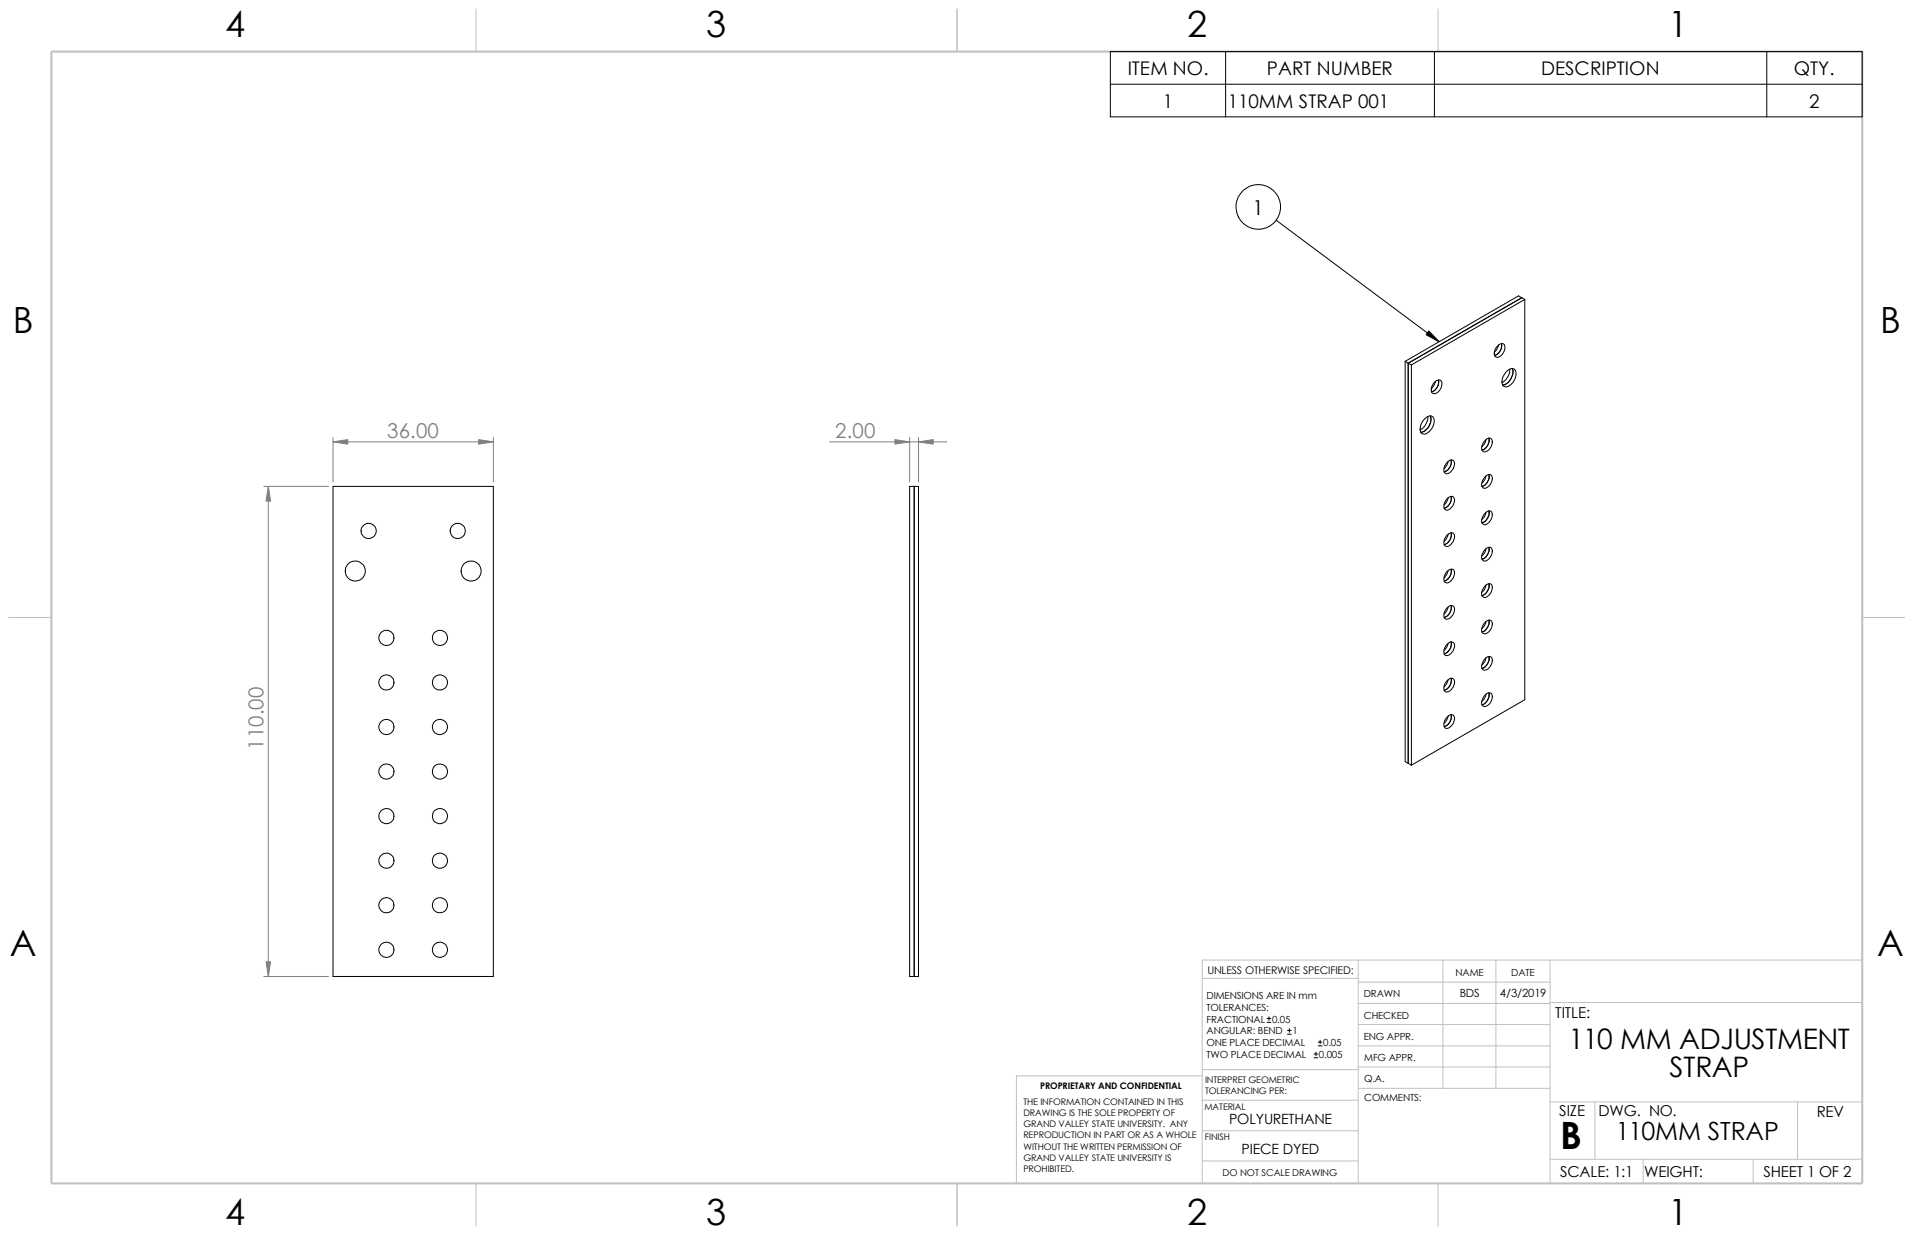
[picture p67: page 1]
110MM STRAP; SHEET 1 OF 2; SCALE: 1:1; WEIGHT:; DWG. NO.; REV; SIZE; COMMENTS:; PIECE DYED; POLYURETHANE; FINISH; MATERIAL

UNLESS OTHERWISE SPECIFIED: | | NAME | DATE
DIMENSIONS ARE IN mm TOLERANCES: FRACTIONAL 0.05 ANGULAR: BEND 1 ONE PLACE DECIMAL 0.05 TWO PLACE DECIMAL 0.005 | DRAWN | BDS | 4/3/2019

CHECKED | | | TITLE: 110 MM ADJUSTMENT STRAP

ENG APPR.
MFG APPR.

PROPRIETARY AND CONFIDENTIAL
THE INFORMATION CONTAINED IN THIS
DRAWING IS THE SOLE PROPERTY OF
GRAND VALLEY STATE UNIVERSITY. ANY
REPRODUCTION IN PART OR AS A WHOLE
WITHOUT THE WRITTEN PERMISSION OF
GRAND VALLEY STATE UNIVERSITY IS
PROHIBITED.

INTERPRET GEOMETRIC TOLERANCING PER: | Q.A.

DO NOT SCALE DRAWING

B B

4

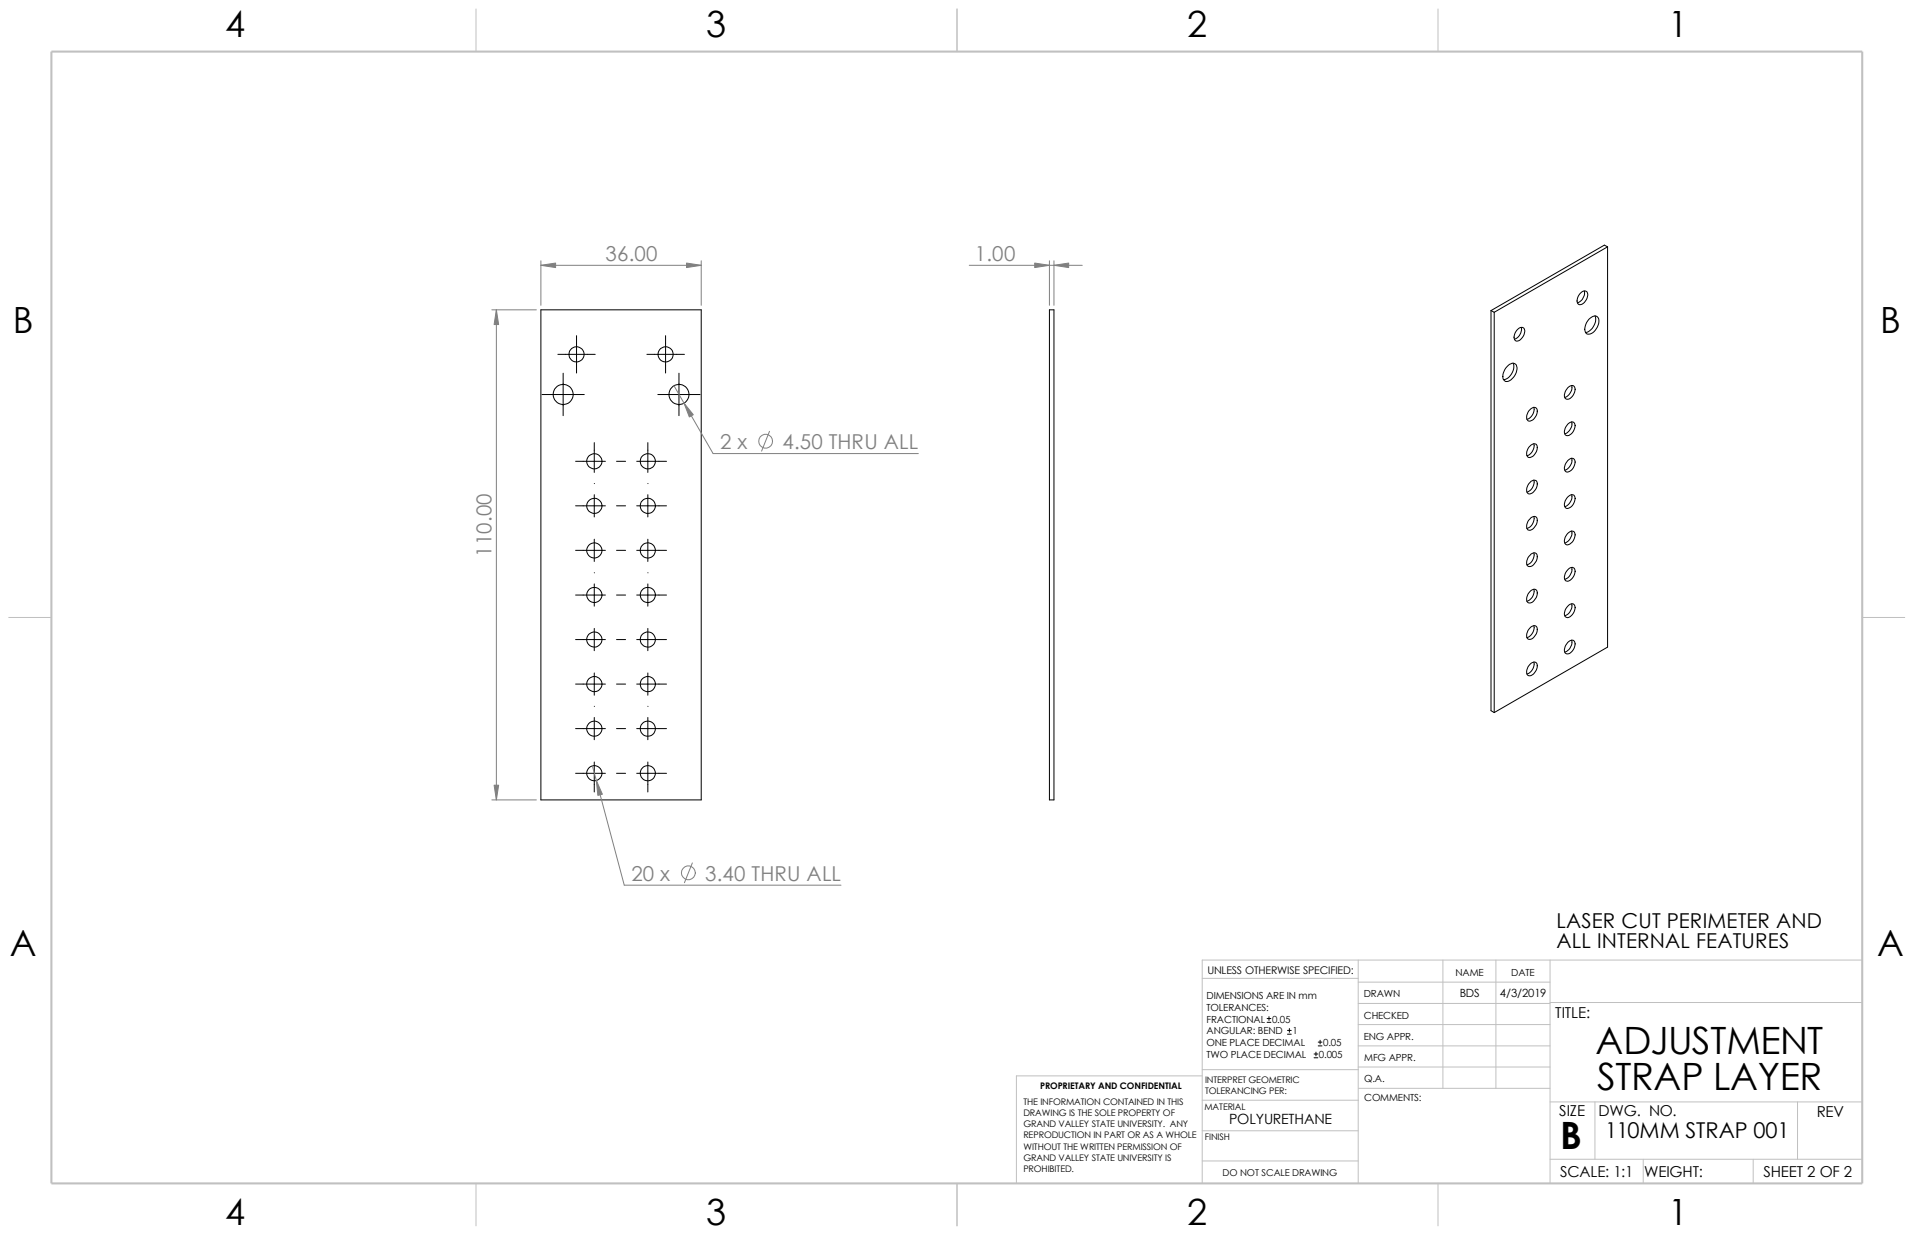
[picture p68: page 2]
POLYURETHANE; 110MM STRAP 001; SHEET 2 OF 2; SCALE: 1:1; WEIGHT:; DWG. NO.; REV; SIZE; COMMENTS:; FINISH; MATERIAL; 3.40 THRU ALL; 4.50 THRU ALL 110.00

LASER CUT PERIMETER AND
ALL INTERNAL FEATURES

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

CHECKED | | | TITLE: ADJUSTMENT STRAP LAYER

ENG APPR.
MFG APPR.

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

INTERPRET GEOMETRIC TOLERANCING PER: | Q.A.

DO NOT SCALE DRAWING
