EmbeddedSystemClass/2019-Animal-Collars/COLLAR STRAP_OBSOLETE/200mm strap.pdf

ITEM NO. | PART NUMBER | DESCRIPTION | QTY.
1 | 200MM STRAP 001 | ANTENNA PASSTHROUGH LAYER | 1

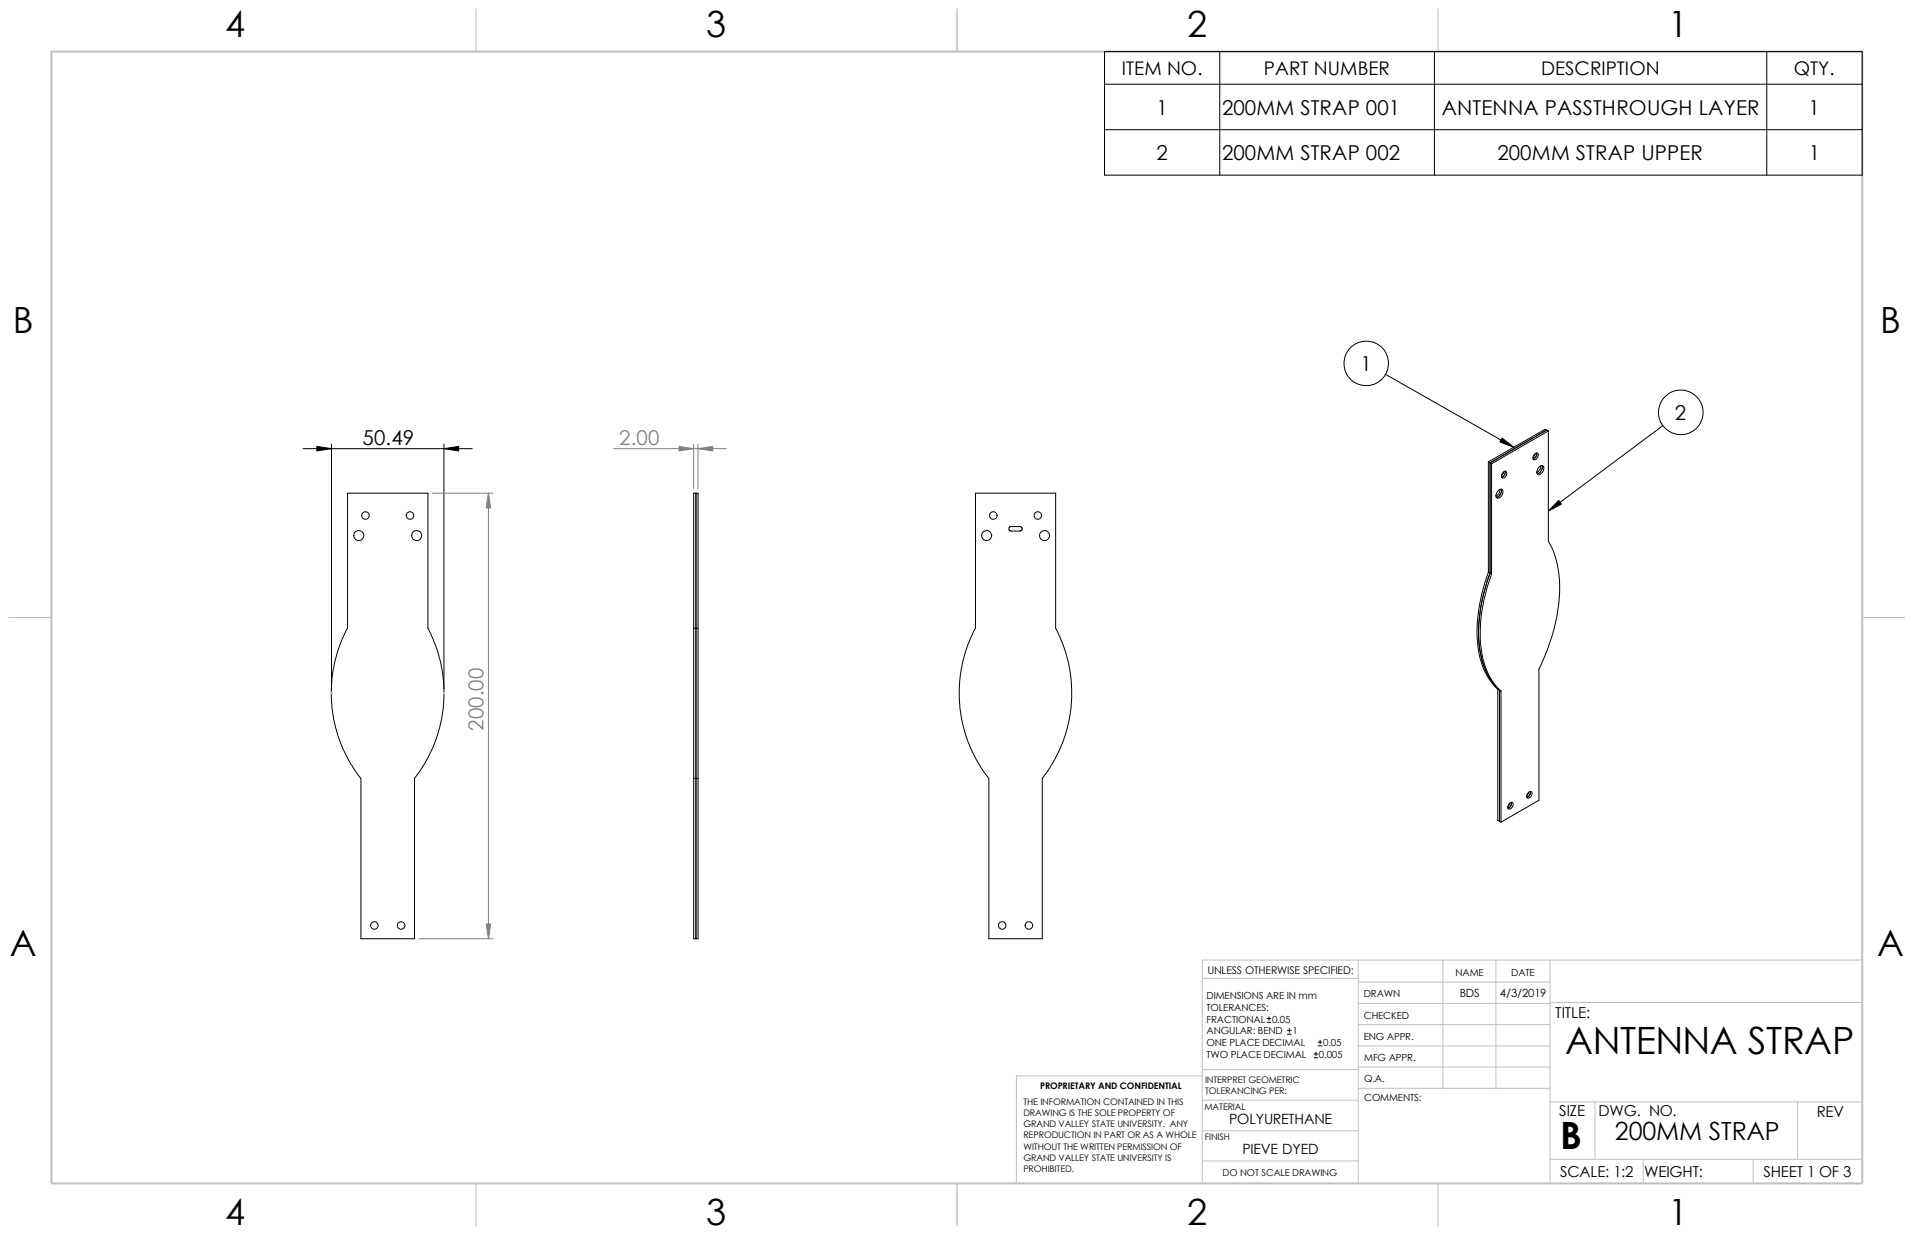
[picture p69: page 1]
POLYURETHANE; 200MM STRAP; SHEET 1 OF 3; SCALE: 1:2; WEIGHT:; DWG. NO.; REV; SIZE; COMMENTS:; PIEVE DYED; FINISH; MATERIAL

2 | 200MM STRAP 002 | 200MM STRAP UPPER | 1

UNLESS OTHERWISE SPECIFIED: | | NAME | DATE
DIMENSIONS ARE IN mm TOLERANCES: FRACTIONAL 0.05 ANGULAR: BEND 1 ONE PLACE DECIMAL 0.05 TWO PLACE DECIMAL 0.005 | DRAWN | BDS | 4/3/2019

CHECKED | | | TITLE: ANTENNA STRAP

ENG APPR.
MFG APPR.

INTERPRET GEOMETRIC PROPRIETARY AND CONFIDENTIAL

TOLERANCING PER: | Q.A.

THE INFORMATION CONTAINED IN THIS
DRAWING IS THE SOLE PROPERTY OF
GRAND VALLEY STATE UNIVERSITY. ANY
REPRODUCTION IN PART OR AS A WHOLE
WITHOUT THE WRITTEN PERMISSION OF
GRAND VALLEY STATE UNIVERSITY IS
PROHIBITED.

DO NOT SCALE DRAWING

50.49 1.00 200.00
B B

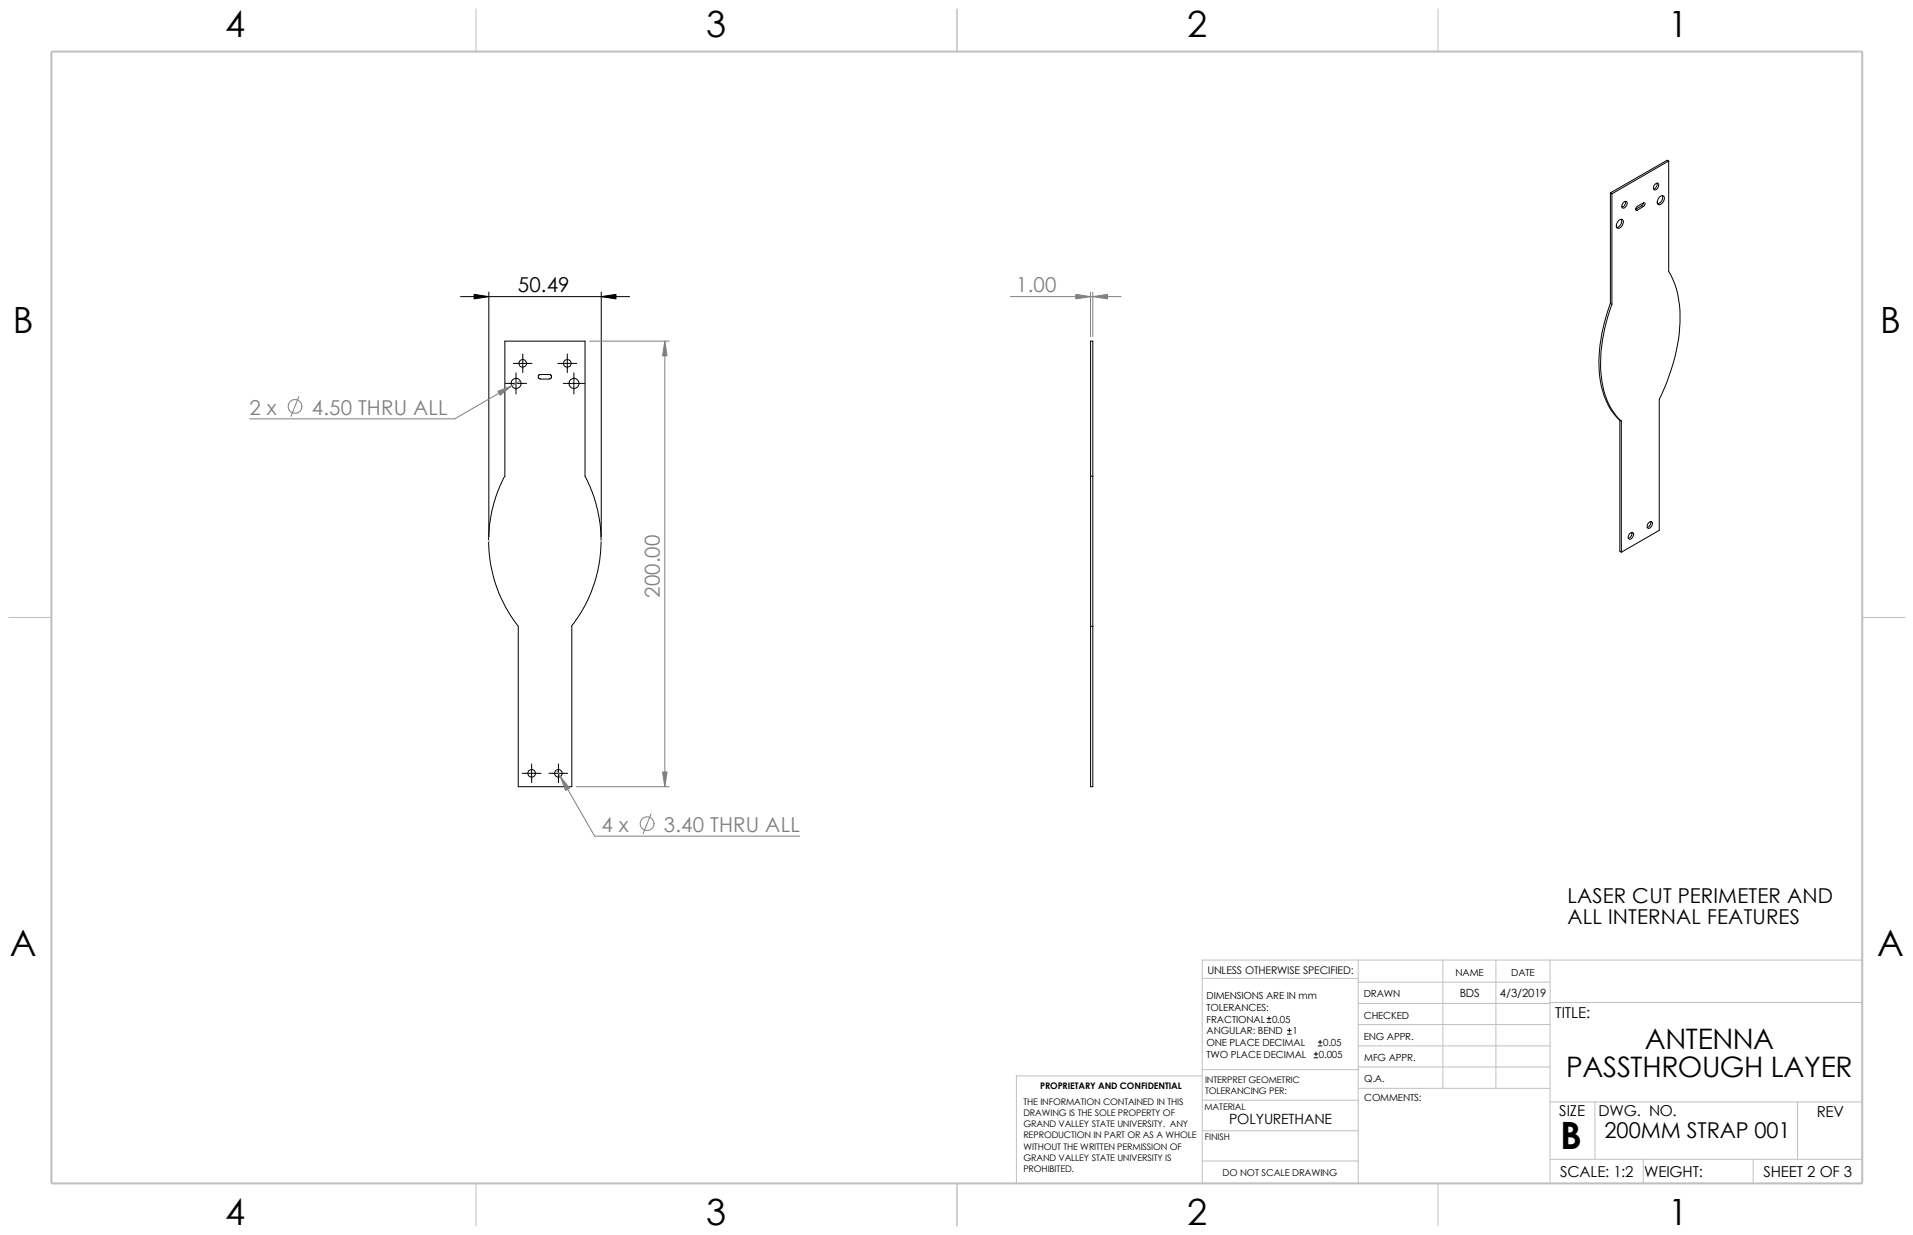
[picture p70: page 2]
3.40 THRU ALL; 4.50 THRU ALL; POLYURETHANE; 200MM STRAP 001; SHEET 2 OF 3; DWG. NO.; REV; SIZE; COMMENTS:; MATERIAL; PROHIBITED.

LASER CUT PERIMETER AND
ALL INTERNAL FEATURES

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

CHECKED | | | TITLE: ANTENNA PASSTHROUGH LAYER

ENG APPR.
MFG APPR.

PROPRIETARY AND CONFIDENTIAL
THE INFORMATION CONTAINED IN THIS
DRAWING IS THE SOLE PROPERTY OF
GRAND VALLEY STATE UNIVERSITY. ANY

INTERPRET GEOMETRIC TOLERANCING PER: | Q.A.

50.49

B B

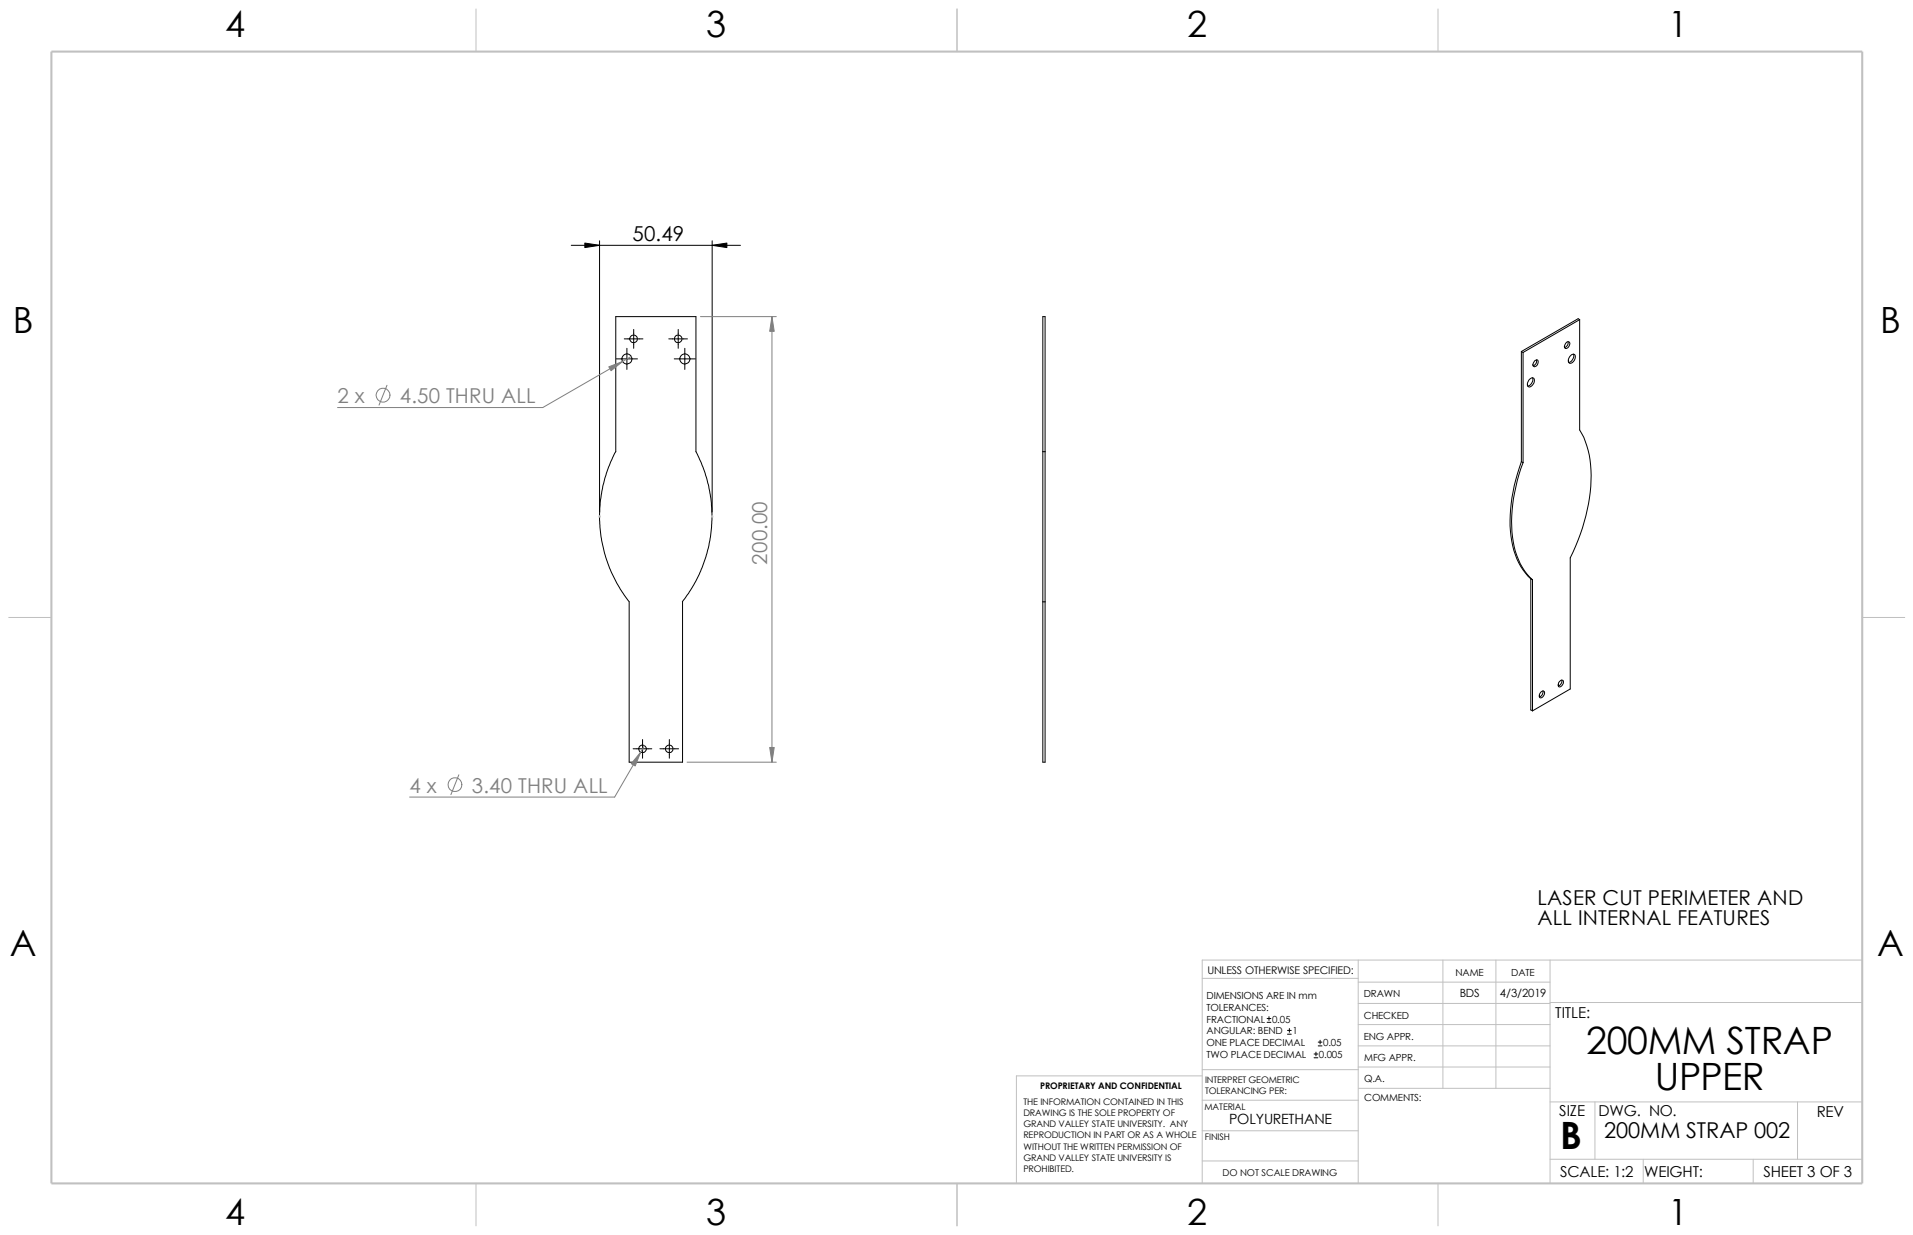
[picture p71: page 3]
POLYURETHANE; 200MM STRAP 002; SHEET 3 OF 3; DWG. NO.; REV; SIZE; COMMENTS:; MATERIAL; PROHIBITED. 200.00; 4.50 THRU ALL; 3.40 THRU ALL

LASER CUT PERIMETER AND
ALL INTERNAL FEATURES

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

CHECKED | | | TITLE: 200MM STRAP UPPER

ENG APPR.
MFG APPR.

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

INTERPRET GEOMETRIC TOLERANCING PER: | Q.A.
