EmbeddedSystemClass/2019-Animal-Collars/(list of files, drawings)

Other design files:
Electrical Source/Hardware/Altium Project Files/Large Collar/altum-senior-project-large.PrjPcb
Electrical Source/Hardware/Altium Project Files/Large Collar/GPSModule.SchDoc
Electrical Source/Hardware/Altium Project Files/Large Collar/largeCollar_AA.PcbDoc
Electrical Source/Hardware/Altium Project Files/Large Collar/Microcontroller.SchDoc
Electrical Source/Hardware/Altium Project Files/Large Collar/Power.SchDoc
Electrical Source/Hardware/Altium Project Files/Large Collar/Si4010 Beacon Adjusted.SchDoc
Electrical Source/Hardware/Altium Project Files/Large Collar/topLevel.SchDoc
Electrical Source/Hardware/Altium Project Files/Large Collar/XBeeModule.SchDoc
Electrical Source/Hardware/Altium Project Files/Programming Adaptor/main.PcbDoc
Electrical Source/Hardware/Altium Project Files/Programming Adaptor/main.SchDoc
Electrical Source/Hardware/Altium Project Files/Programming Adaptor/prog Adaptor.PrjPcb
Electrical Source/Hardware/Altium Project Files/Small Collar/altium-senior-project-small.PrjPcb
Electrical Source/Hardware/Altium Project Files/Small Collar/GPSModule.SchDoc
Electrical Source/Hardware/Altium Project Files/Small Collar/Microcontroller.SchDoc
Electrical Source/Hardware/Altium Project Files/Small Collar/Power.SchDoc
Electrical Source/Hardware/Altium Project Files/Small Collar/smallCollar_AA.PcbDoc
Electrical Source/Hardware/Altium Project Files/Small Collar/topLevel.SchDoc
