EmbeddedSystemClass/2019-Animal-Collars/Electrical Source/Firmware/Inc/main.h

#define LED0_Pin LL_GPIO_PIN_3
#define LED0_GPIO_Port GPIOA
#define GPS_CS_Pin LL_GPIO_PIN_8
#define GPS_CS_GPIO_Port GPIOA
#define VHF_EN_Pin LL_GPIO_PIN_3
#define VHF_EN_GPIO_Port GPIOB
#define GPS_EN_Pin LL_GPIO_PIN_4
#define GPS_EN_GPIO_Port GPIOB
#define XBEE_EN_Pin LL_GPIO_PIN_5
#define XBEE_EN_GPIO_Port GPIOB
#define MAG_SENSE_Pin LL_GPIO_PIN_6
#define MAG_SENSE_GPIO_Port GPIOB
#define USB_PRSNT_Pin LL_GPIO_PIN_7
#define USB_PRSNT_GPIO_Port GPIOB
#define LOW_BATT_Pin LL_GPIO_PIN_15
#define LOW_BATT_GPIO_Port GPIOA
#define NVIC_PRIORITYGROUP_0         ((uint32_t)0x00000007) /*!< 0 bit  for pre-emption priority,
#define NVIC_PRIORITYGROUP_1         ((uint32_t)0x00000006) /*!< 1 bit  for pre-emption priority,
#define NVIC_PRIORITYGROUP_2         ((uint32_t)0x00000005) /*!< 2 bits for pre-emption priority,
#define NVIC_PRIORITYGROUP_3         ((uint32_t)0x00000004) /*!< 3 bits for pre-emption priority,
#define NVIC_PRIORITYGROUP_4         ((uint32_t)0x00000003) /*!< 4 bits for pre-emption priority,
