EmbeddedSystemClass/2019-Animal-Collars/(commit log)

2019-07-26 CAD files and drawings for medium enclosure
2019-07-26 Corrected File Structure
    Phase 1
    [comport.c, comport.h, flash.c, flash.h, gps.c, gps.h]
2019-07-27 unzipped all the files and made them individually accessible
    [2019_Animal_Collar_Assm.DXF, 2019_Animal_Collar_Assm.SLDASM, 2019_Animal_Collar_Assm.SLDDRW, EPDM_Gasket.DXF, EPDM_Gasket.SLDDRW, EPDM_Gasket.SLDPRT, Enclosure_Lid.DXF, Enclosure_Lid.SLDDRW]
2019-07-27 Low Power work
2019-07-29 Added Altium Files & Restructured
    [2019_Animal_Collar_Assm.DXF, 2019_Animal_Collar_Assm.SLDASM, 2019_Animal_Collar_Assm.SLDDRW, EPDM_Gasket.DXF, EPDM_Gasket.SLDDRW, EPDM_Gasket.SLDPRT, Enclosure_Lid.DXF, Enclosure_Lid.SLDDRW]
2019-07-31 Corrected bug in scheduler
    Now runs for more than an hour (theoretically)
    [comport.c, scheduler.c]
2019-08-01 Corrected Scheduler.c
    again. better this time.
    [gps.h, scheduler.c]
2019-08-05 added small clip for small collar magnet
    [Magnet Clipsmall.DXF, Magnet Clipsmall.SLDPRT, Magnet Clipsmall.STL]
2019-08-06 Removed LED from XBEE routine
2019-08-06 Commit of User Programming Software
    Initial Commit
    [ExampleCSV_With_ConversionEquation.xlsx, PowerCalc.xlsx]
2019-09-28 Collar Strap Files (#1)
    ALL Files for collar strap
    [110MM STRAP 001.SLDPRT, 110MM STRAP 001_LaserCut.SLDDRW, 110MM STRAP 001_ManualCut.SLDDRW, 110MM STRAP 001_OBSOLETE.SLDPRT, 110MM STRAP 001_OBSOLETE_ManualCut.SLDDRW, 110MM STRAP.DXF, 110MM STRAP_OBSOLETE.SLDDRW, 200MM STRAP 001.SLDPRT]
